genbean/UH1-Collective/Software/docs/as5600.md

# AS5600 angle sensors

An AS5600 is a magnetic angle sensor: a chip under a small magnet on a turning shaft. Given the angle range it should cover, a sensor set for, say, 35° of collective travel uses the **whole** of its reading for those 35°, instead of the tenth of it that 35° is out of a full turn. The HeliSR Rev 4.0 board reads the sensor over I²C on any AX port. The board keeps the range and writes it to the sensor every time it starts: nothing is burnt into the chip, and the range can be set again at any time.

> **Not tried on hardware yet.** No Rev 4.0 board has been built. The firmware's sensor code is tested on the PC against a model of the board's I²C switch and the AS5600 (see [Development](development.md#testing)), but not against real chips and cables.

The board has a **PCA9546A I²C switch**: every AS5600 has the same address, so each AX port has its own channel, and the firmware reads one port at a time. It reads each sensor's **ANGLE** register, which runs 0–4095 across the range set, and scales it to the same 0–4092 as an analog input. The start and stop are written to the chip's working registers (ZPOS and MPOS) every time the board starts, from settings the board keeps in its EEPROM. With them, the chip's settings register (CONF) is set to its factory state: full power, the standard filtering, no watchdog. So a module that someone has configured differently, even burnt, still reads the same. **Nothing is ever burnt into the chip**, so the range can be set as often as you like.

## Preparing the module

For the common WWZMDiB module (23 × 23 mm, Amazon B0CM3C8KFT), on the Pro Micro's 5 V (the board README's [AS5600 modules](../../PCB/HeliSR/README.md#as5600-modules) has the details):

- **Remove R1**, the 0 Ω link between VDD5V and VDD3V3. It puts 5 V on the chip's 3.3 V pin (absolute maximum 4.0 V). Without it, the chip's own regulator feeds that pin.
- **Remove R4**, the 1 kΩ from PGO (GPO) to GND: PGO low selects OUT-pin programming, where two 100 ms shorts of OUT to GND burn a range into the chip for good. Leave OUT unconnected.
- **Wire DIR** to GND or VCC; it floats on this module. It sets which way the angle rises (GND = clockwise, VCC = counterclockwise, seen from the chip's top face). If the angle falls from your start to your stop, the helper notices and sets the range the other way round (below).
- **Check the module's pull-ups** on SDA and SCL, with a meter, as the board README describes: none, 10 kΩ or 4.7 kΩ is fine; under 2 kΩ is too strong with the board's own 2.2 kΩ, so remove them. Remove them too if they go to the chip's 3.3 V pin rather than VCC.
- **Check for about 1 µF from VDD3V3 to GND** once R1 is off: on 5 V that pin is the chip's internal regulator output, which needs it. Add a 1 µF ceramic if the module has less.
- **Magnet:** a diametrically magnetised disc (5 × 2 mm is typical), centred over the chip, about 0.5–3 mm above it.

## Wiring

Any of **AX1–AX4 (J11–J14)**: pin 1 **SDA**, 2 **GND**, 3 **VCC** (5 V), 4 **SCL**. This is not the Qwiic / STEMMA QT order, on purpose: those boards are 3.3 V. On a long cable, twist SDA with GND and SCL with VCC.

## Setting the start and stop

On the **Board** page, with the board connected, each AX row says its sensor's state, and on the right is the **AS5600 sensors (I²C)** helper.

1. Assemble the mechanism with the sensor in place and plug the board into USB.
2. In the helper, pick the port. **State** should say **OK**, the **AGC** should be somewhere in the middle (it sits at an end when the magnet is too close or too far), and the **Raw angle** should follow the control.
3. Move the control to the end where the reading should start, and click **Set start**.
4. Move it to the other end, at least 18° away, and click **Set stop**. The helper follows the raw angle in between, so it knows which way you went and how far. The board saves the range at once, writes it to the sensor, and the state adds **range set on the sensor**.
5. The **Output** bar now runs from 0 at the start to 4095 at the stop. That's what the axis gets.
   - If the angle falls from your start to your stop (DIR is the other way), the helper sets the range the other way round and says so: the output then runs from 4095 at your start to 0 at your stop. Tick **Inverted** on the axes using that port, or wire DIR to the other side and set the range again.
6. Click **Use the sensor's whole output as the calibration** to set the calibration of every axis that uses that port to the full range (choose the port as an axis source on the Axes Config page first). Then **Write config to Device**.

**Whole circle** clears the range: the sensor reads 0–4095 over a full turn again. For a 360° control, set the wrap point with the axis's **Offset** instead.

The start and stop belong to the board, not to a profile: writing a profile, resetting the settings or updating the firmware leaves them alone. The helper saves them as soon as you click; there's no need to write the config for them.

## The I²C clock

**100 kHz** is the default and suits most cables. If a port with a long cable shows errors, choose **50 kHz** or **25 kHz** in the helper (10 kHz is there as a last resort). The board saves it at once. The firmware reads one port per pass, so a slower clock makes each pass longer: by about 1.7 ms at 100 kHz, 7 ms at 25 kHz and 17 ms at 10 kHz (calculated from the transfers, not measured). At 10 kHz the buttons and the USB reports slow down to match.

## Examples from the UH-1 collective

- **Collective, in the MkIII base, on AX1:** DIR to **VCC**. Set start with the collective fully **down**, set stop fully **up**.
- **Throttle, in the Huey head, on AX4:** DIR to **GND**. Set start at the **idle** stop, set stop at **full open**.

## Troubleshooting

| The state says | Why, and what to do |
|---|---|
| no sensor | Nothing answers on that port: check the cable, its pin order (SDA, GND, VCC, SCL) and the module's power. A sensor plugged in later gets its range as soon as it answers |
| no magnet / magnet too weak or too far | Move the magnet closer and centre it over the chip |
| magnet too strong or too close | Move it further away |
| the board's I²C switch doesn't answer | Every port says so: the PCA9546A or its pull-ups (R9–R11) aren't working. On a bare Pro Micro with HeliSR firmware this is normal |
| bus stuck: check this port's cable | Something on that port held a line low. The firmware resets the switch, leaves the port alone for a moment and carries on with the others. Check the cable for a short, and try a slower clock |
| errors keep counting on a long cable | Try a slower I²C clock, and check the pull-ups (the board README's [AS5600 modules](../../PCB/HeliSR/README.md#as5600-modules)) |
| range not set on the sensor yet | The board couldn't write the start and stop, or the chip didn't keep them; it tries again every few visits |

A chip whose range was burnt in before (through its OUT pin, or over I²C elsewhere) may still work once R4 is removed: the board writes its own start and stop over the burnt ones every time it starts. Whether a burnt chip keeps them hasn't been tried; if it doesn't, its state says "range not set on the sensor yet".
