genbean/UH1-Collective/Software/docs/development.md

# Development

How the HeliSR software is put together, built and tested. [`PLAN.md`](../PLAN.md) has the design decisions and what each phase found; [`NOTICE.md`](../NOTICE.md) lists the changes from FreeJoy.

## Folders

| Folder | What's in it |
|---|---|
| `firmware/HeliSR/` | The firmware, an Arduino sketch, for the HeliSR Rev 4.0 board: `board.cpp` has the board's pins, and `i2c.cpp` and `sensors.cpp` are its I²C bus, PCA9546A and AS5600s |
| `firmware/HeliSR/src/shared/` | The settings layout (`helisr_config.h`), factory settings (`helisr_defaults.h`) and USB protocol (`helisr_protocol.h`), compiled into both the firmware and the configurator |
| `firmware/build.ps1` | Builds the firmware |
| `firmware/test/` | Test tools for a Pro Micro: the settings channel and joystick (`hsr-usb-test.ps1`), flashing through the bootloader command (`hsr-flash-via-bootloader.ps1`), a logic test (`hsr-logic-test.ps1`), and the lockstep replay of the PC tests (`hsr-lockstep.ps1`). Shared helpers are in `hsr-usb-lib.ps1` |
| `firmware/test/host/` | The PC tests: the firmware's logic compiled for the PC, the scenario tests, the comparison with FreeJoy's own code, and the sensor code against a simulated I²C bus (`sensor_tests.cpp`) |
| `configurator/` | HeliSR Configurator, forked from FreeJoyConfiguratorQt. See [its README](../configurator/README.md) |
| `profiles/` | The example profiles and the script that makes them |
| `packaging/` | The release build, installer script and release checklist. See [its README](../packaging/README.md) |
| `docs/` | These pages |

## Building the firmware

You need the Arduino IDE 2.x, with "Arduino AVR Boards" installed (it comes with the IDE). Then, in PowerShell:

```powershell
cd Software\firmware
.\build.ps1             # the release build: 5 V / 16 MHz Pro Micro, no USB serial port
.\build.ps1 -Serial     # with the Arduino USB serial port, so the Arduino IDE can upload without a double tap
.\build.ps1 -Port COM5  # build and upload
```

The `.hex` lands in `firmware\build\<variant>\HeliSR.ino.hex`: `noserial`, `serial` or `noserial-test`. The options combine. Only the 5 V / 16 MHz Pro Micro is supported.

The firmware is for the HeliSR Rev 4.0 board only (`HSR_BOARD_ID` in `shared/helisr_config.h`): the shift registers on A0, 14 and 15, the AS5600s over I²C, and the JTAG switch-off (A0 and A1 are also JTAG pins). Firmware for another board could drive the board's lines against its own chips, so every build carries a tag saying which board it's for (`hsr_build_tag_t`), INFO reports it, and the app refuses a device or a `.hex` tagged for another board.

The build uses the Arduino IDE's own `arduino-cli` and the Arduino AVR core 1.8.8 (`arduino:avr:leonardo`). The firmware registers its own USB functions (a joystick and a settings channel) through the core's PluggableUSB, so the core itself is unmodified.

## Building the configurator

Qt 6 with MinGW, then `qmake` and `mingw32-make`: see [configurator/README.md](../configurator/README.md#building).

## Building a release

`packaging\build-release.ps1` builds the firmware and the configurator, and packs them with Qt, avrdude, the example profiles and the licences into `HeliSR-Configurator-x.y.z-Setup.exe` and a portable zip. See [packaging/README.md](../packaging/README.md), which also has the release checklist.

## How the app and the firmware talk

The board is a USB composite device: a joystick that games read, and a vendor-defined HID collection (usage page 0xFF00) that only the configurator uses. Each settings packet is 64 bytes: report ID, command, index, status and 60 bytes of data, and the board answers every command. INFO comes first; the app refuses a board whose protocol version, settings version or settings size differs from its own, or whose board ID isn't HeliSR Rev 4.0's (0x40). Settings go over in 60-byte chunks (READ / WRITE), then COMMIT with a CRC-16; the board saves them to EEPROM and restarts so Windows sees the new name and layout. `helisr_protocol.h` has the details.

Three commands are for the AS5600s: SENSOR_STATUS (each AS5600's state, raw angle, output angle, AGC and error count, about 20 times a second while the app is open), SENSOR_CONFIG (the I²C clock and each sensor's start and stop) and SENSOR_DEBUG (one port's sensor read in full, every register as the chip sent it, with that port's counters; only while the helper's Diagnostics box is ticked, as each read holds the board up for a few ms). The sensor settings are kept in EEPROM apart from the main settings and saved at once, without a restart: they belong to the board's sensors, not to a profile. The live data's A2/A3 readings come after the older fields, which keep their places.

## Testing

**Firmware logic on the PC** (needs MinGW-w64 g++, for example Qt's: `aqt install-tool windows desktop tools_mingw1310 qt.tools.win64_mingw1310`):

```powershell
cd Software\firmware\test\host
.\run-host-tests.ps1                               # 416 checks: 192 of the firmware's logic, 224 of the sensor code
.\run-host-tests.ps1 -FreeJoy <FreeJoy checkout>   # also compare with FreeJoy's own code on random settings
```

The sensor checks run `sensors.cpp` against a model of the board's PCA9546A and an AS5600 on each channel: the channel of each port, the registers and byte order, the 1 ms waits between ZPOS, MPOS and CONF, the read-back, CONF set over settings burnt into a chip, that nothing is ever burnt, the diagnostics read and its counters, and what happens when a sensor is unplugged or restarts, the switch is missing, or the bus sticks. The model follows the datasheets as the code reads them, so it can't show that the chips agree: that waits for a Rev 4.0 board.

**The same scenarios on a Pro Micro**, in lockstep with the PC:

```powershell
cd Software\firmware
.\build.ps1 -Test                                  # then flash build\noserial-test\HeliSR.ino.hex
cd test
.\host\run-host-tests.ps1 -Trace host\build\trace.txt -Random 10
.\hsr-lockstep.ps1 -Trace host\build\trace.txt
```

Flash the normal build afterwards: the test firmware ignores the board's inputs once a lockstep run has started.

**The configurator:**

```
HeliSRConfigurator --ui-test 200                  random settings through every page and back (no board needed)
HeliSRConfigurator --ui-test-file a.cfg b.cfg     profiles through every page and back
HeliSRConfigurator --roundtrip                    write, read back and compare, then restore (needs a board)
HeliSRConfigurator --ui-device-test               the same through the window's Write and Read buttons
HeliSRConfigurator --hex-info file.hex            which board a firmware file is for
HeliSRConfigurator --sensor-roundtrip             the AS5600 settings saved, read back, kept through a restart, refused out of range, restored
HeliSRConfigurator --sensor-debug [1-4] [--clear] every register of each sensor (or one), decoded, with counters and hints
HeliSRConfigurator --ui-screenshot board.png      a picture of the Board page (with made-up sensor readings)
```

Run them after any change to the configurator or the shared headers. `--sensor-roundtrip` needs the firmware but no sensors: on a bare Pro Micro the settings still save, and every port reads "no switch".

## Example profiles

```powershell
cd Software\profiles
python make_profiles.py
```

It starts from `Default (16 buttons, 4 axes).cfg`. If the firmware's factory settings change, remake that first with `HeliSRConfigurator --save-defaults "Default (16 buttons, 4 axes).cfg"`.
