genbean/UH1-Collective/Base/renders/rev3_anchor.png

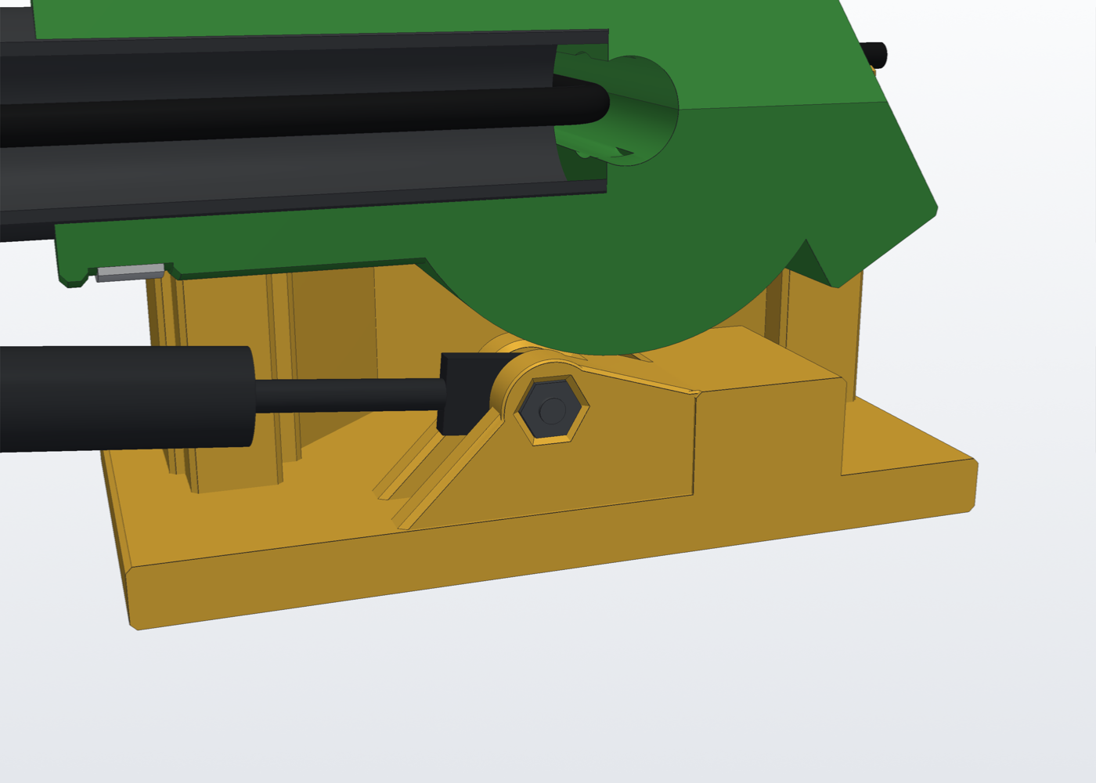
Base/renders/rev3_anchor.png
