genbean/UH1-Collective/Base/renders/rev3_base_front.png

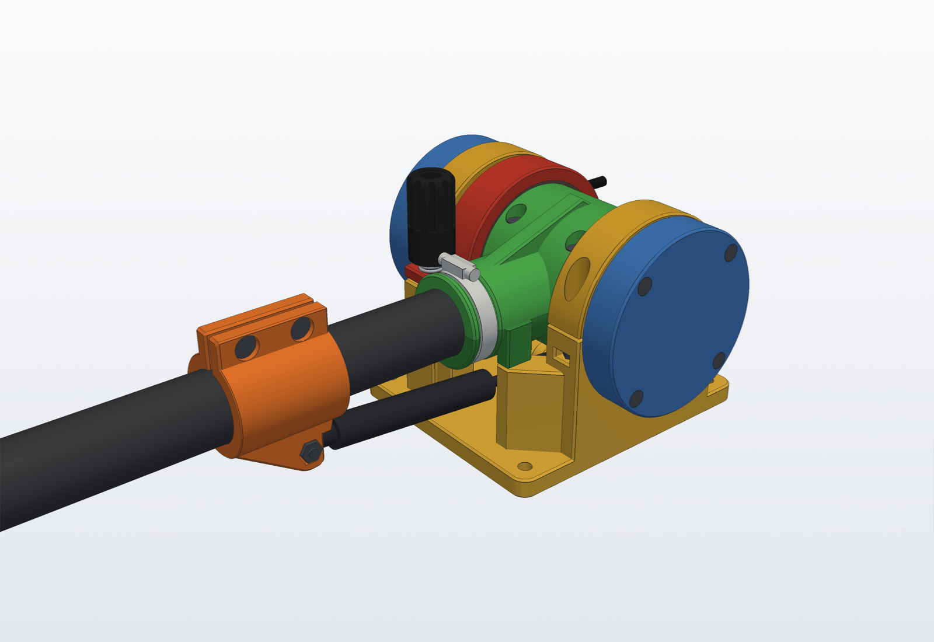
Base/renders/rev3_base_front.png
