genbean/UH1-Collective/Base/renders/rev3_base_rear.png

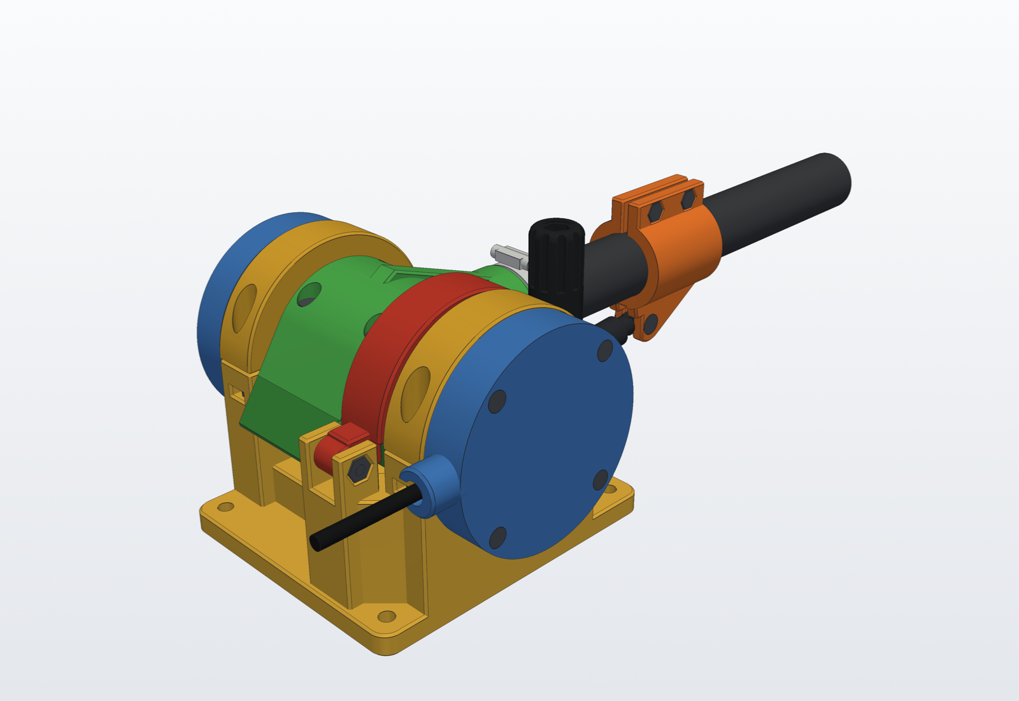
Base/renders/rev3_base_rear.png
