genbean/UH1-Collective/Base/renders/rev3_downstop.png

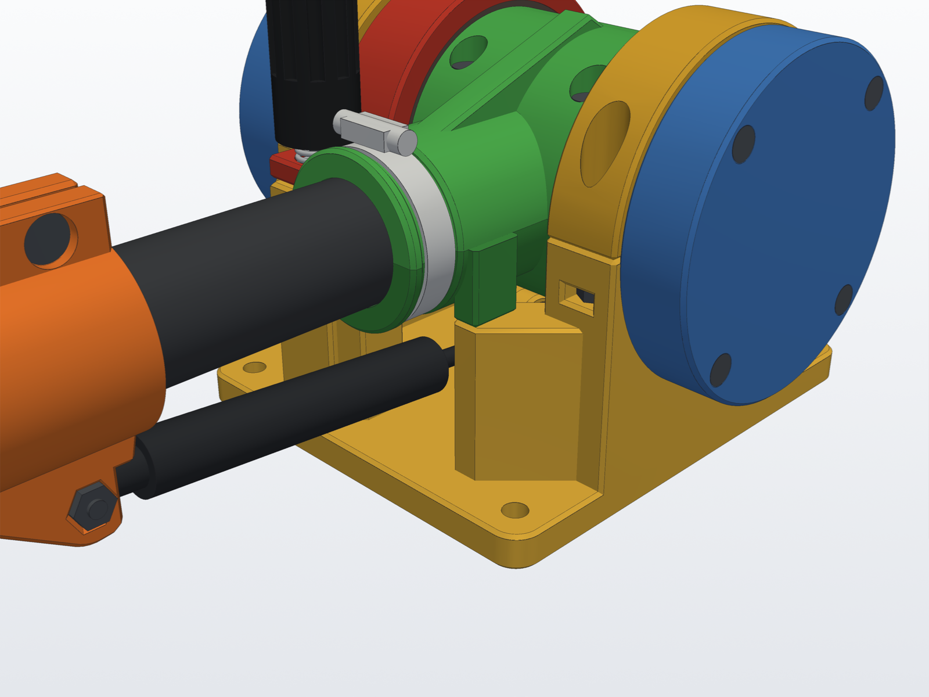
Base/renders/rev3_downstop.png
