genbean/UH1-Collective/Base/renders/rev3_exploded.png

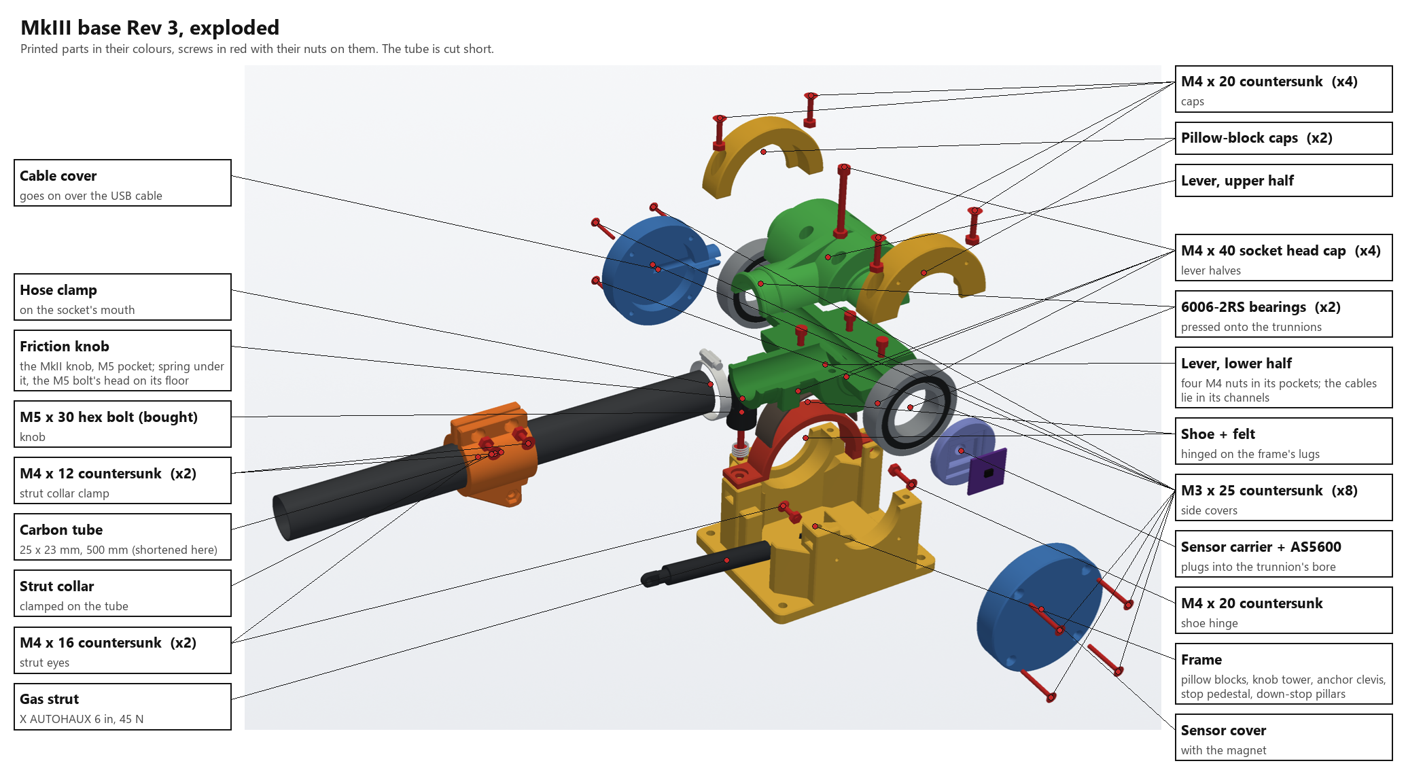
Base/renders/rev3_exploded.png
