genbean/UH1-Collective/Base/renders/rev3_frame_plan.png

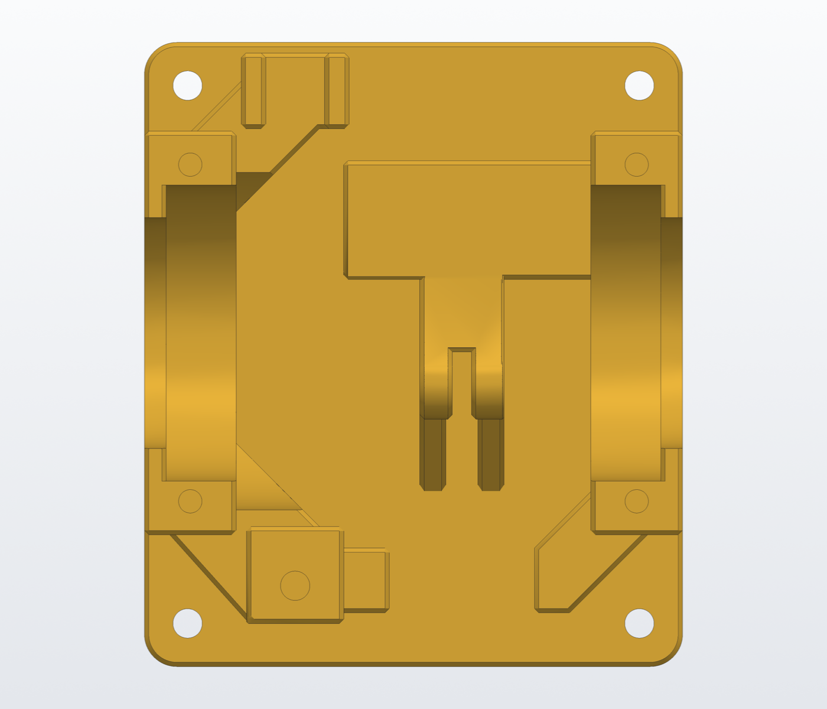
Base/renders/rev3_frame_plan.png
