genbean/UH1-Collective/Base/renders/rev3_full.png

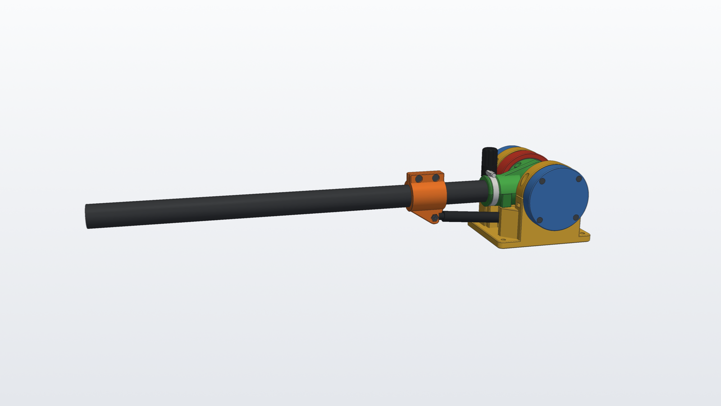
Base/renders/rev3_full.png
