genbean/UH1-Collective/Base/renders/rev3_hero.png

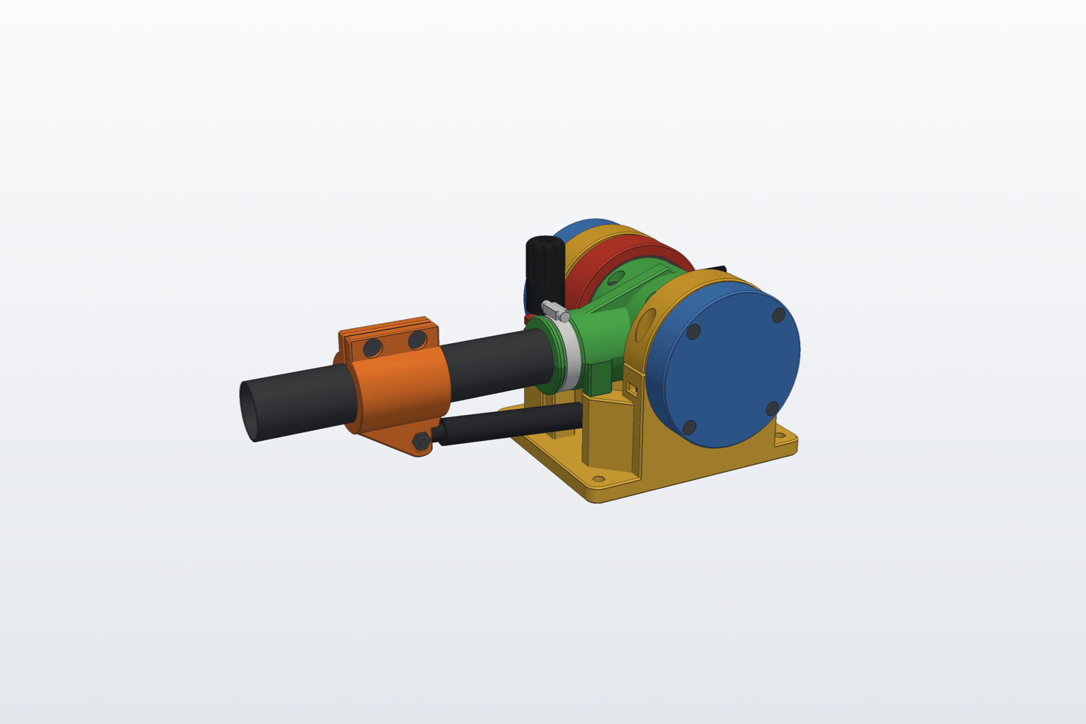
Base/renders/rev3_hero.png
