genbean/UH1-Collective/Base/renders/rev3_lever_lower.png

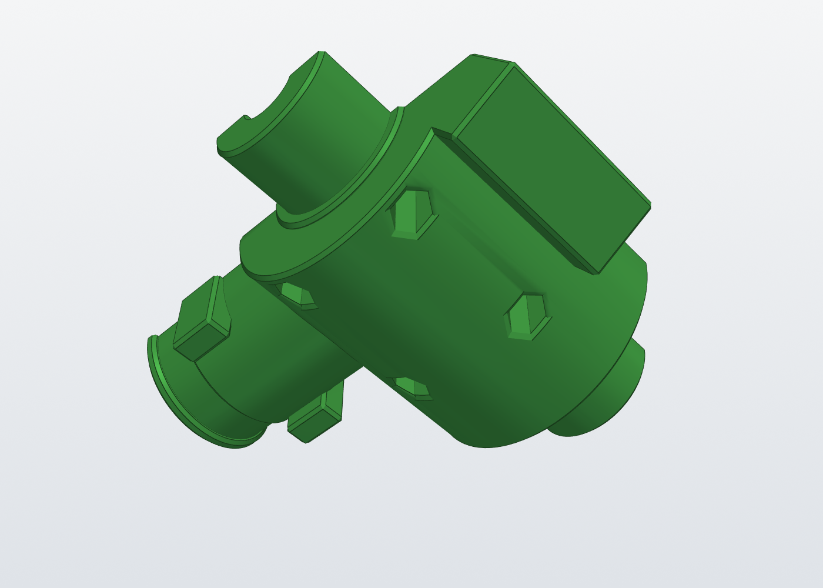
Base/renders/rev3_lever_lower.png
