genbean/UH1-Collective/Base/renders/rev3_lug_gusset.png

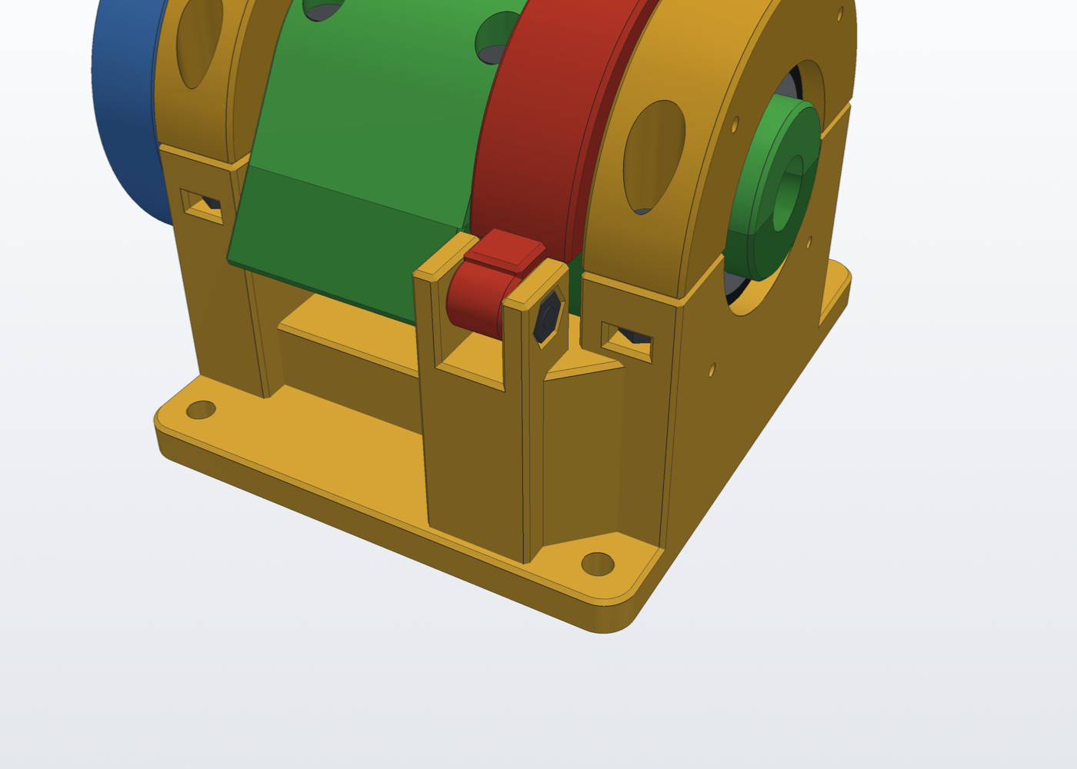
Base/renders/rev3_lug_gusset.png
