genbean/UH1-Collective/Base/renders/rev3_screw_sizes.png

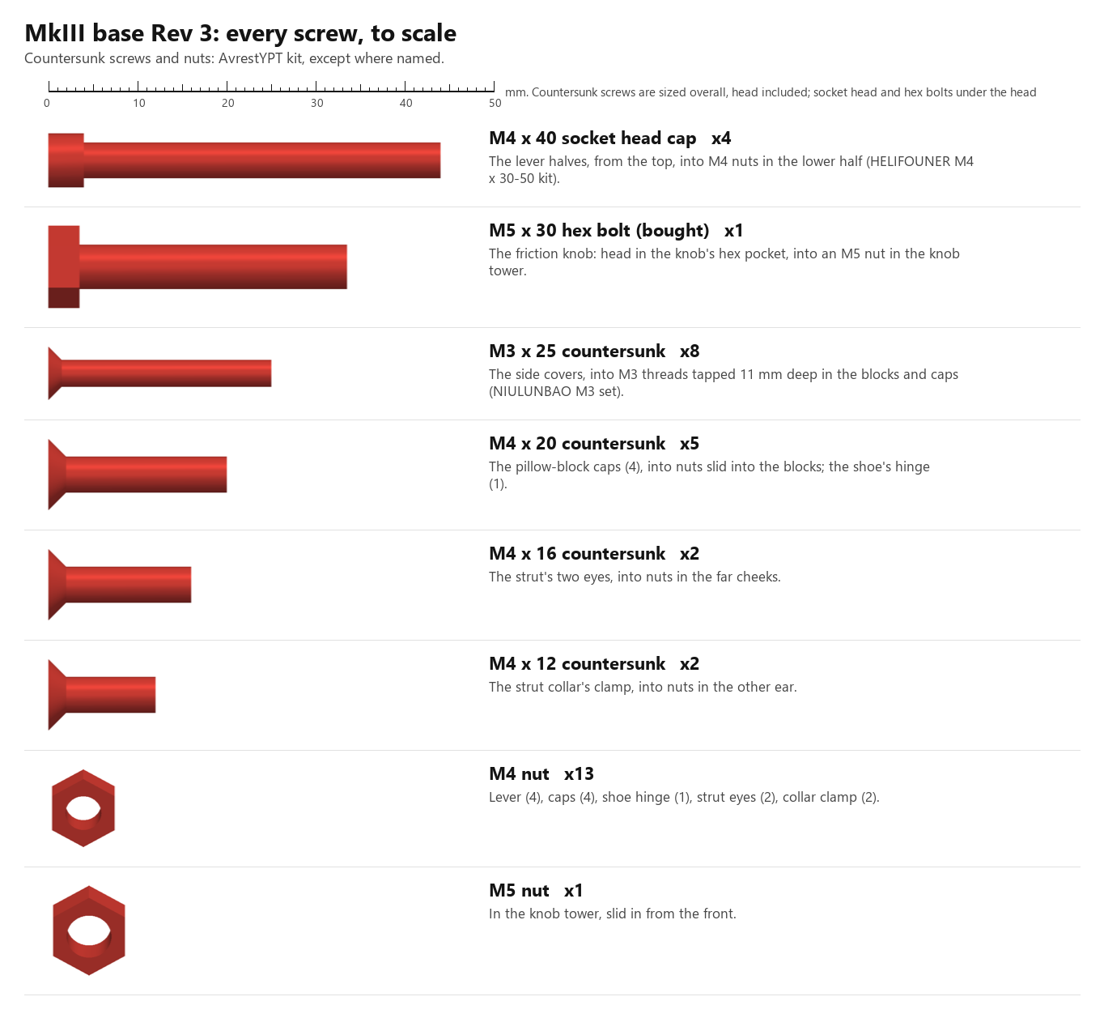
Base/renders/rev3_screw_sizes.png
