genbean/UH1-Collective/Base/renders/rev3_screws_front.png

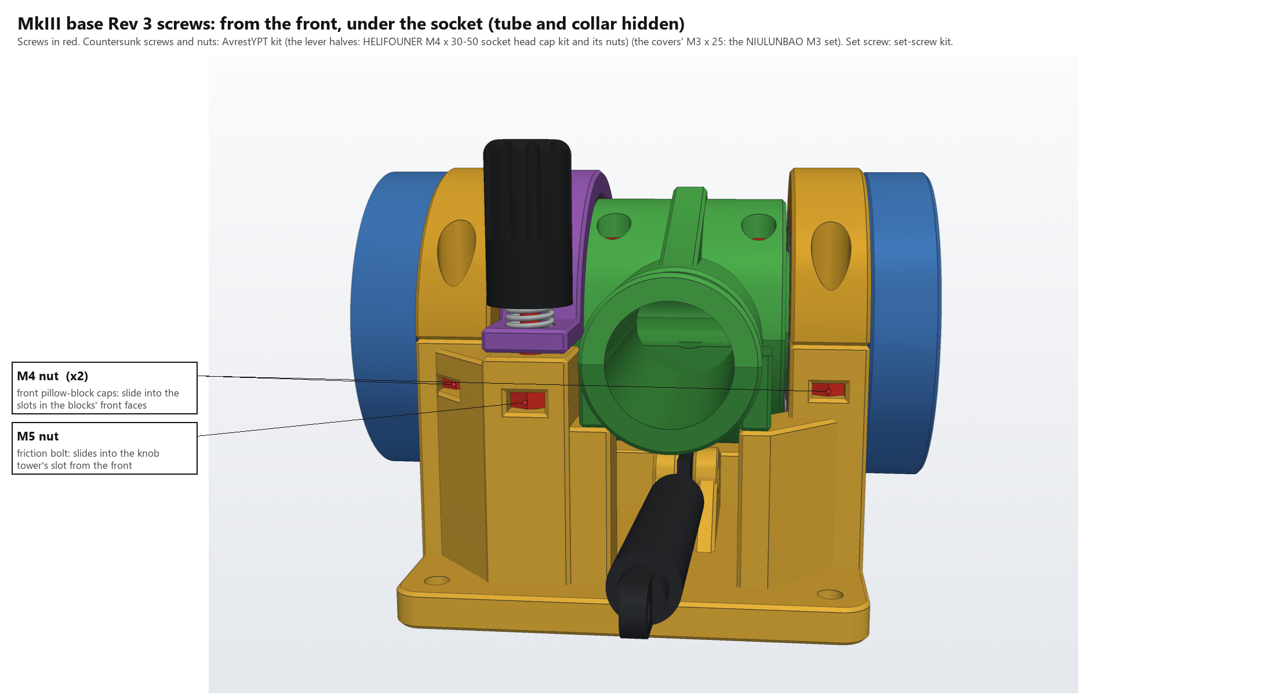
Base/renders/rev3_screws_front.png
