genbean/UH1-Collective/Base/renders/rev3_screws_knobside.png

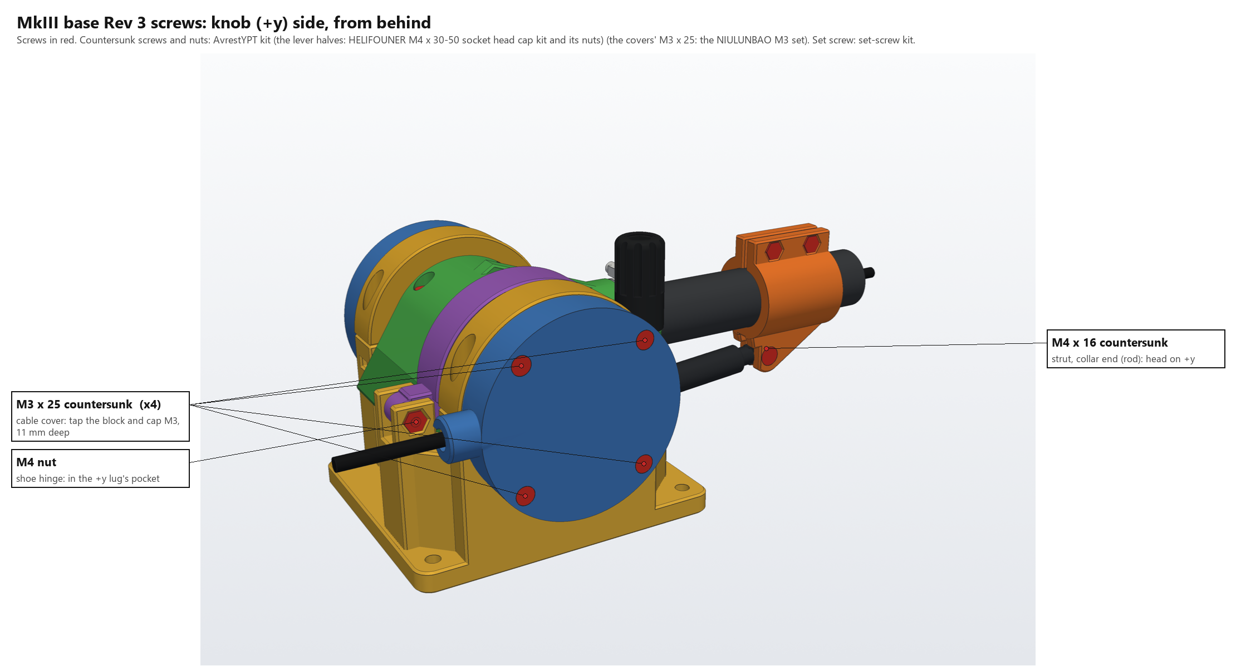
Base/renders/rev3_screws_knobside.png
