genbean/UH1-Collective/Base/renders/rev3_screws_plug.png

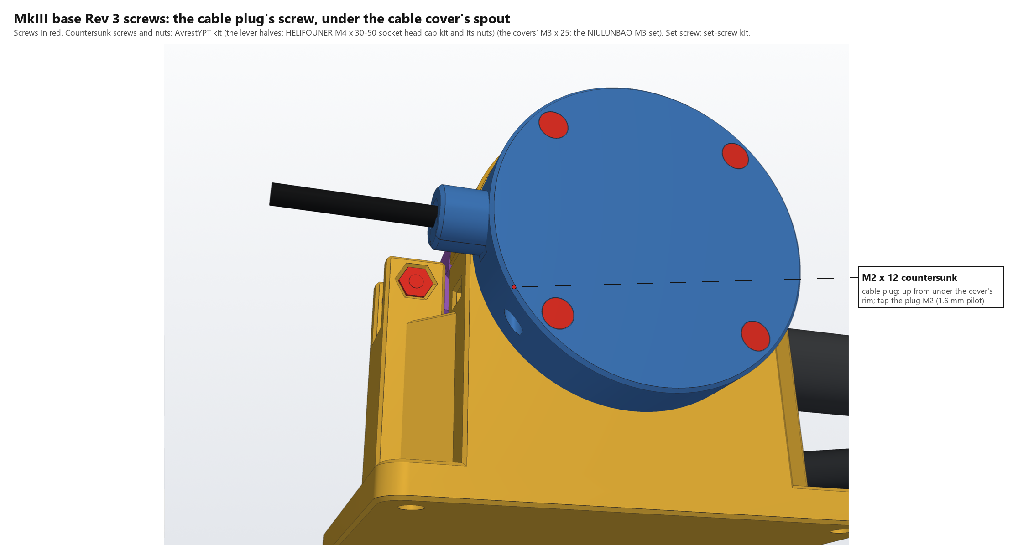
Base/renders/rev3_screws_plug.png
