genbean/UH1-Collective/Base/renders/rev3_screws_sensorside.png

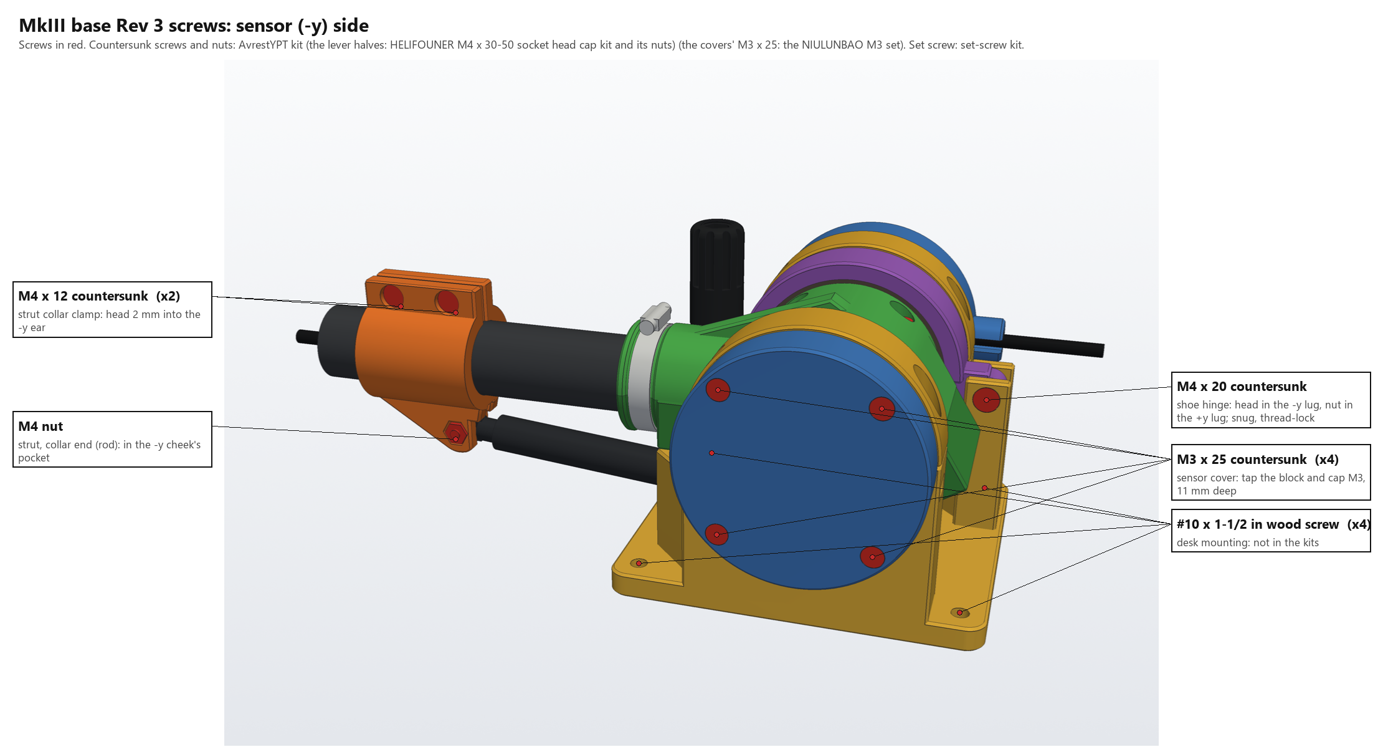
Base/renders/rev3_screws_sensorside.png
