genbean/UH1-Collective/Base/renders/rev3_screws_strut.png

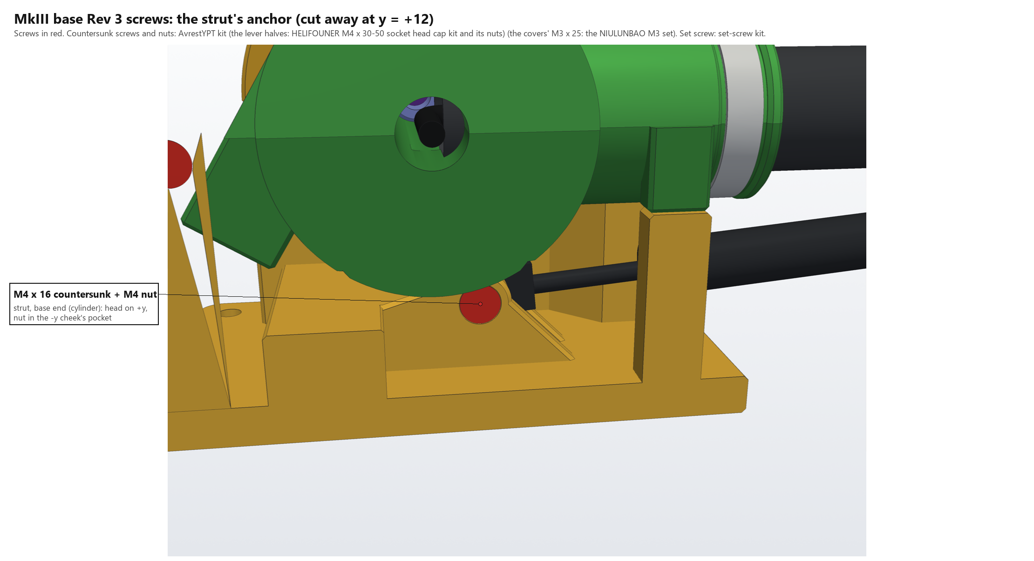
Base/renders/rev3_screws_strut.png
