genbean/UH1-Collective/Base/renders/rev3_screws_top.png

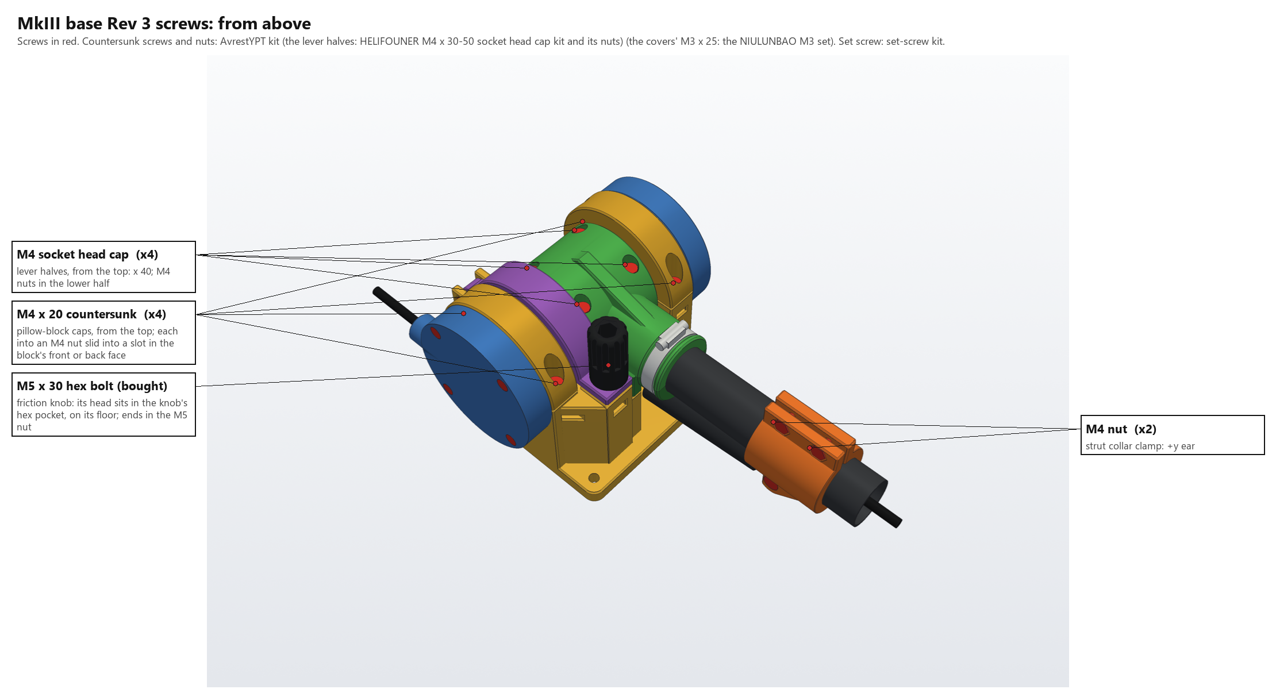
Base/renders/rev3_screws_top.png
