genbean/UH1-Collective/Base/renders/rev3_section32.png

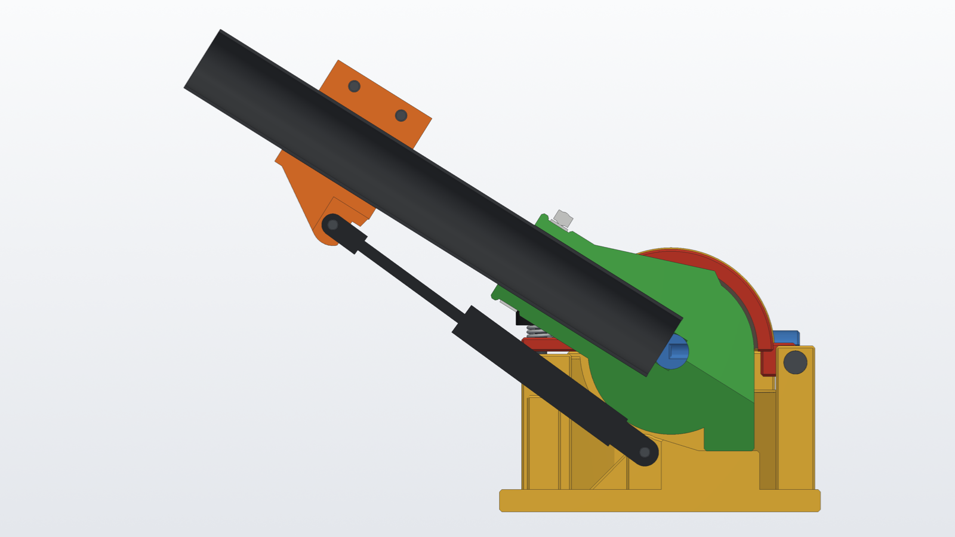
Base/renders/rev3_section32.png
