genbean/UH1-Collective/Base/renders/rev3_section.png

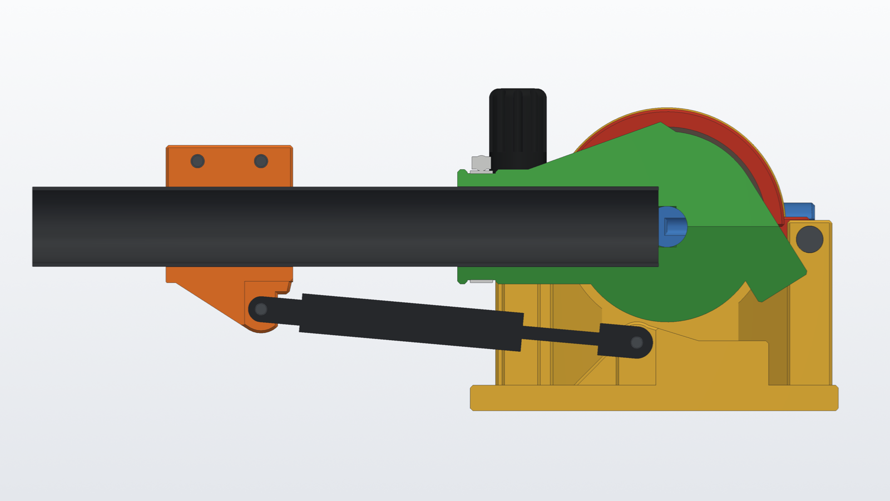
Base/renders/rev3_section.png
