genbean/UH1-Collective/Base/renders/rev3_upstop.png

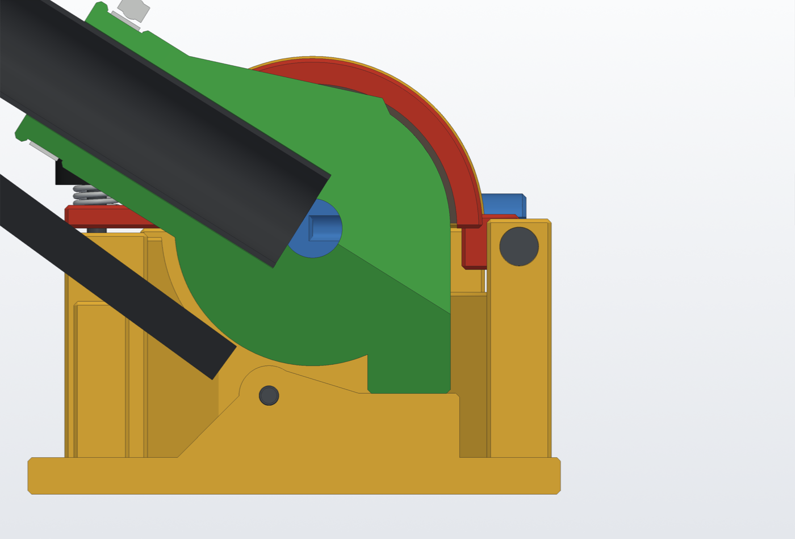
Base/renders/rev3_upstop.png
