genbean/UH1-Collective/Base/renders/rev3_upstop_rear.png

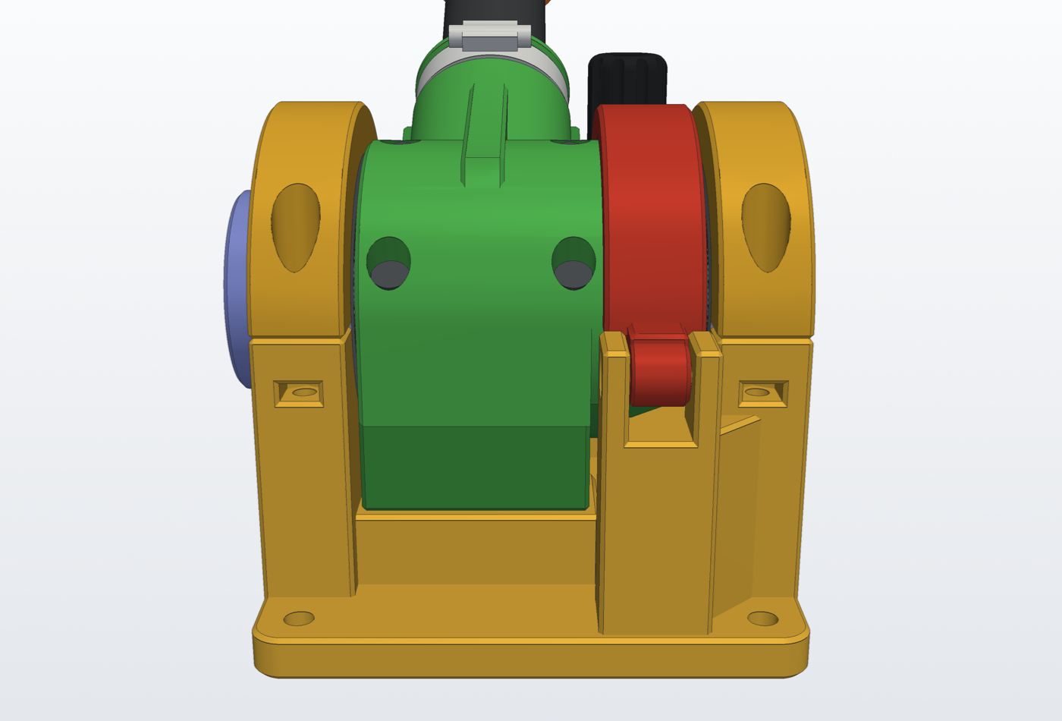
Base/renders/rev3_upstop_rear.png
