genbean/UH1-Collective/Base/renders/strut_balance.png

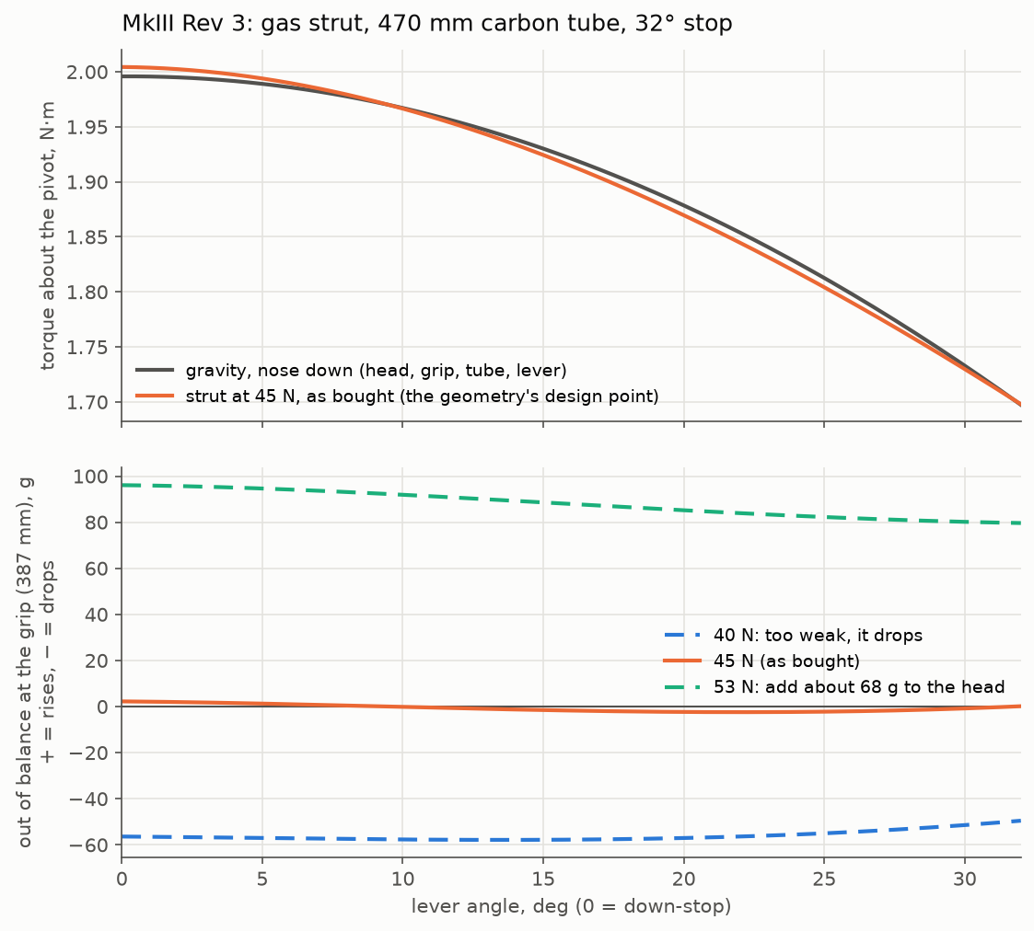
Base/renders/strut_balance.png
