genbean/UH1-Collective/Base/Rev4/renders/rev4_back_plate.png

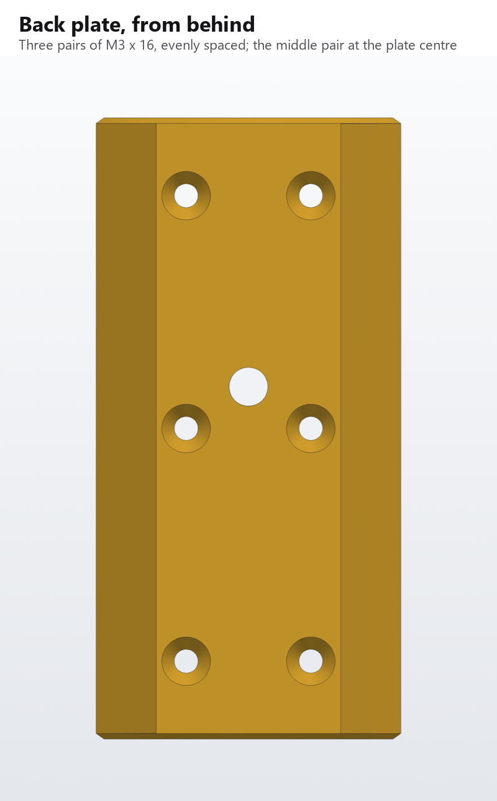
Base/Rev4/renders/rev4_back_plate.png
