genbean/UH1-Collective/Base/Rev4/renders/rev4_screws_front.png

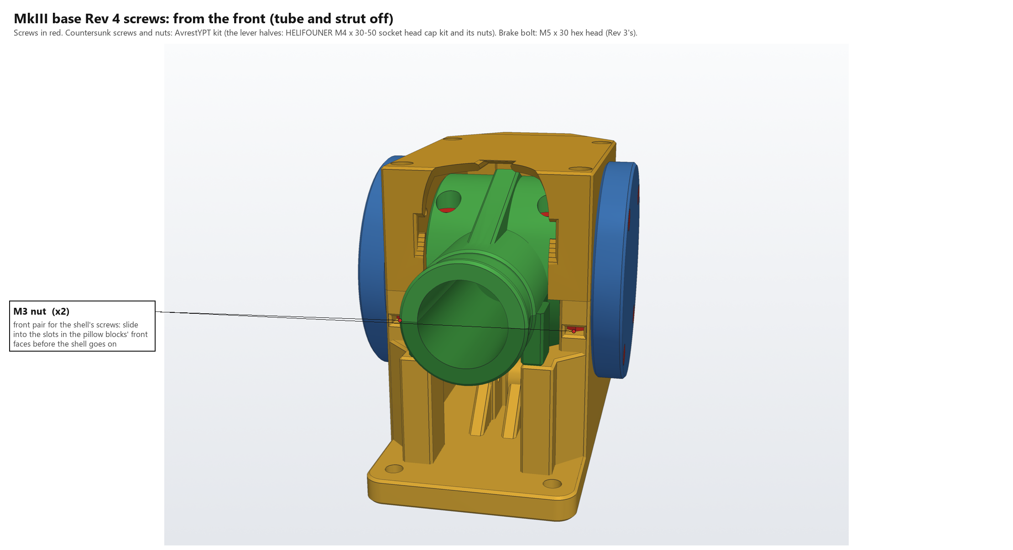
Base/Rev4/renders/rev4_screws_front.png
