genbean/UH1-Collective/Base/Rev4/renders/rev4_screws_levernuts.png

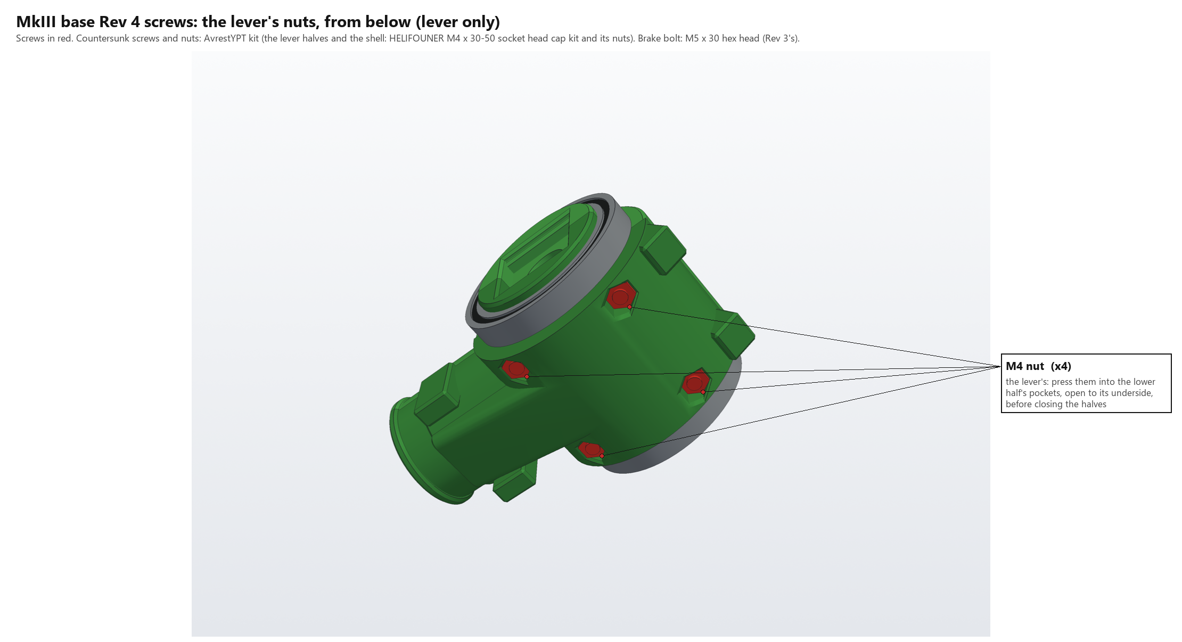
Base/Rev4/renders/rev4_screws_levernuts.png
