genbean/UH1-Collective/Base/Rev4/renders/rev4_trunnion_profile.png

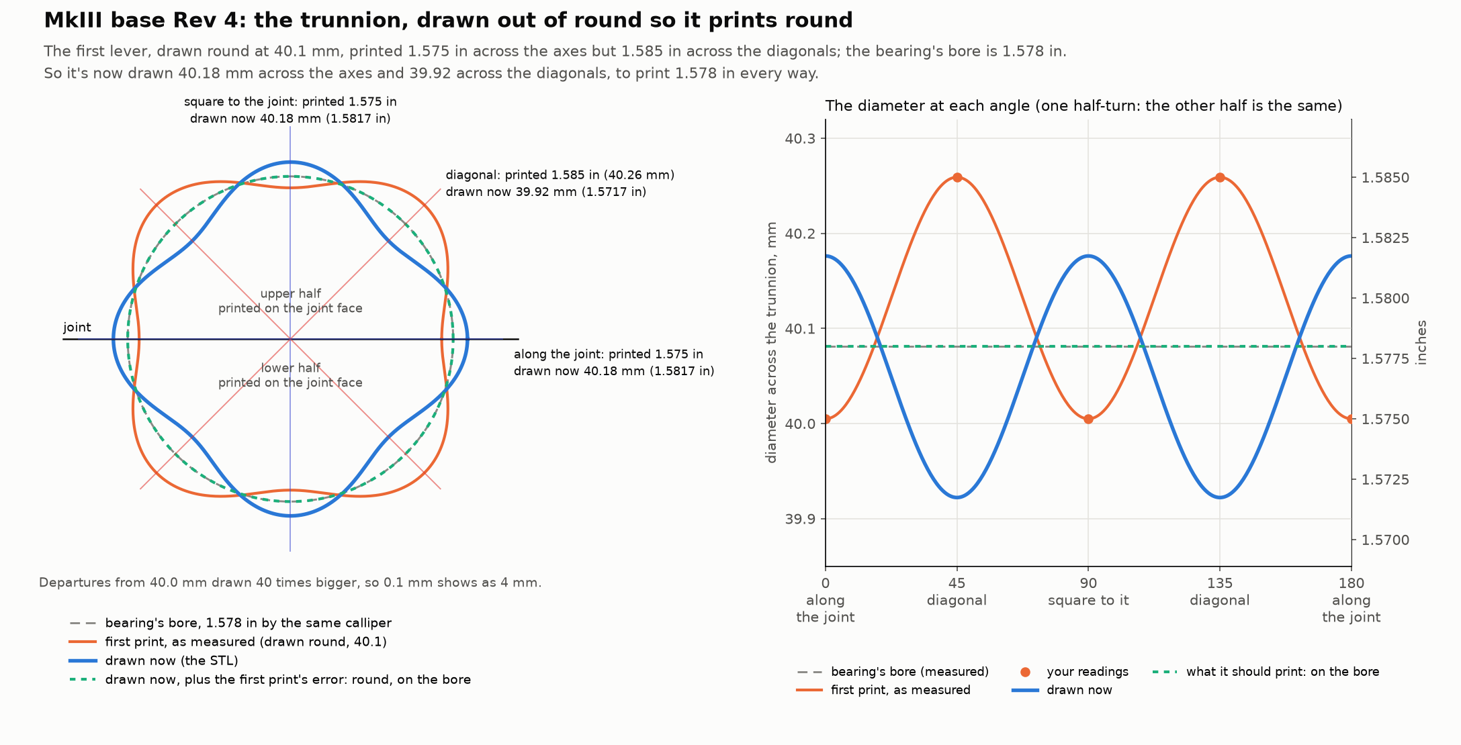
Base/Rev4/renders/rev4_trunnion_profile.png
