genbean/UH1-Collective/Base/Rev4/renders/strap_concept/strap_frame_iso.png

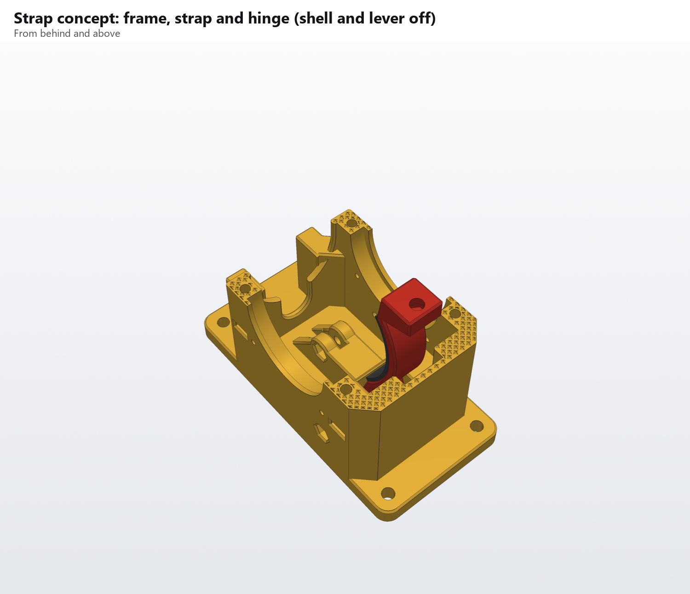
Base/Rev4/renders/strap_concept/strap_frame_iso.png
