genbean/UH1-Collective/Base/Rev4/renders/strap_concept/strap_frame_top.png

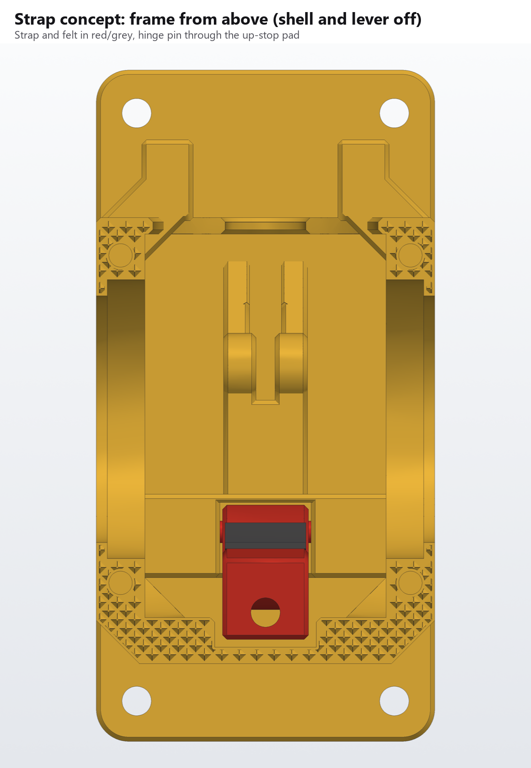
Base/Rev4/renders/strap_concept/strap_frame_top.png
