genbean/UH1-Collective/Base/Rev4/renders/strap_concept/strap_iso.png

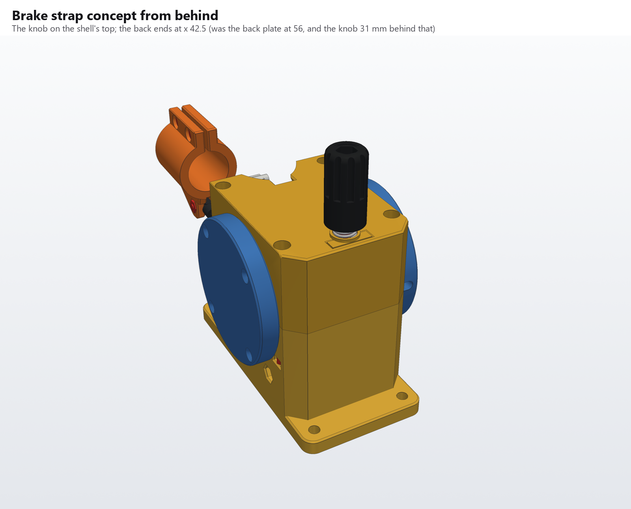
Base/Rev4/renders/strap_concept/strap_iso.png
