genbean/UH1-Collective/Base/Rev4/renders/strap_concept/strap_section_0deg.png

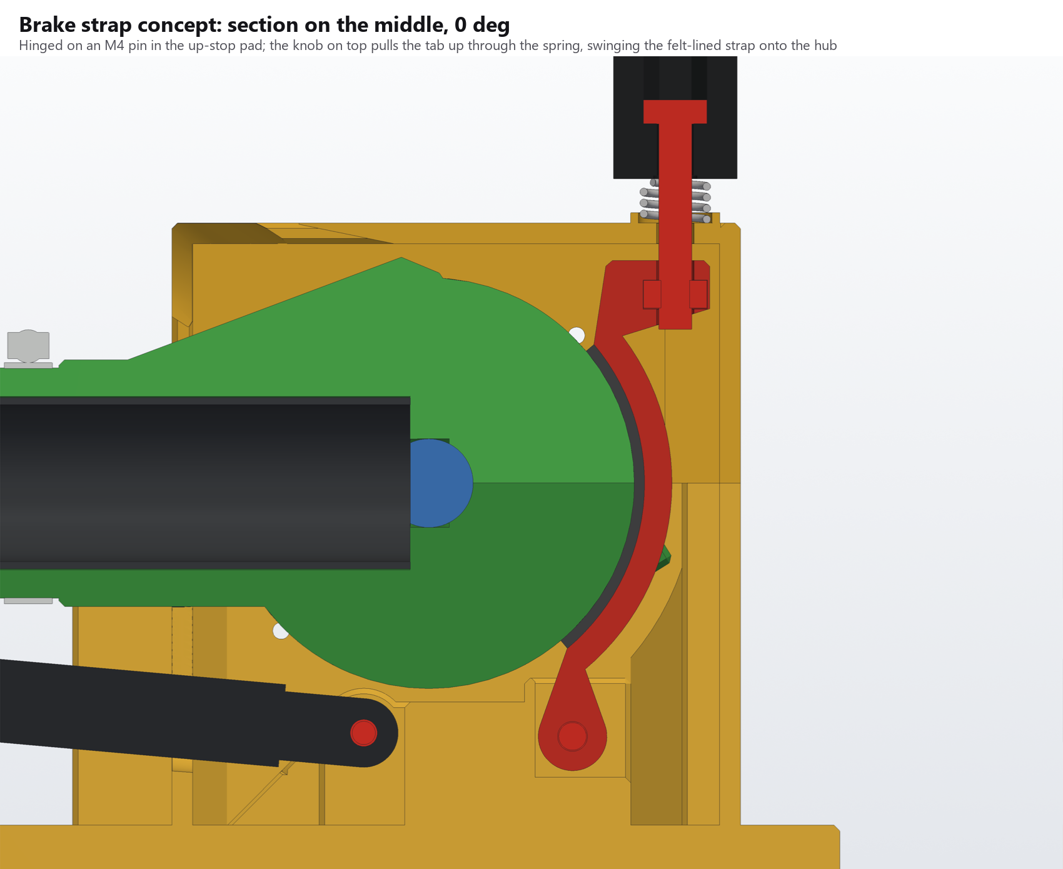
Base/Rev4/renders/strap_concept/strap_section_0deg.png
