genbean/UH1-Collective/Head/reference/kornskydiver/IMG_8534.jpg

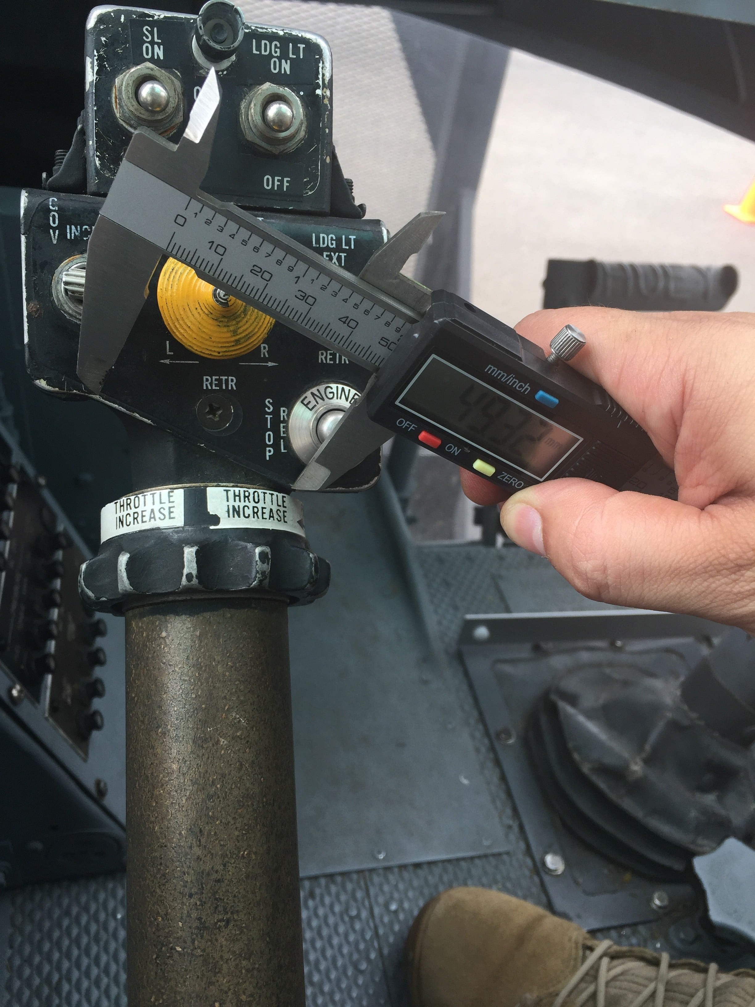
Head/reference/kornskydiver/IMG_8534.jpg
