genbean/UH1-Collective/Head/reference/kornskydiver/IMG_8540.jpg

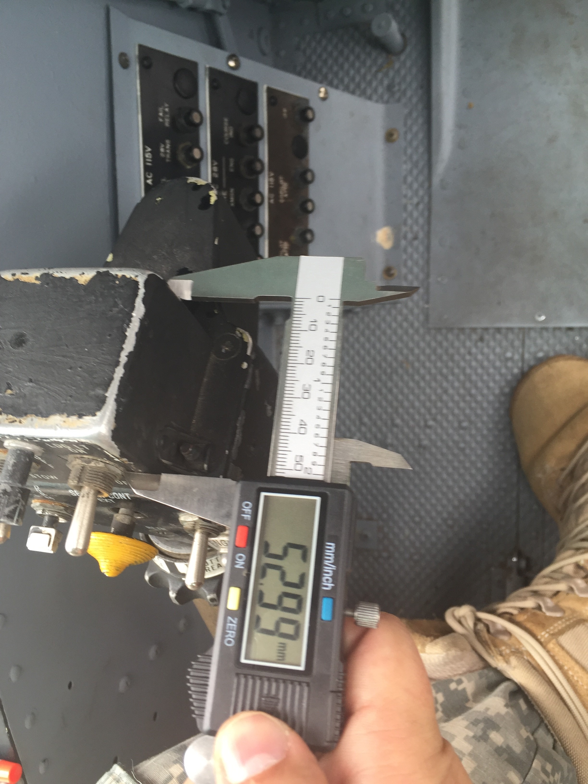
Head/reference/kornskydiver/IMG_8540.jpg
