genbean/UH1-Collective/Head/renders/HueyHead_Rev2_BearingCoupons.png

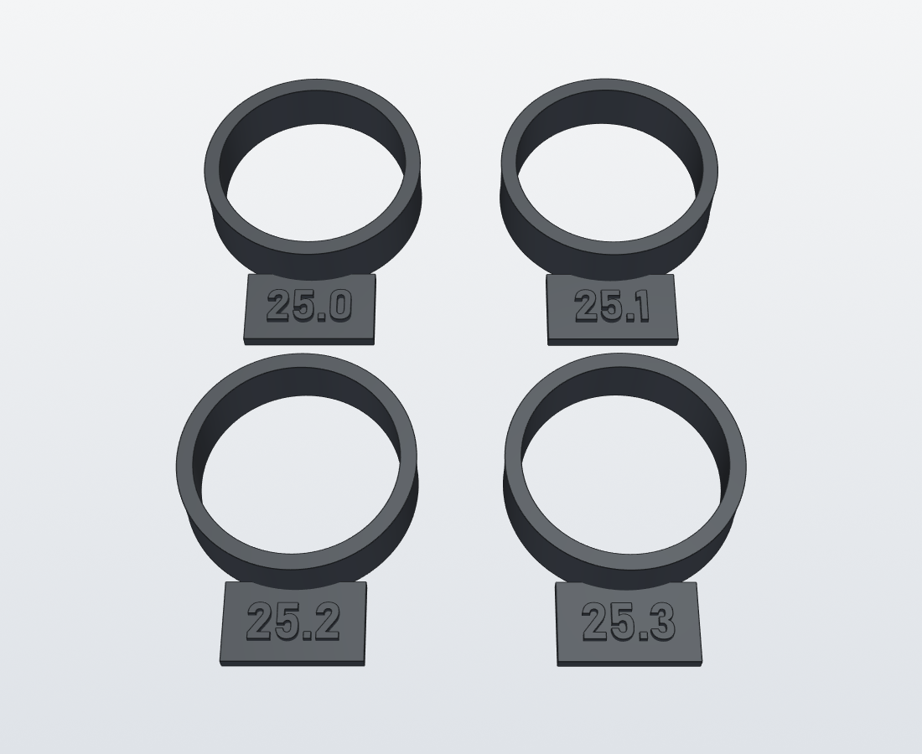
Head/renders/HueyHead_Rev2_BearingCoupons.png
