genbean/UH1-Collective/Head/renders/HueyHead_Rev2_IdleGate.png

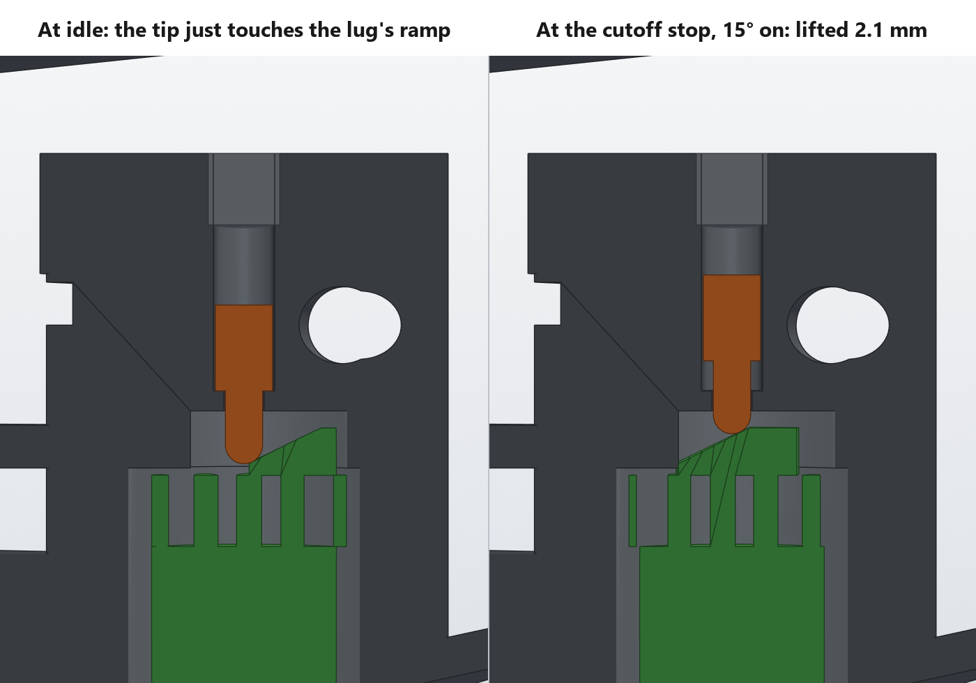
Head/renders/HueyHead_Rev2_IdleGate.png
