genbean/UH1-Collective/Head/renders/HueyHead_Rev2_Underside.png

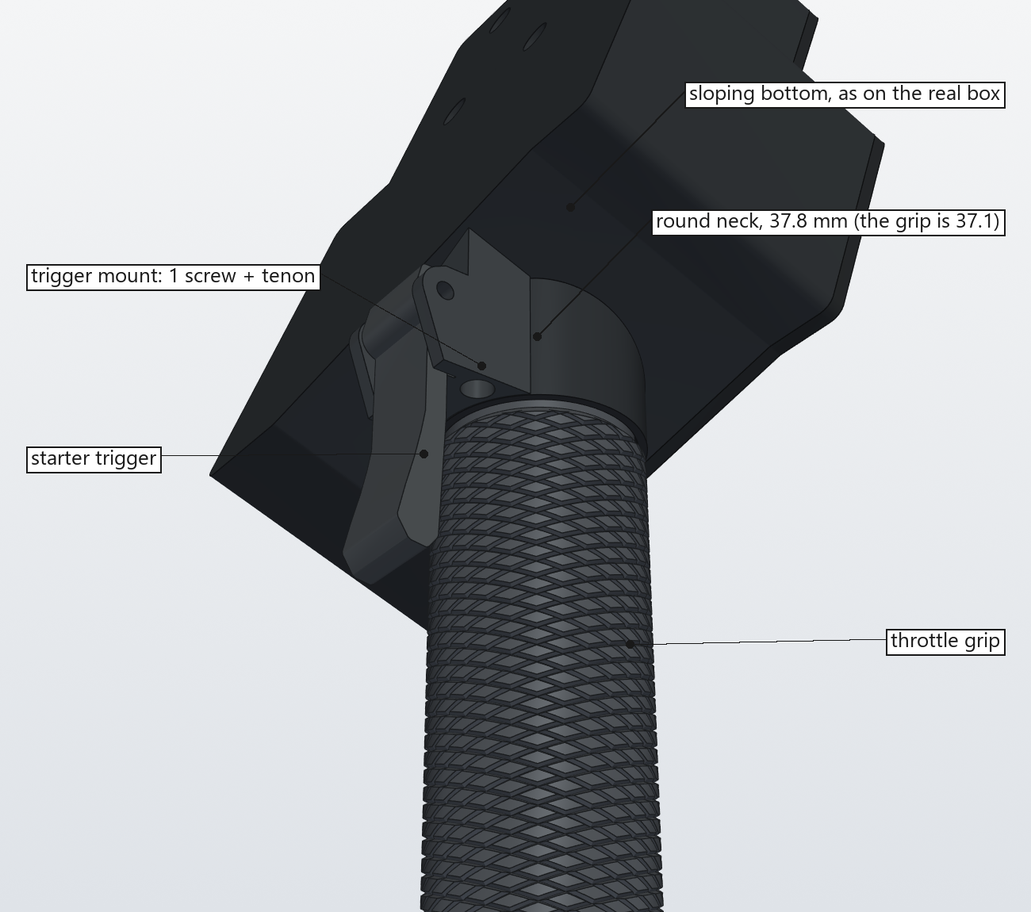
Head/renders/HueyHead_Rev2_Underside.png
