genbean/UH1-Collective/PCB/HeliSR/HeliSR_Rev4.0_Top.png

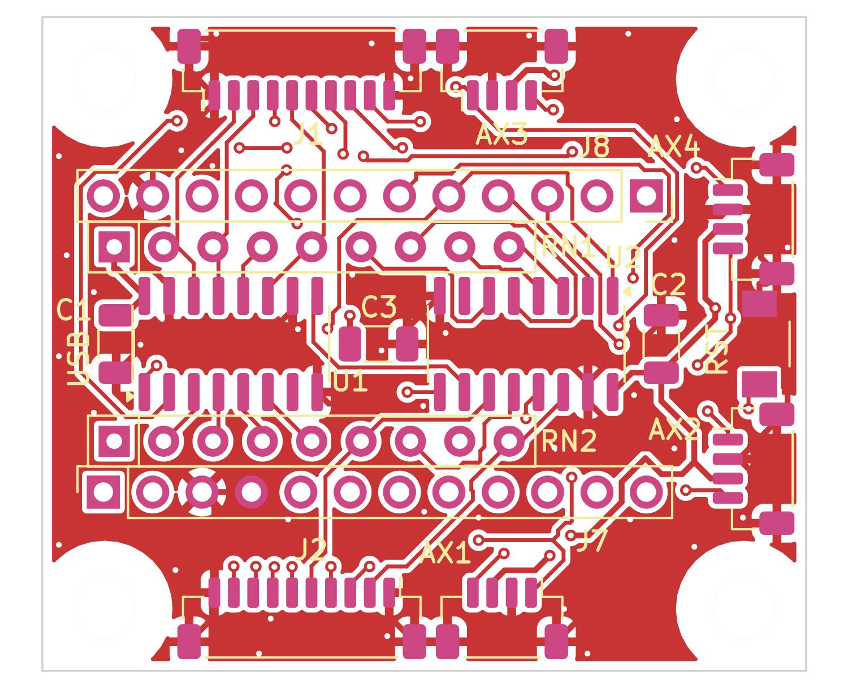
PCB/HeliSR/HeliSR_Rev4.0_Top.png
