genbean/UH1-Collective/renders/HeliCollective_32deg.png

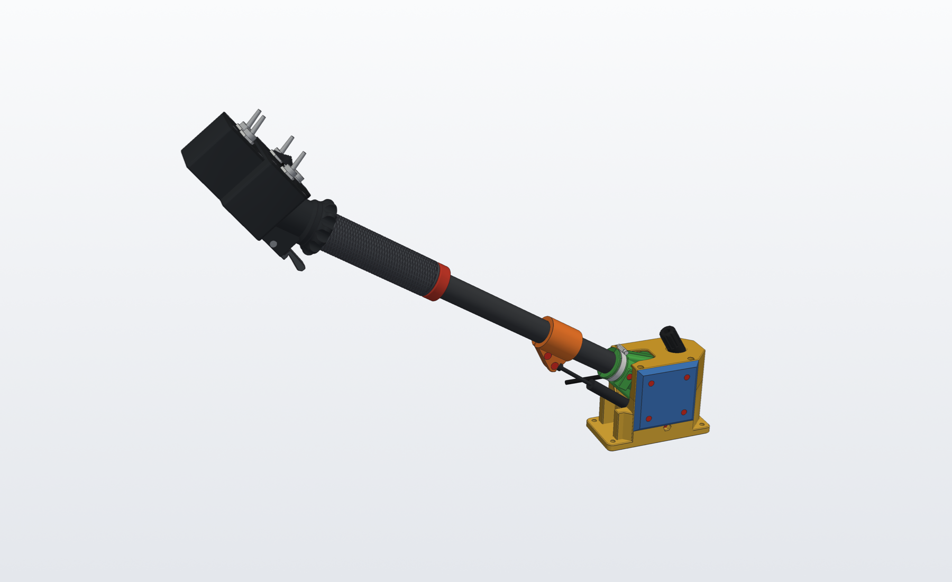
renders/HeliCollective_32deg.png
