genbean/UH1-Collective/renders/HeliCollective_side.png

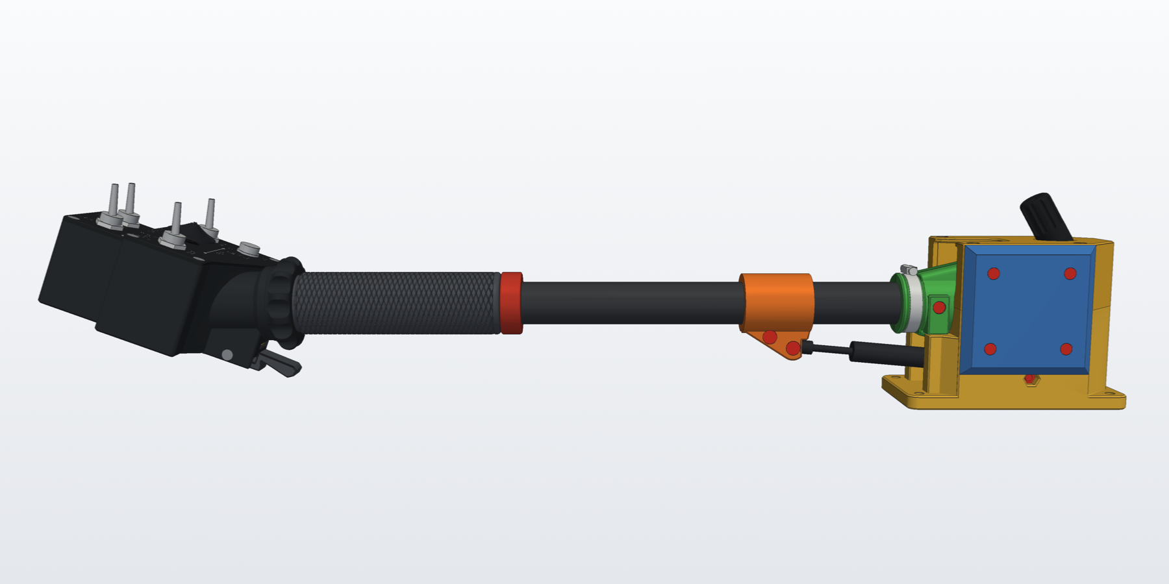
renders/HeliCollective_side.png
