genbean/UH1-Collective/BOM/Heli_Collective_BOM.xlsx

Sheet: BOM
Heli Collective - bill of materials
Everything to buy for one collective. Prices checked 2026-11-13, USD, before shipping; Amazon, MonsterBolts and OSH Park prices are per pack or order (Buy counts packs). Buy is the cheapest quantity (10 can cost less than 8). Tariff is Mouser's estimate for US delivery; Total includes it. Tick Done to strike a line through.
Done | Where | Qty used | Part | Manufacturer | Mfr part number | Supplier | Supplier part number | Buy | Unit price | Tariff | Total | Notes
HeliSR Rev 4.0 board
 | U1, U2 | 2 | Shift register, 74HC165, SOIC-16 | onsemi | MC74HC165ADR2G | Mouser | 863-MC74HC165ADR2G (https://www.mouser.com/ProductDetail/863-MC74HC165ADR2G) | 2 | $0.40 | 0% |  | Front, under the Pro Micro: solder before the sockets
 | RN1, RN2 | 2 | Resistor network, 8 x 10 kOhm bussed, SIP-9 | Bourns | 4609X-101-103LF | Mouser | 652-4609X-1LF-10K (https://www.mouser.com/ProductDetail/652-4609X-1LF-10K) | 2 | $0.29 | 21% |  | Pin 1 (dot) is the common pin: square pad
 | C1, C2, C4 | 3 | Capacitor, 100 nF, 50 V, X7R, 1206 | Samsung | CL31B104KBCNNNC | Mouser | 187-CL31B104KBCNNNC (https://www.mouser.com/ProductDetail/187-CL31B104KBCNNNC) | 3 | $0.14 | 12% |  | C1, C2 front; C4 back
 | C3 | 1 | Capacitor, 22 uF, 10 V, X5R, 1206 | Samsung | CL31A226KPHNNNE | Mouser | 187-CL31A226KPHNNNE (https://www.mouser.com/ProductDetail/187-CL31A226KPHNNNE) | 1 | $0.47 | 12% |  | Front, between U1 and U2
 | U3 | 1 | I2C switch, 4 channels, SOIC-16 (narrow) | Texas Instruments | PCA9546ADR | Mouser | 595-PCA9546ADR (https://www.mouser.com/ProductDetail/595-PCA9546ADR) | 1 | $1.84 | 0% |  | Back
 | R1-R8 | 8 | Resistor, 2.2 kOhm, 1 %, 1/4 W, 1206 | YAGEO | RC1206FR-072K2L | Mouser | 603-RC1206FR-072K2L (https://www.mouser.com/ProductDetail/603-RC1206FR-072K2L) | 10 | $0.025 | 8% |  | Back: I2C pull-ups, a pair per port
 | R9-R11 | 3 | Resistor, 10 kOhm, 1 %, 1/4 W, 1206 | YAGEO | RC1206FR-0710KL | Mouser | 603-RC1206FR-0710KL (https://www.mouser.com/ProductDetail/603-RC1206FR-0710KL) | 10 | $0.025 | 8% |  | Back
 | SW1 | 1 | Tactile switch, SMD, 3.9 x 2.9 mm (reset) | E-Switch | TL1015AF160QG | Mouser | 612-TL1015AF (https://www.mouser.com/ProductDetail/612-TL1015AF) | 1 | $0.47 | 30% |  | Leave its four ground tabs unsoldered
 | J1, J2 | 2 | JST SH header, 10 pins, 1.0 mm, SMD, top entry | JST | BM10B-SRSS-TB(LF)(SN) | Mouser | 306-BM10BSRSSTBLFSN (https://www.mouser.com/ProductDetail/306-BM10BSRSSTBLFSN) | 2 | $0.93 | 30% |  | Switch inputs IN1-IN8, IN9-IN16
 | J11-J14 | 4 | JST SH header, 4 pins, 1.0 mm, SMD, top entry | JST | BM04B-SRSS-G-TB(LF)(SN) | Mouser | 306-4BSRSSGTBLP (https://www.mouser.com/ProductDetail/306-4BSRSSGTBLP) | 4 | $0.63 | 30% |  | Sensor ports AX1-AX4: 1 SDA, 2 GND, 3 VCC, 4 SCL
 | J7, J8 | 2 | Low-profile pin header set, 2.54 mm, 1 x 40: 5 male (platinum-plated pins) + 5 female (tin), pack of 5 pairs | DIYhz |  | Amazon | B07BS126FK (https://www.amazon.com/dp/B07BS126FK) | 1 | $9.99 |  |  | Cut two 12-pin sockets for J7/J8 and two 12-pin rows for the Pro Micro, in place of the pins it comes with: standard headers stand too tall for the USB cable. Solder the sockets last
 | PCB | 1 | HeliSR Rev 4.0 bare PCB, 2 layers, 1.6 mm, 39.3 x 33.6 mm (OSH Park makes 3) |  |  | OSH Park (https://oshpark.com/) |  | 1 | $10.20 |  |  | Upload PCB/HeliSR/HeliSR_Rev4.0_Gerbers.zip
 | J7, J8 | 1 | Pro Micro 5 V / 16 MHz (ATmega32U4), USB-C, with header pins | OSOYOO |  | Amazon | B0B81FGBLY (https://www.amazon.com/dp/B0B81FGBLY) | 1 | $11.99 |  |  | Plugs into J7/J8; runs the HeliSR firmware. Fit the low-profile pins, not its own
 | Solder paste | 1 | Solder paste, low temperature (Sn42/Bi57.6/Ag0.4), 15 g syringe | Chip Quik | SMDLTLFP | Mouser | 910-SMDLTLFP (https://www.mouser.com/ProductDetail/910-SMDLTLFP) | 1 | $15.95 | 0% |  | Optional: the board can be hand soldered
SearchHat Rev 1.0 board (SEARCH CONT hat)
 | SW1 | 1 | 8-direction stick switch with centre push | ALPS Alpine | RKJXM1015004 | Mouser | 688-RKJXM1015004 (https://www.mouser.com/ProductDetail/688-RKJXM1015004) | 1 | $10.07 | 0% |  | Directions to IN9-IN12, centre push to IN15
 | J1 | 1 | JST SH header, 6 pins, 1.0 mm, SMD, side entry | JST | SM06B-SRSS-TB(LF)(SN) | Mouser | 306-M06BSRSSTBLFSNPP (https://www.mouser.com/ProductDetail/306-M06BSRSSTBLFSNPP) | 1 | $0.68 | 30% |  | Back of the board
 | PCB | 1 | SearchHat Rev 1.0 bare PCB, 2 layers, 1.6 mm, 22 x 29 mm (OSH Park makes 3) |  |  | OSH Park (https://oshpark.com/) |  | 1 | $4.95 |  |  | Upload PCB/SearchHat/SearchHat_Rev1.0_Gerbers.zip
Wiring
 | J1, J2 | 1 | JST SR jumper, 10 positions, 12 in (305 mm) | JST | A10SR10SR30K305A | Mouser | 306-A10SR10SR30K305A (https://www.mouser.com/ProductDetail/306-A10SR10SR30K305A) | 1 | $3.45 | 0% |  | Cut in half: one pigtail for J1, one for J2
 | AX1, AX4 | 2 | JST SR jumper, 4 positions, 10 in (254 mm) | JST | A04SR04SR30K254B | Mouser | 306-A04SR04SR30K254B (https://www.mouser.com/ProductDetail/306-A04SR04SR30K254B) | 2 | $1.63 | 0% |  | Cut in half for the board-end pigtails
 | AX1 lead | 1 | Flat ribbon cable, 4 conductors, 24 AWG, 1 m | KYOCERA AVX | 902220736004000 | Mouser | 581-902220736004000 (https://www.mouser.com/ProductDetail/581-902220736004000) | 1 | $3.35 | 26% |  | Base sensor to the AX1 pigtail. Keep the order SDA, GND, VCC, SCL
 | SearchHat J1 | 1 | JST SR jumper, 6 positions, 8 in (203 mm) | JST | A06SR06SR30K203A | Mouser | 306-A06SR06SR30K203A (https://www.mouser.com/ProductDetail/306-A06SR06SR30K203A) | 1 | $1.85 | 0% |  | Cut in half; one end to J1, the wires to J2's loom
 | USB | 1 | USB 2.0 cable, USB-A to USB-C, 2 m | Stewart Connector | SC-2CAK020M | Mouser | 530-SC-2CAK020M (https://www.mouser.com/ProductDetail/530-SC-2CAK020M) | 1 | $7.33 | 8% |  | Cut about 15 cm from the C plug; splice it back on inside the head
Angle sensors
 | AX1, AX4 | 2 | AS5600 magnetic encoder module with magnet, pack of 4 | WWZMDiB |  | Amazon | B0CM3C8KFT (https://www.amazon.com/dp/B0CM3C8KFT) | 1 | $9.99 |  |  | AX1 in the base, AX4 in the head. Prepare them as PCB/HeliSR/README.md says
Huey head: switches
 | IN3-IN6 | 2 | Toggle switch, SPDT, ON-OFF-ON, M12 bushing | APEM | 639H/2 | Mouser | 642-639H2 (https://www.mouser.com/ProductDetail/642-639H2) | 2 | $7.86 | 0% |  | LDG LT EXT / RETR, SL ON / STOW
 | IN1, IN2 | 1 | Toggle switch, SPDT, (ON)-OFF-(ON), M12 bushing | APEM | 637H/2 | Mouser | 642-637H2 (https://www.mouser.com/ProductDetail/642-637H2) | 1 | $8.02 | 0% |  | GOV RPM INCR / DECR. Back-ordered at Mouser on 2026-11-13; Digi-Key stocks it (679-1219-ND)
 | IN7 | 1 | Toggle switch, ON-ON, M12 bushing | APEM | 636H/2 | Mouser | 642-636H2 (https://www.mouser.com/ProductDetail/642-636H2) | 1 | $7.55 | 0% |  | LDG LT ON
 | IN13 | 1 | Push button, 12 mm, SPST-NO momentary, black | Same Sky | PB4-M-BK-D-67 | Mouser | 179-PB4-M-BK-D-67 (https://www.mouser.com/ProductDetail/179-PB4-M-BK-D-67) | 1 | $2.52 | 20% |  | STOP REL
 | IN14 | 1 | Tactile switch, 6 x 6 mm, 5 mm high, through hole | TE Connectivity | 1825910-6 | Mouser | 650-1825910-6 (https://www.mouser.com/ProductDetail/650-1825910-6) | 1 | $0.12 | 30% |  | Starter trigger
Huey head: hardware
 | HeliSR board | 4 | Spacer, M3, 4 mm, PVC | Bivar | SRS-4-4MM | Mouser | 749-SRS-4-4MM (https://www.mouser.com/ProductDetail/749-SRS-4-4MM) | 4 | $0.10 | 15% |  | Between the rear wall and the board
 | Throttle grip | 4 | O-ring, 24 mm ID x 2 mm, nitrile, pack of 50 | FOCMKEAS |  | Amazon | B0BWWBTL4N (https://www.amazon.com/dp/B0BWWBTL4N) | 1 | $6.89 |  |  | Grease lightly with silicone grease
 | Trigger | 1 | Pen spring, 4 mm OD x 50 mm, pack of 10 | uxcell |  | Amazon | B0GCZGNBYH (https://www.amazon.com/dp/B0GCZGNBYH) | 1 | $6.99 |  |  | Cut to about 13 mm
 | Head box | 1 | Split shot lead weights, assorted (optional ballast) | SANWEAL |  | Amazon | B0H6J3X6GL (https://www.amazon.com/dp/B0H6J3X6GL) | 1 | $5.99 |  |  | Only if a stronger strut lifts the lever
MkIII base Rev 4
 | Pivot | 2 | Ball bearing 6808-2RS, 40 x 52 x 7 mm, double sealed, pack of 2 | HARFINGTON | 6808-2RS | Amazon | B0CGM4BY2K (https://www.amazon.com/dp/B0CGM4BY2K) | 1 | $8.99 |  |  | Any 6808-2RS fits
 | Tube | 1 | Carbon fibre tube, wrapped, 25 mm OD x 23 mm ID x 500 mm, pack of 2 | MECCANIXITY |  | Amazon | B0CFFT1B31 (https://www.amazon.com/dp/B0CFFT1B31) | 1 | $27.49 |  |  | Used whole, uncut
 | Strut | 1 | Gas strut, 6 in eye to eye, 45 N, pack of 2 | X AUTOHAUX |  | Amazon | B0CY267GFY (https://www.amazon.com/dp/B0CY267GFY) | 1 | $13.69 |  |  | Cylinder end on the anchor
 | Socket mouth | 1 | Hose clamp, worm drive, 25-40 mm |  |  | Local
 | Brake (optional) | 1 | Compression spring, up to 10 mm OD, 0.8-1.0 mm wire, 10-15 mm long |  |  | Local |  |  |  |  |  | Softens the brake knob
 | Brake strap | 1 | Felt, self-adhesive, 1.5 mm thick, at least 51 x 16 mm |  |  | Local |  |  |  |  |  | Cut 51 x 16 mm
Screws and nuts (MonsterBolts, packs of 10)
 | SearchHat board (4), trigger pull stop seat (1), AS5600 in the lever (4) | 9 | M2 x 8 flat head machine screw, Phillips (DIN 965), black oxide |  |  | MonsterBolts | Mach + Flat - B/O M02 x 008.0010 (https://monsterbolts.com/products/mach-phil-flat-blk-m2?variant=21222469795923) | 1 | $1.01 |  |  | Phillips: no small pack of M2 countersunk with a hex or star drive
 | HeliSR board (4), base side covers (8) | 12 | M3 x 12 flat head socket cap screw, 12.9, black oxide |  |  | MonsterBolts | FHCS - B12.9 M03 x 012.0010 (https://monsterbolts.com/products/socket-flat-b12-9-m3?variant=36254218188) | 2 | $1.46
 | Head panels (8) | 8 | M3 x 16 flat head socket cap screw, 12.9, black oxide |  |  | MonsterBolts | FHCS - B12.9 M03 x 016.0010 (https://monsterbolts.com/products/socket-flat-b12-9-m3?variant=36254218444) | 1 | $1.53
 | Trigger pivot (1) | 1 | M3 x 25 flat head socket cap screw, 12.9, black oxide |  |  | MonsterBolts | FHCS - B12.9 M03 x 025(PT).0010 (https://monsterbolts.com/products/socket-flat-b12-9-m3?variant=36254218700) | 1 | $2.36
 | Friction collar (1) | 1 | M4 x 12 flat head socket cap screw, 12.9, black oxide |  |  | MonsterBolts | FHCS - B12.9 M04 x 012.0010 (https://monsterbolts.com/products/socket-flat-b12-9-m4?variant=36289629452) | 1 | $1.33
 | Strut eyes (2), strut collar clamp (1) | 3 | M4 x 16 flat head socket cap screw, 12.9, black oxide |  |  | MonsterBolts | FHCS - B12.9 M04 x 016.0010 (https://monsterbolts.com/products/socket-flat-b12-9-m4?variant=36289629580) | 1 | $1.29
 | Lever, tube lock, shell, brake hinge | 5 | M4 x 35 socket head cap screw, 12.9, black oxide |  |  | MonsterBolts | SHCS - B12.9 M04 x 035(PT).0010 (https://monsterbolts.com/products/socket-cap-b12-9-m4?variant=35989100940) | 1 | $1.99
 | Lever, tube lock, shell, brake hinge | 5 | M4 x 50 socket head cap screw, 12.9, black oxide |  |  | MonsterBolts | SHCS - B12.9 M04 x 050(PT).0010 (https://monsterbolts.com/products/socket-cap-b12-9-m4?variant=35989101196) | 1 | $2.79
 | Brake knob (1) | 1 | M5 x 35 hex cap bolt, full thread, A2 stainless |  |  | MonsterBolts | Hex Cap - SA2 M05 x 035.0010 (https://monsterbolts.com/products/hex-bolt-a2-m5?variant=36455646284) | 1 | $2.82 |  |  | Stainless: not sold in black
 | Tube boss (1) | 1 | M5 x 8 socket set screw, cup point, 14.9, black oxide |  |  | MonsterBolts | Set - B14.9 M05 x 008.0010 (https://monsterbolts.com/products/socket-set-cup-b14-9-m5?variant=36353852300) | 1 | $0.96 |  |  | Pins the tube in the head
 | Trigger pull stop (1) | 1 | M3 x 4 socket set screw, cup point, 14.9, black oxide |  |  | MonsterBolts | Set - B14.9 M03 x 004.0010 (https://monsterbolts.com/products/socket-set-cup-b14-9-m3?variant=36345375372) | 1 | $1.02
 | HeliSR board (4) | 4 | M3 hex nut, DIN 934, class 10 steel |  |  | MonsterBolts | Nuts - D934 B10 M03.0010 (https://monsterbolts.com/products/nuts-din934-b10-9?variant=40341891317843) | 1 | $0.80
 | Friction collar (1), strut eyes (2), strut collar clamp (1), M4 socket head screws (10) | 14 | M4 hex nut, DIN 934, class 10 steel |  |  | MonsterBolts | Nuts - D934 B10 M04.0010 (https://monsterbolts.com/products/nuts-din934-b10-9?variant=27845486837843) | 2 | $0.64
 | Brake strap (1) | 1 | M5 hex nut, DIN 934, class 10 steel |  |  | MonsterBolts | Nuts - D934 B10 M05.0010 (https://monsterbolts.com/products/nuts-din934-b10-9?variant=27845486968915) | 1 | $0.69
Supplies and tools
 | Bearings | 1 | White lithium grease |  |  | Local
 | O-rings | 1 | Silicone grease |  |  | Local
 | Magnets | 1 | Super glue (cyanoacrylate) gel |  |  | Local
 | AS5600 modules | 1 | Hot glue |  |  | Local
 | Screws | 1 | Threadlocker, blue (medium strength) |  |  | Local
The Local lines are unpriced: buy them at a hardware store. |  |  |  |  |  |  |  |  |  | Total

Sheet: Printed parts
Heli Collective - printed parts
Print the fit-test coupons first. Paths are from the repository root. Tick Done to strike a line through.
Done | Assembly | File | Qty | How to print
 | Head | Head/stl/HueyHeadR5-GripBearingCoupons.stl | 1 | Optional fit test: flat, labels up
 | Head | Head/stl/HueyHeadR5-ORingCoupon.stl | 1 | Fit test for the grip's O-rings: upright
 | Head | Head/stl/HueyHeadR5-SensorSeatCoupon.stl | 1 | Optional fit test for the AS5600 module
 | Head | Head/stl/HueyHeadR5-Body.stl | 1 | On its rear wall, tree supports under the neck, knob and tube bore
 | Head | Head/stl/HueyHeadR5-LowerPanel-Black.stl + -WhiteText.stl | 1 | Front face down, two colours
 | Head | Head/stl/HueyHeadR5-UpperPanel-Black.stl + -WhiteText.stl | 1 | Front face down, two colours
 | Head | Head/stl/HueyHeadR5-Trigger.stl | 1 | On either flat side
 | Head | Head/stl/HueyHeadR5-Hat-Cap.stl | 1 | Base down
 | Head | Head/stl/HueyHeadR5-ThrottleGrip.stl | 1 | Upright, bottom end down, no supports
 | Head | Head/stl/HueyHeadR5-FrictionCollar.stl | 1 | Bottom face down
 | Head | Head/stl/HueyHeadR5-Pinion.stl | 1 | Shoulder up
 | Head | Head/stl/HueyHeadR5-MagnetShaft.stl | 1 | Cap face down
 | Base | Base/stl/coupons/ (all four) | 1 | Fit tests: print these first
 | Base | Base/stl/frame.stl | 1 | Plate down
 | Base | Base/stl/shell.stl | 1 | Top down; support only the knob's seat
 | Base | Base/stl/lever_sensor.stl | 1 | On its joint face; support only the up-stop lug
 | Base | Base/stl/lever_cable.stl | 1 | On its joint face; support only the up-stop lug
 | Base | Base/stl/lever_dowel.stl | 4 | Standing on end
 | Base | Base/stl/cover_cable.stl, cover_sensor.stl | 1 | One each, outer face down
 | Base | Base/stl/strap.stl | 1 | On its side, nut slot up, no supports
 | Base | Base/stl/strut_collar.stl | 1 | Standing on one end
 | Base | Base/stl/drill_guide.stl | 1 | A tool for drilling the tube: standing on its closed end
 | Base | Base/stl/friction_knob.stl | 1 | Underside down
