genbean/UH1-Collective/Base/Rev4/step/MkIII_Rev4_assembly.step

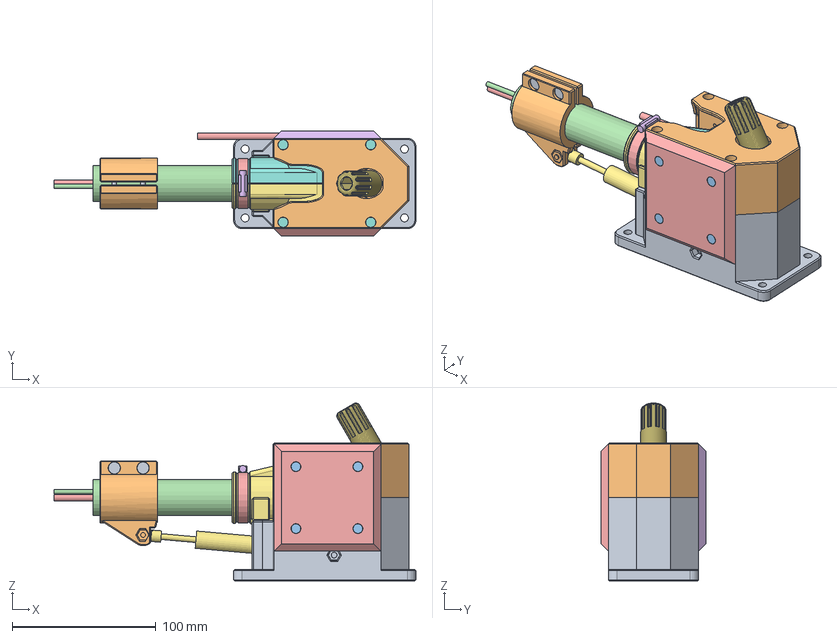
[picture p154: CAD file, 2026-11-10]
Base/Rev4/step/MkIII_Rev4_assembly.step
252.0 x 73.0 x 123.8 mm
frame
strap
felt
cover_sensor
cover_cable
friction_knob
hardware
magnet
bearing_outer
bearing_seal
lever_sensor
lever_cable
lever_dowel
strut_collar
bearing_inner
carbon_tube
hose_clamp
gas_strut
strut_pins
lever_screws
sensor_wires
usb_cable
sensor_pcb
sensor_chip
