genbean/UH1-Collective/Base/Rev4/stl/coupons/coupon_dowel_hole.stl

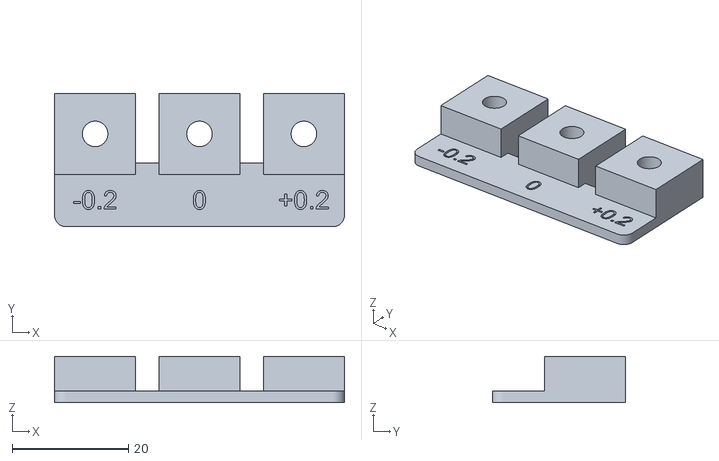
[picture p155: CAD file, 2026-11-09]
Base/Rev4/stl/coupons/coupon_dowel_hole.stl
50.0 x 23.0 x 8.00
