genbean/UH1-Collective/Base/Rev4/stl/ref/hardware.stl

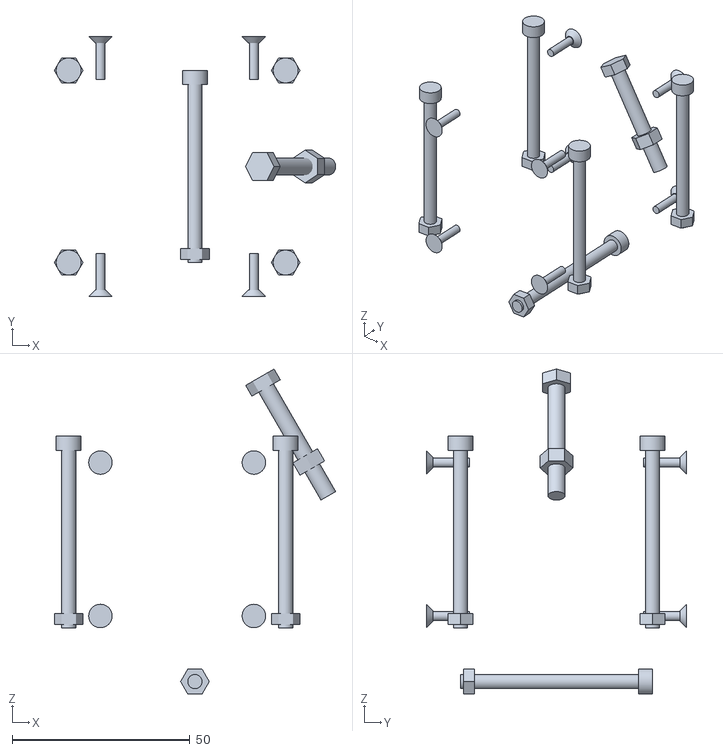
[picture p156: CAD file, 2026-11-10]
Base/Rev4/stl/ref/hardware.stl
79.1 x 73.0 x 91.4
