genbean/UH1-Collective/Base/Rev4/stl/shell.stl

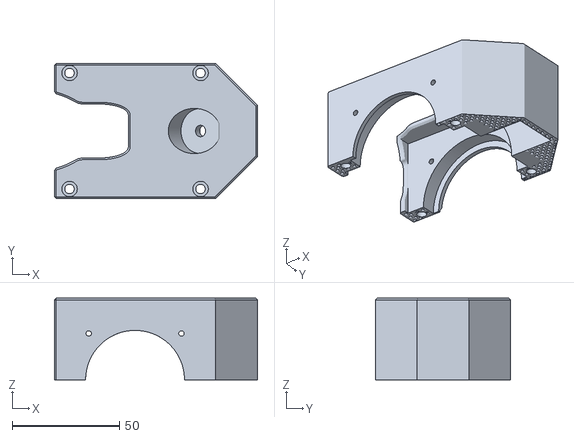
[picture p157: CAD file, 2026-11-10]
Base/Rev4/stl/shell.stl
94.5 x 63.0 x 38.0
