genbean/UH1-Collective/Base/stl/coupons/coupon_bearing_seat_6808.stl

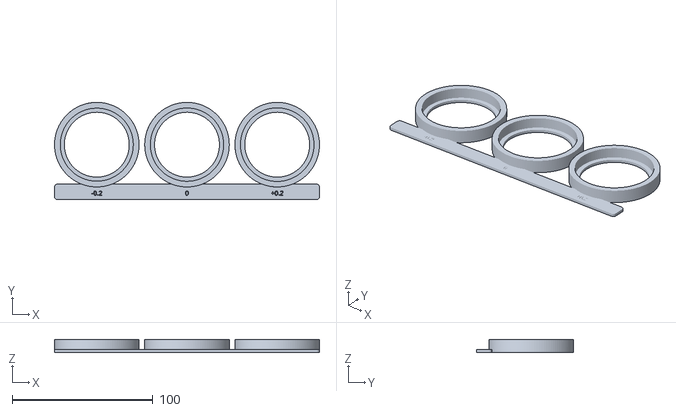
[picture p158: CAD file, 2026-11-10]
Base/stl/coupons/coupon_bearing_seat_6808.stl
188.0 x 69.0 x 9.00
