genbean/UH1-Collective/Base/stl/drill_guide.stl

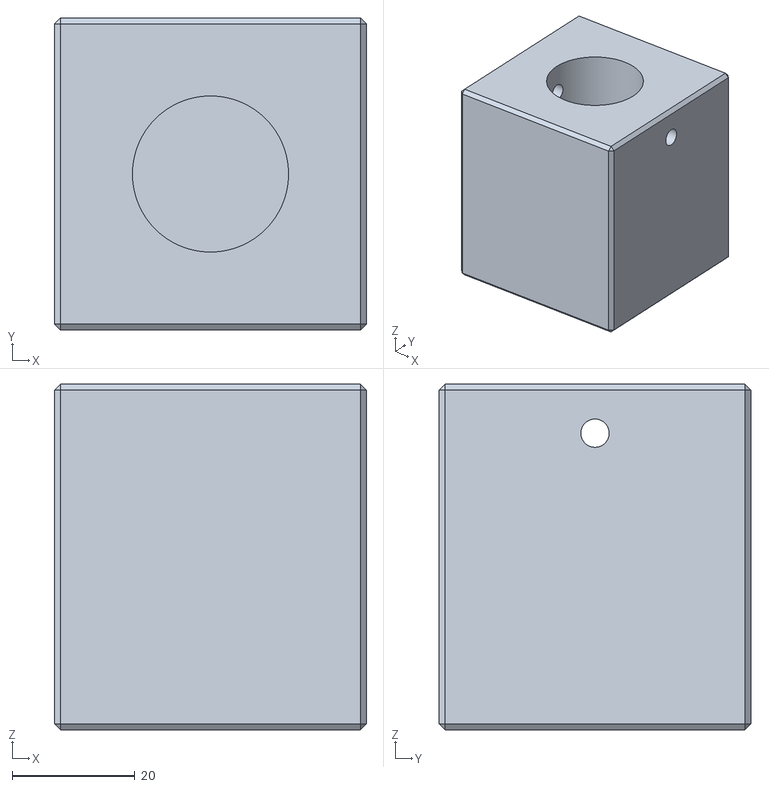
[picture p159: CAD file, 2026-11-13]
Base/stl/drill_guide.stl
50.8 x 50.8 x 56.3
