genbean/UH1-Collective/Base/stl/ref/sensor_wires.stl

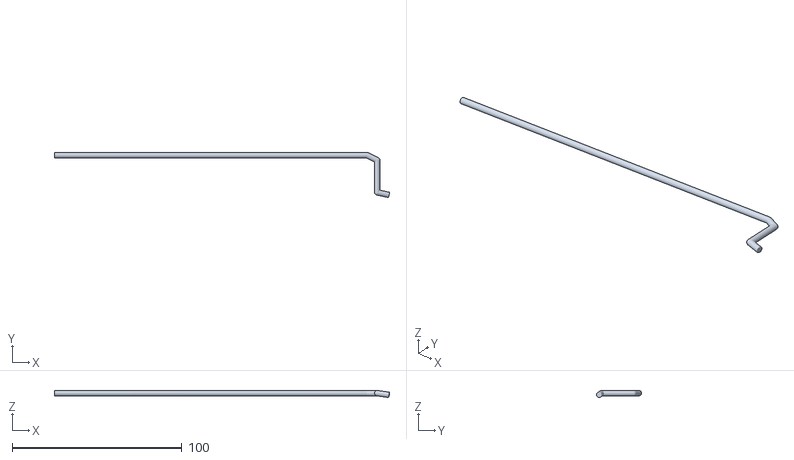
[picture p160: CAD file, 2026-11-12]
Base/stl/ref/sensor_wires.stl
197.2 x 26.6 x 4.18
