genbean/UH1-Collective/Head/Rev5/stl/HueyHeadR5-Hat4-Cap.stl

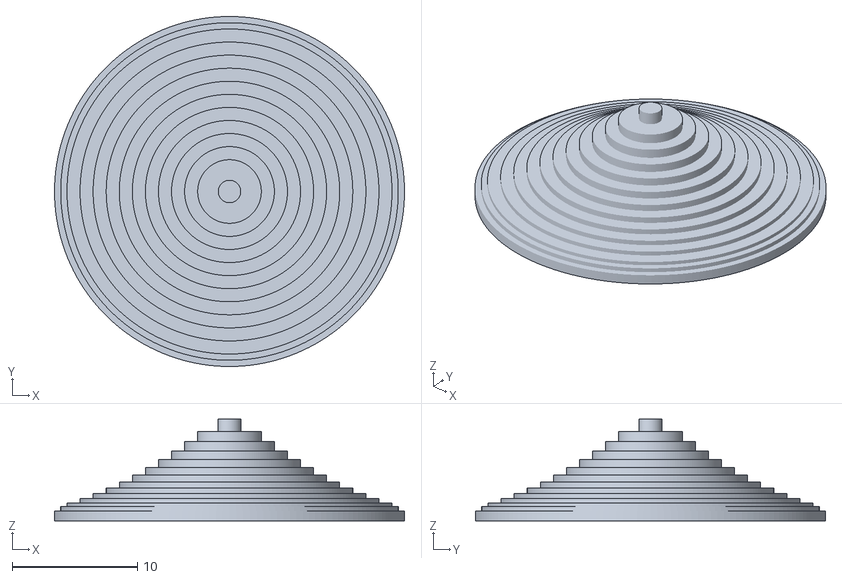
[picture p161: CAD file, 2026-11-05]
Head/Rev5/stl/HueyHeadR5-Hat4-Cap.stl
28.0 x 28.0 x 8.15
