genbean/UH1-Collective/Head/stl/ref/module.stl

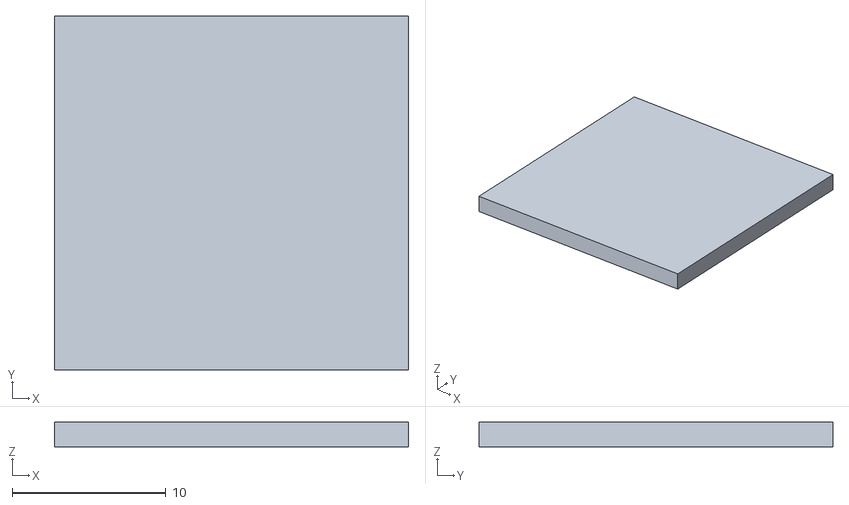
[picture p162: CAD file, 2026-11-10]
Head/stl/ref/module.stl
23.0 x 23.0 x 1.60
