genbean/UH1-Collective/Base/Rev4/stl/coupons/coupon_trunnion_6808.stl

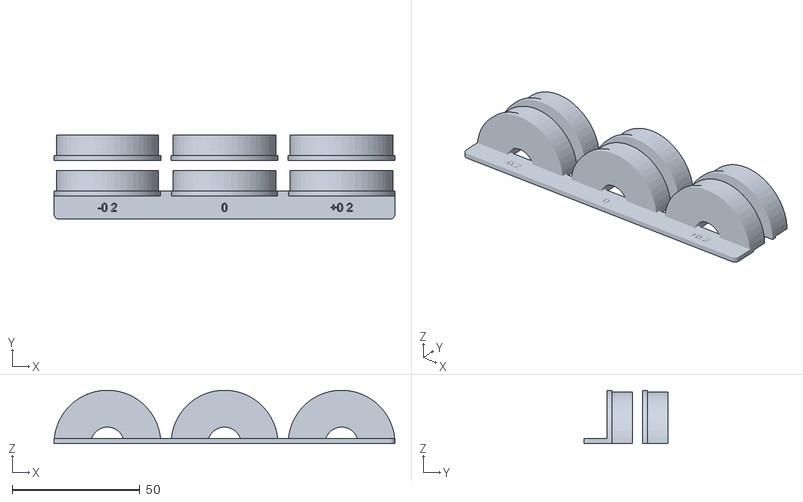
[picture p163: CAD file, 2026-11-09]
Base/Rev4/stl/coupons/coupon_trunnion_6808.stl
133.4 x 33.0 x 20.9
