genbean/UH1-Collective/Base/Rev4/stl/frame.stl

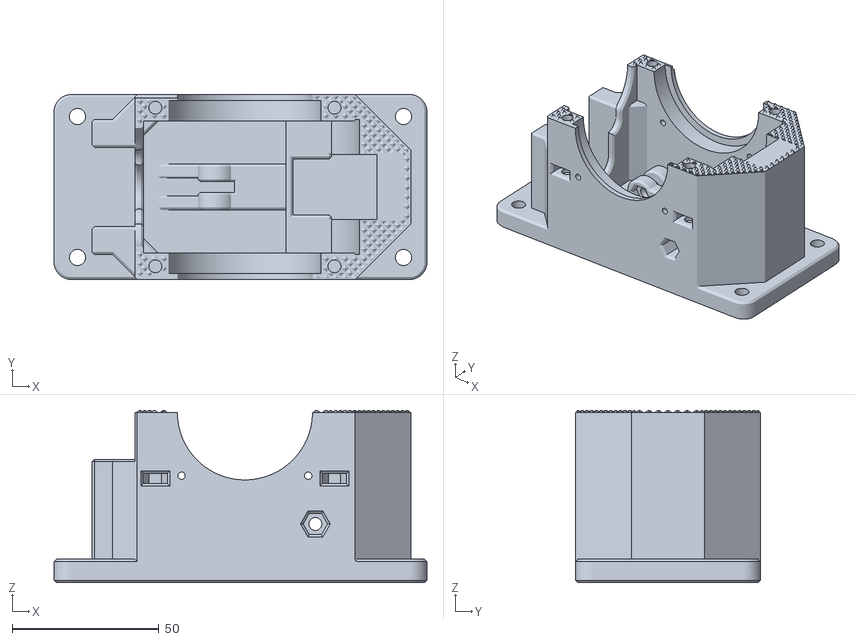
[picture p164: CAD file, 2026-11-09]
Base/Rev4/stl/frame.stl
127.0 x 63.0 x 58.7
