genbean/UH1-Collective/Base/Rev4/stl/ref/sensor_pcb.stl

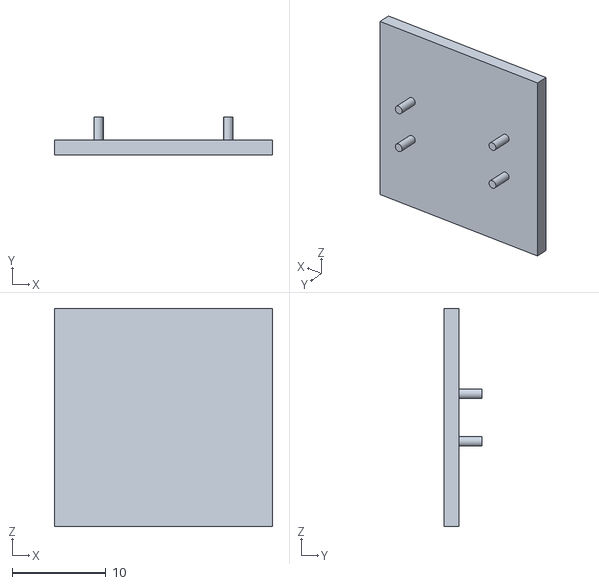
[picture p165: CAD file, 2026-11-09]
Base/Rev4/stl/ref/sensor_pcb.stl
23.2 x 4.10 x 23.2
