genbean/UH1-Collective/Base/stl/coupons/coupon_trunnion.stl

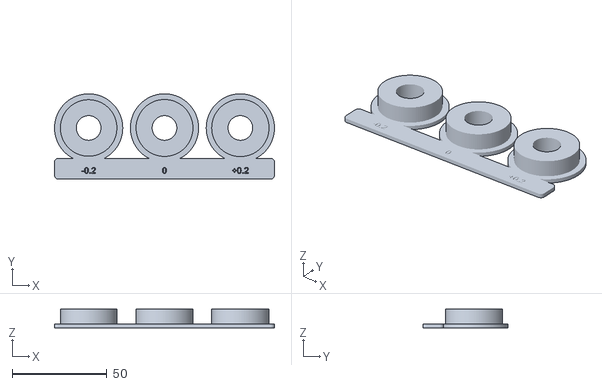
[picture p166: CAD file, 2026-10-24]
Base/stl/coupons/coupon_trunnion.stl
116.0 x 45.0 x 10.0
