genbean/UH1-Collective/Base/stl/strut_collar.stl

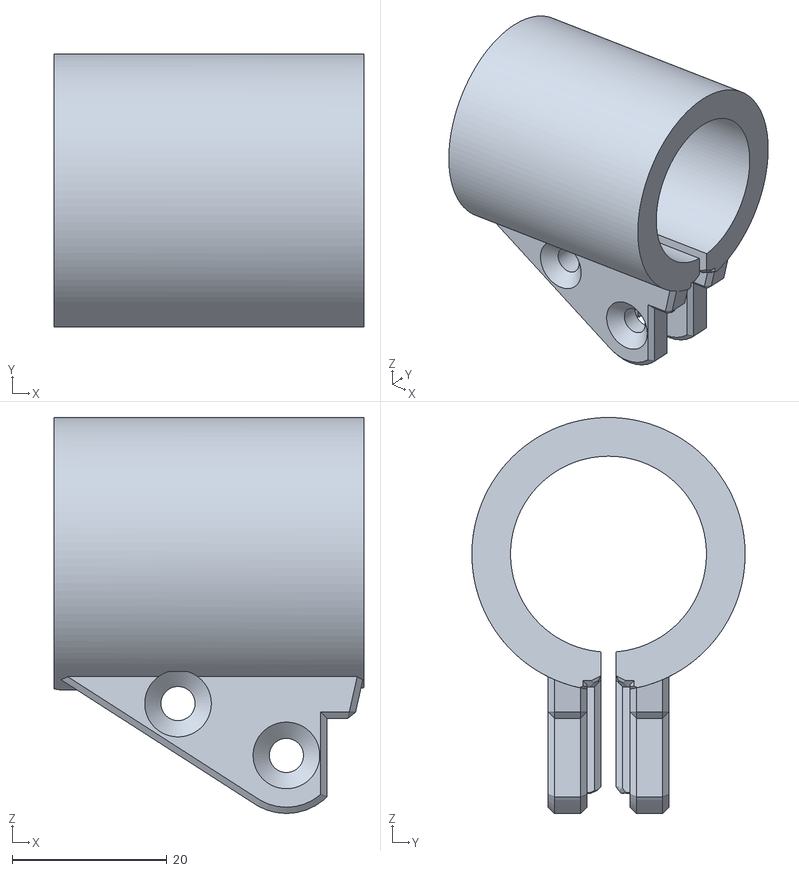
[picture p167: CAD file, 2026-11-12]
Base/stl/strut_collar.stl
40.0 x 35.3 x 51.1
