genbean/UH1-Collective/Head/Rev5/stl/HueyHeadR5-LowerPanel-Hat4-Black.stl

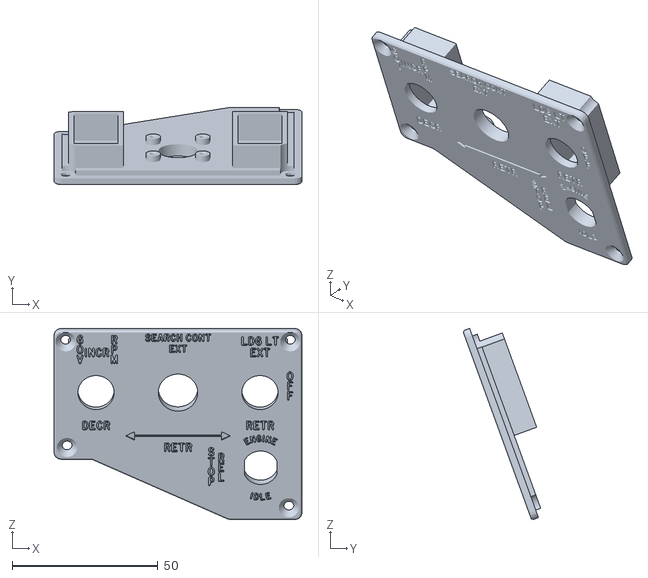
[picture p168: CAD file, 2026-11-05]
Head/Rev5/stl/HueyHeadR5-LowerPanel-Hat4-Black.stl
85.0 x 26.5 x 65.5
