genbean/UH1-Collective/Head/stl/HueyHeadR5-FrictionCollar.stl

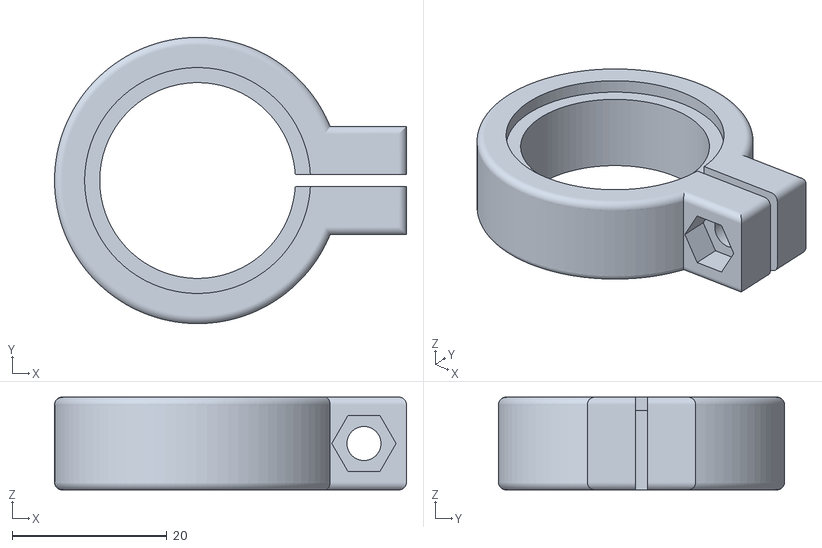
[picture p169: CAD file, 2026-11-10]
Head/stl/HueyHeadR5-FrictionCollar.stl
45.5 x 37.0 x 12.0
