genbean/UH1-Collective/Head/stl/ref/chip.stl

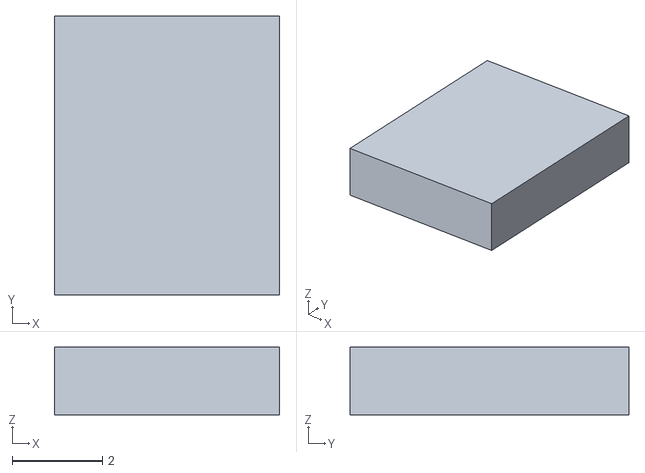
[picture p170: CAD file, 2026-11-10]
Head/stl/ref/chip.stl
5.00 x 6.20 x 1.50
