genbean/UH1-Collective/Base/Rev4/stl/coupons/coupon_shoe_pocket.stl

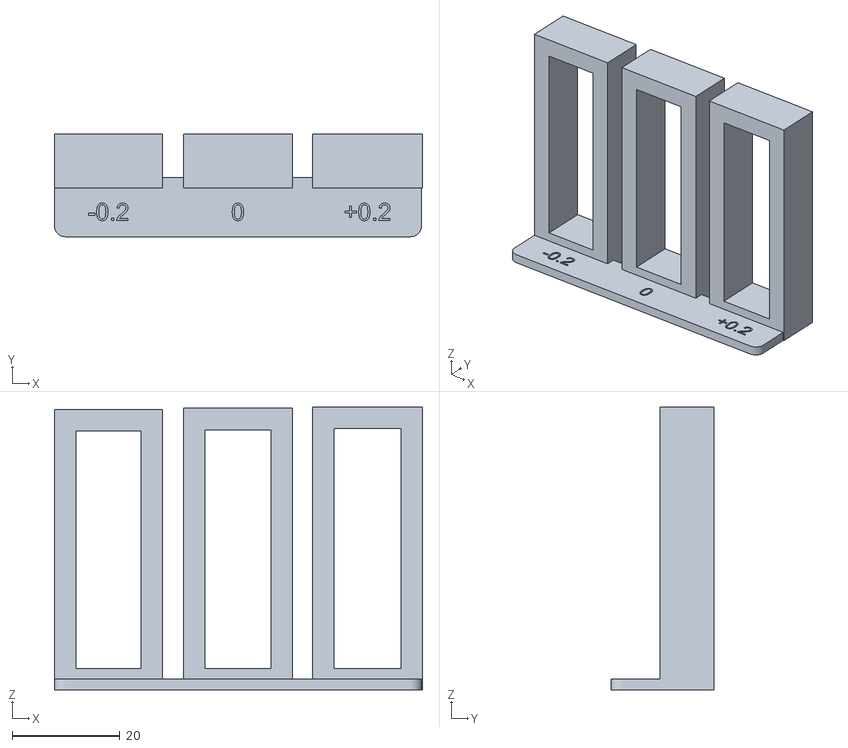
[picture p171: CAD file, 2026-11-08]
Base/Rev4/stl/coupons/coupon_shoe_pocket.stl
68.2 x 19.0 x 52.4
