genbean/UH1-Collective/Base/Rev4/stl/lever_cable.stl

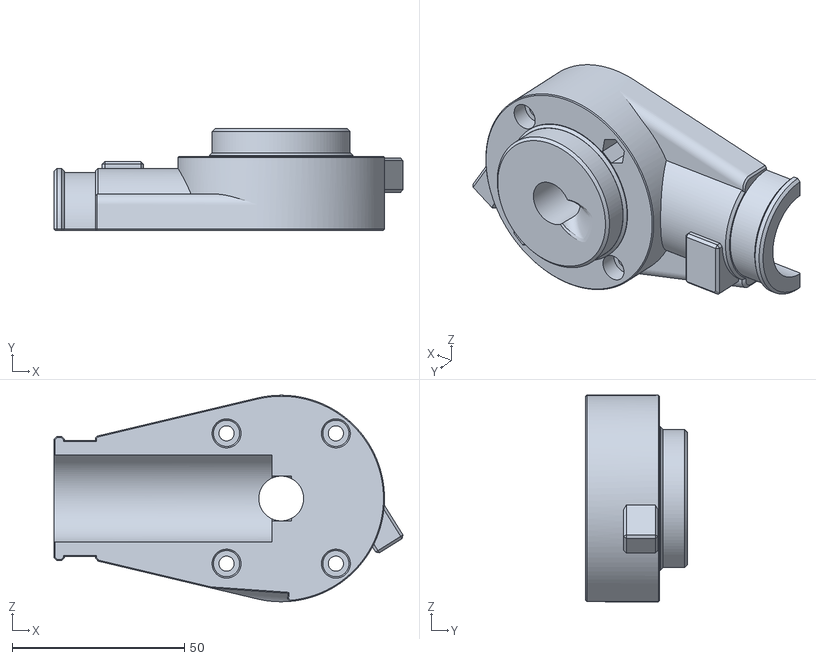
[picture p172: CAD file, 2026-11-09]
Base/Rev4/stl/lever_cable.stl
101.4 x 29.5 x 60.0
