genbean/UH1-Collective/Base/Rev4/stl/ref/magnet.stl

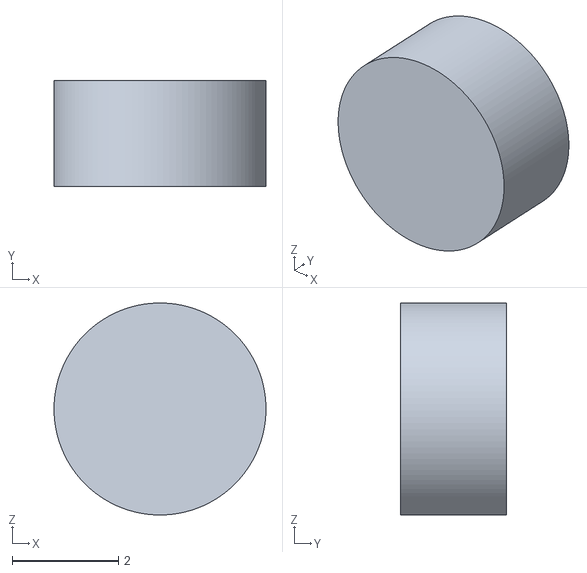
[picture p173: CAD file, 2026-11-09]
Base/Rev4/stl/ref/magnet.stl
4.00 x 2.00 x 4.00
