genbean/UH1-Collective/Base/stl/lever_sensor.stl

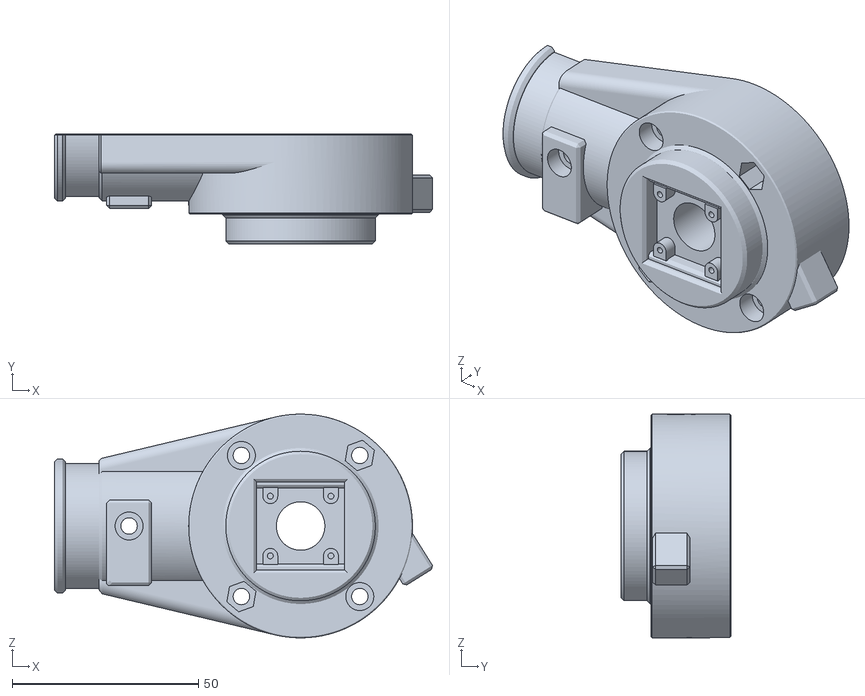
[picture p174: CAD file, 2026-11-12]
Base/stl/lever_sensor.stl
101.4 x 29.5 x 60.0
