genbean/UH1-Collective/Base/stl/ref/strut_pins.stl

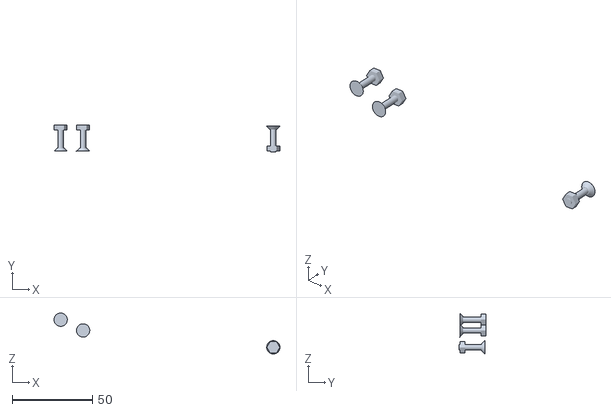
[picture p175: CAD file, 2026-11-12]
Base/stl/ref/strut_pins.stl
140.8 x 16.7 x 25.5
