genbean/UH1-Collective/Head/Rev5/stl/HueyHeadR5-Hat3-Rocker.stl

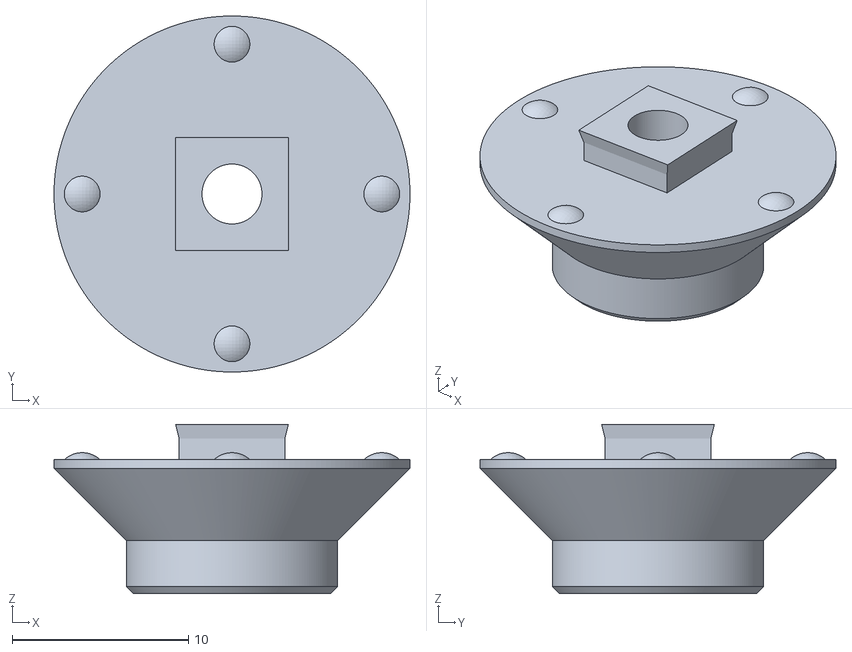
[picture p176: CAD file, 2026-11-05]
Head/Rev5/stl/HueyHeadR5-Hat3-Rocker.stl
20.2 x 20.2 x 9.60
