genbean/UH1-Collective/Base/Rev4/stl/ref/gas_strut.stl

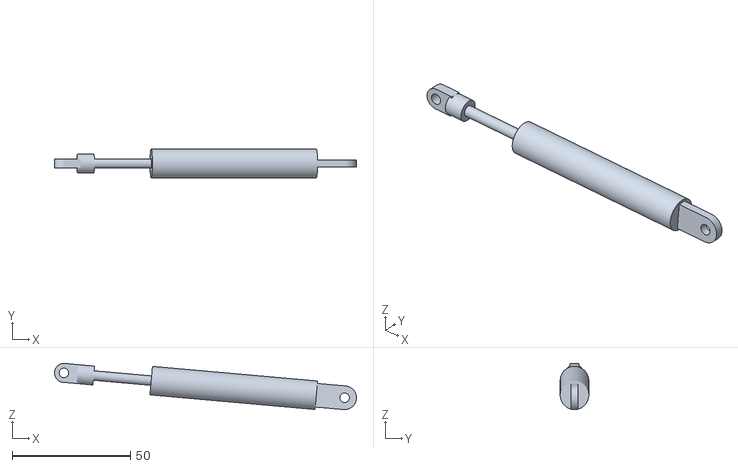
[picture p177: CAD file, 2026-11-09]
Base/Rev4/stl/ref/gas_strut.stl
127.5 x 12.1 x 19.5
