genbean/UH1-Collective/Base/stl/ref/usb_cable.stl

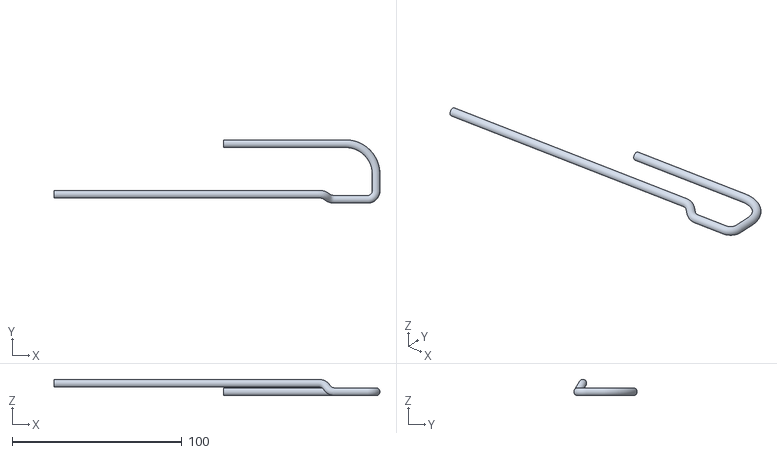
[picture p178: CAD file, 2026-11-12]
Base/stl/ref/usb_cable.stl
192.3 x 37.4 x 9.60
