genbean/UH1-Collective/Head/stl/HueyHeadR5-Trigger.stl

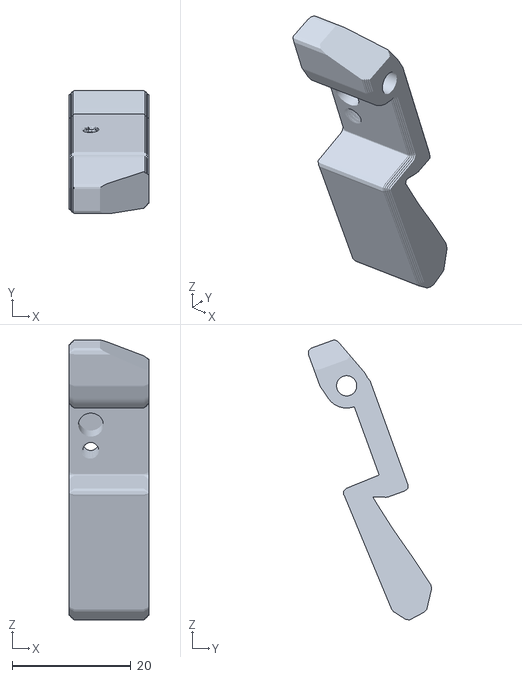
[picture p179: CAD file, 2026-11-10]
Head/stl/HueyHeadR5-Trigger.stl
13.4 x 20.8 x 47.2
