genbean/UH1-Collective/Base/Rev4/stl/cover_cable.stl

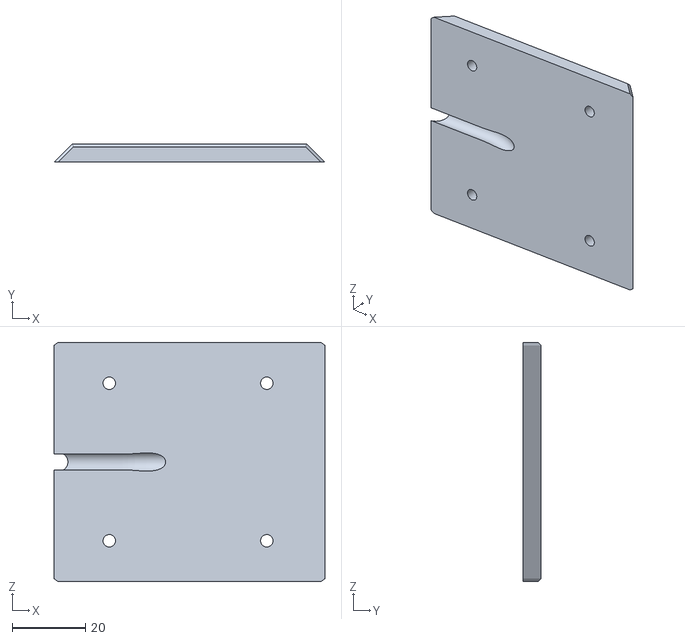
[picture p180: CAD file, 2026-11-09]
Base/Rev4/stl/cover_cable.stl
74.2 x 5.00 x 65.5
