genbean/UH1-Collective/Base/stl/frame.stl

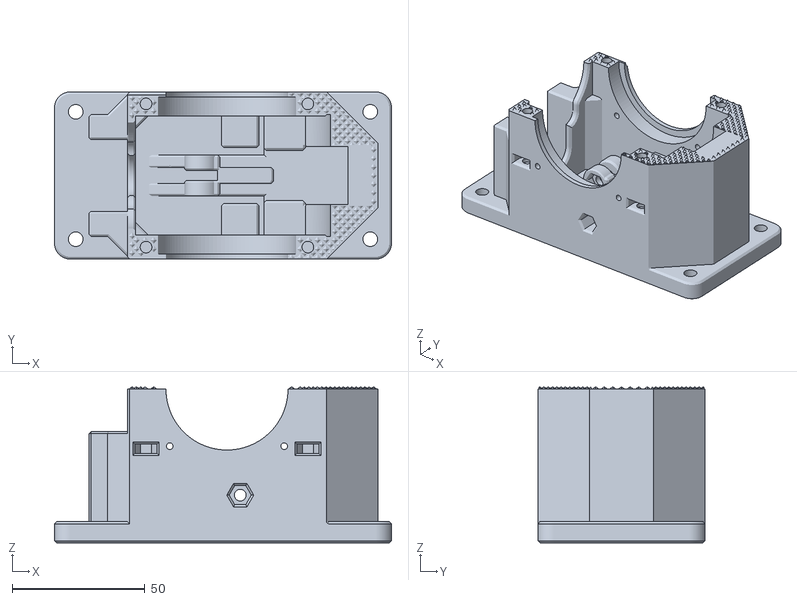
[picture p181: CAD file, 2026-11-12]
Base/stl/frame.stl
127.0 x 63.0 x 58.7
