genbean/UH1-Collective/Head/Rev5/stl/HueyHeadR5-Hat3-Cap.stl

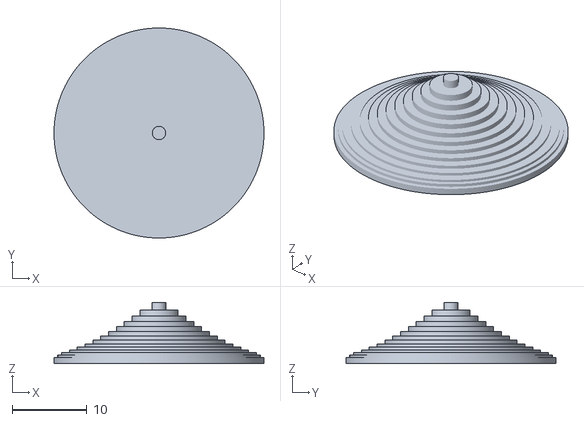
[picture p182: CAD file, 2026-11-04]
Head/Rev5/stl/HueyHeadR5-Hat3-Cap.stl
28.0 x 28.0 x 8.15
