genbean/UH1-Collective/Head/stl/HueyHeadR5-Pinion.stl

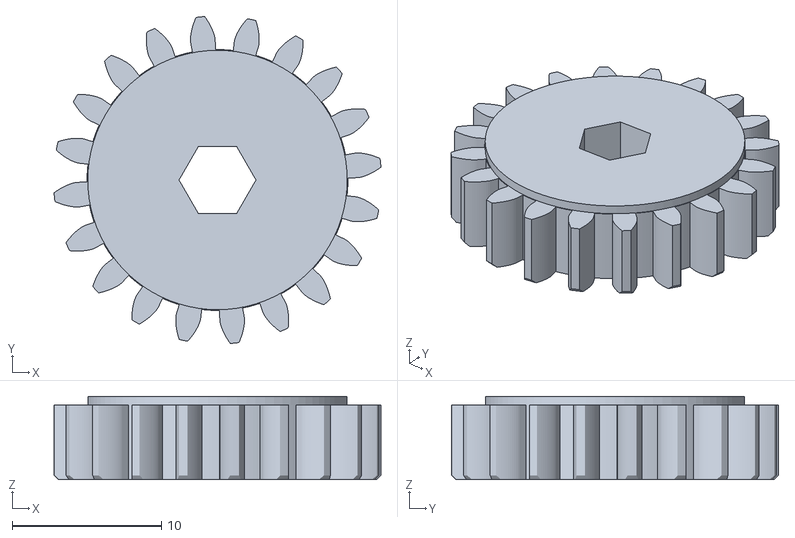
[picture p183: CAD file, 2026-11-10]
Head/stl/HueyHeadR5-Pinion.stl
21.9 x 21.9 x 5.60
