genbean/UH1-Collective/Base/Rev4/stl/ref/strut_pins.stl

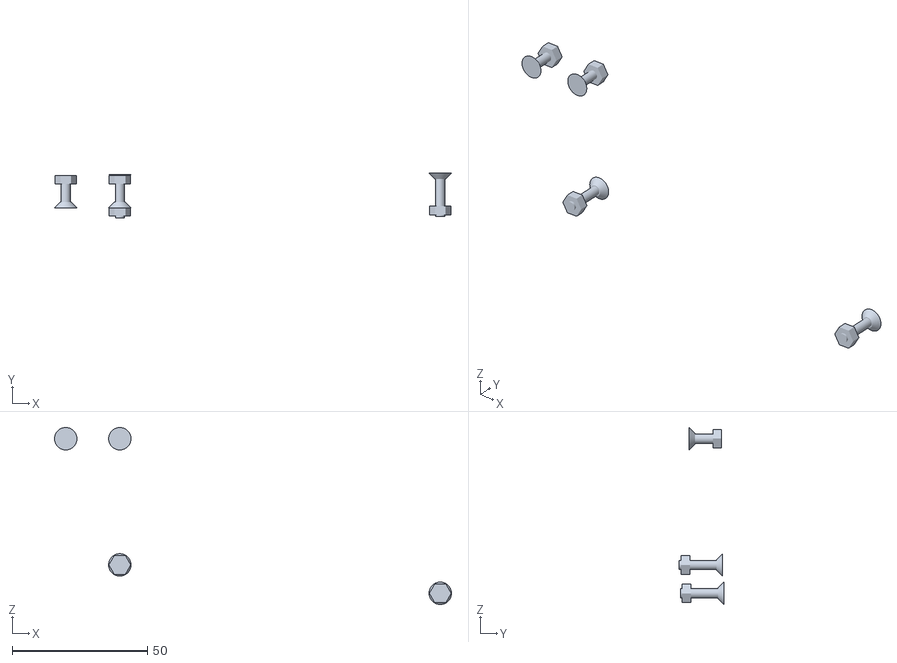
[picture p184: CAD file, 2026-11-08]
Base/Rev4/stl/ref/strut_pins.stl
146.8 x 16.5 x 65.5
