genbean/UH1-Collective/Base/Rev4/stl/strap.stl

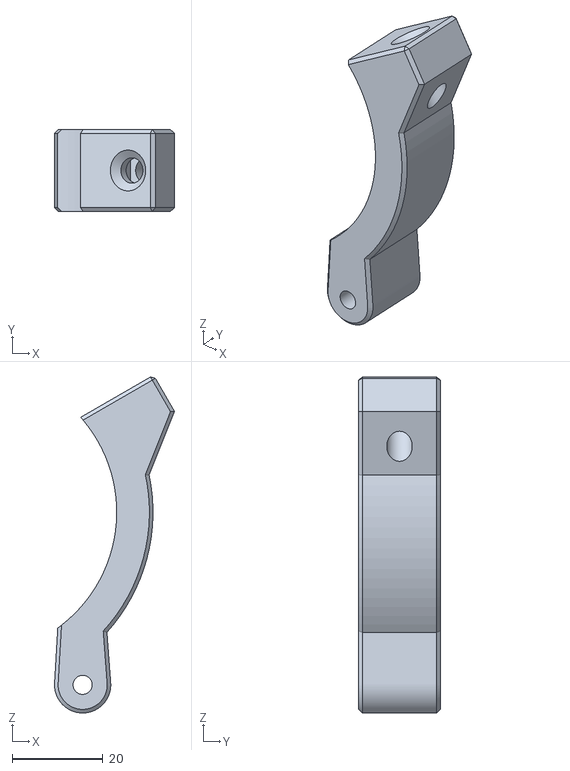
[picture p185: CAD file, 2026-11-09]
Base/Rev4/stl/strap.stl
26.4 x 18.0 x 74.0
