genbean/UH1-Collective/Base/stl/ref/tube_lock.stl

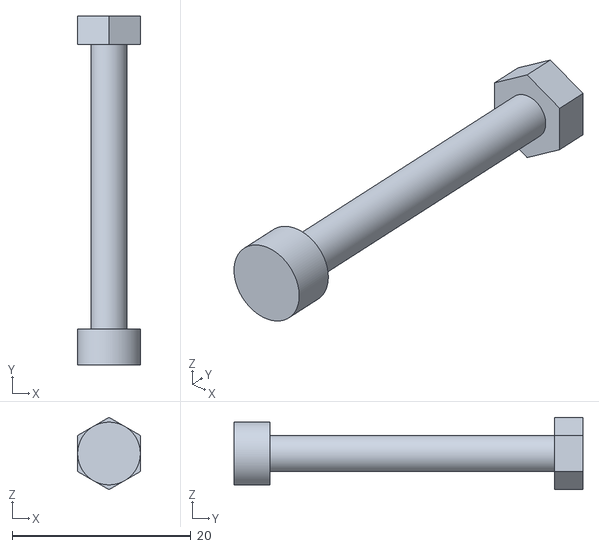
[picture p186: CAD file, 2026-11-12]
Base/stl/ref/tube_lock.stl
7.00 x 39.0 x 8.08
