genbean/UH1-Collective/Head/Rev5/stl/HueyHeadR5-Hat2-Bezel.stl

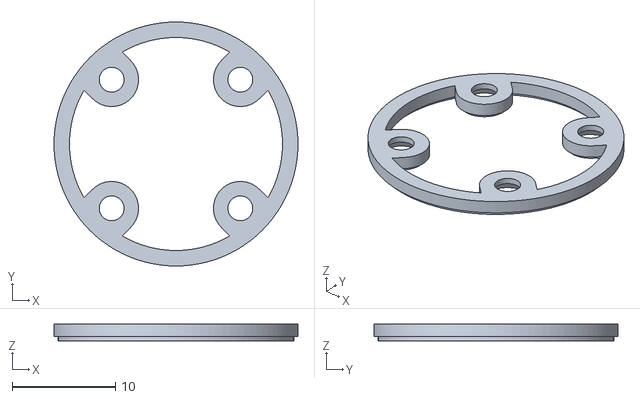
[picture p187: CAD file, 2026-11-03]
Head/Rev5/stl/HueyHeadR5-Hat2-Bezel.stl
23.6 x 23.6 x 1.60
