genbean/UH1-Collective/Head/stl/HueyHead-Trigger.stl

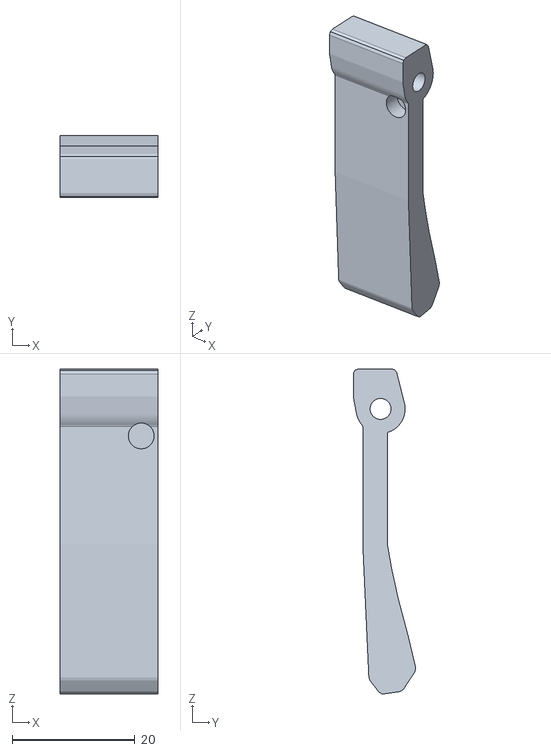
[picture p188: CAD file, 2026-10-24]
Head/stl/HueyHead-Trigger.stl
15.9 x 10.2 x 52.9
