genbean/UH1-Collective/Base/Rev4/stl/lever_dowel.stl

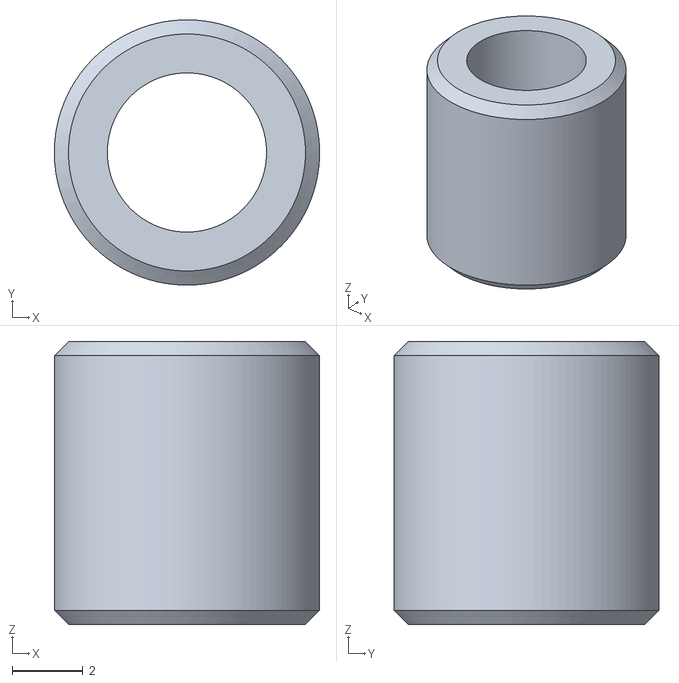
[picture p189: CAD file, 2026-11-09]
Base/Rev4/stl/lever_dowel.stl
7.50 x 7.50 x 8.00
