genbean/UH1-Collective/Base/Rev4/stl/ref/knob_spring.stl

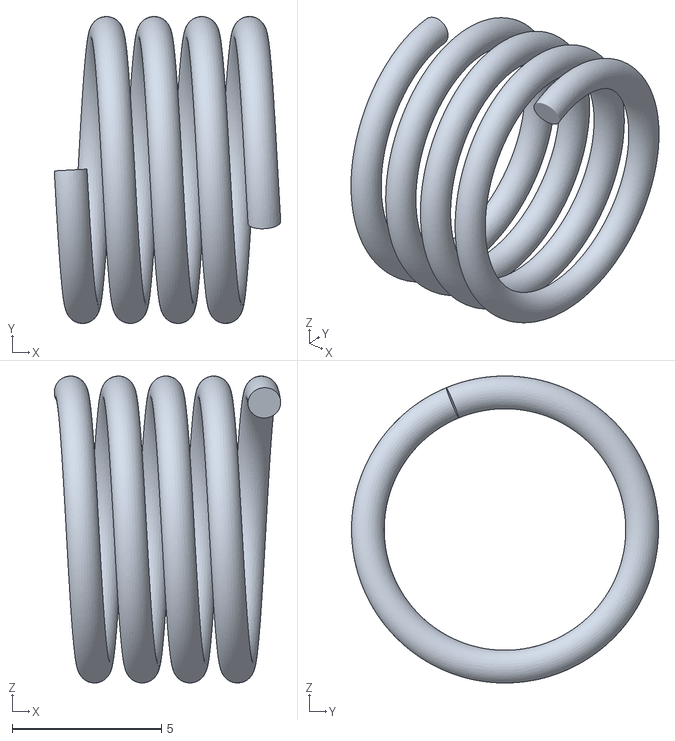
[picture p190: CAD file, 2026-11-08]
Base/Rev4/stl/ref/knob_spring.stl
7.60 x 10.3 x 10.3
