genbean/UH1-Collective/Base/stl/friction_knob.stl

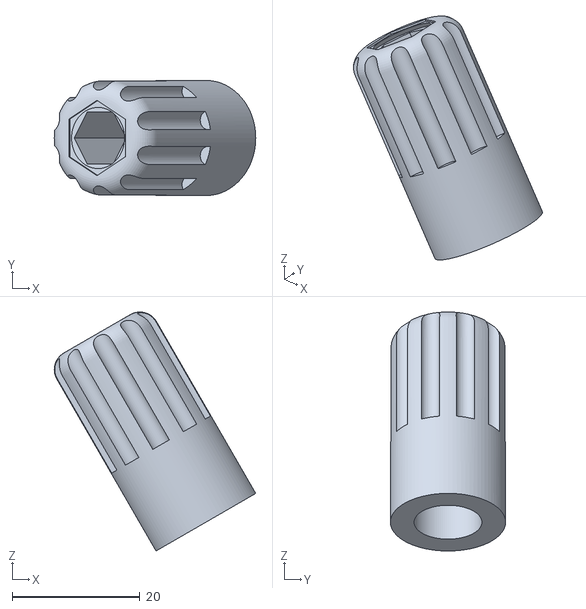
[picture p191: CAD file, 2026-11-10]
Base/stl/friction_knob.stl
31.5 x 18.0 x 37.3
