genbean/UH1-Collective/Base/stl/ref/bearing_seal.stl

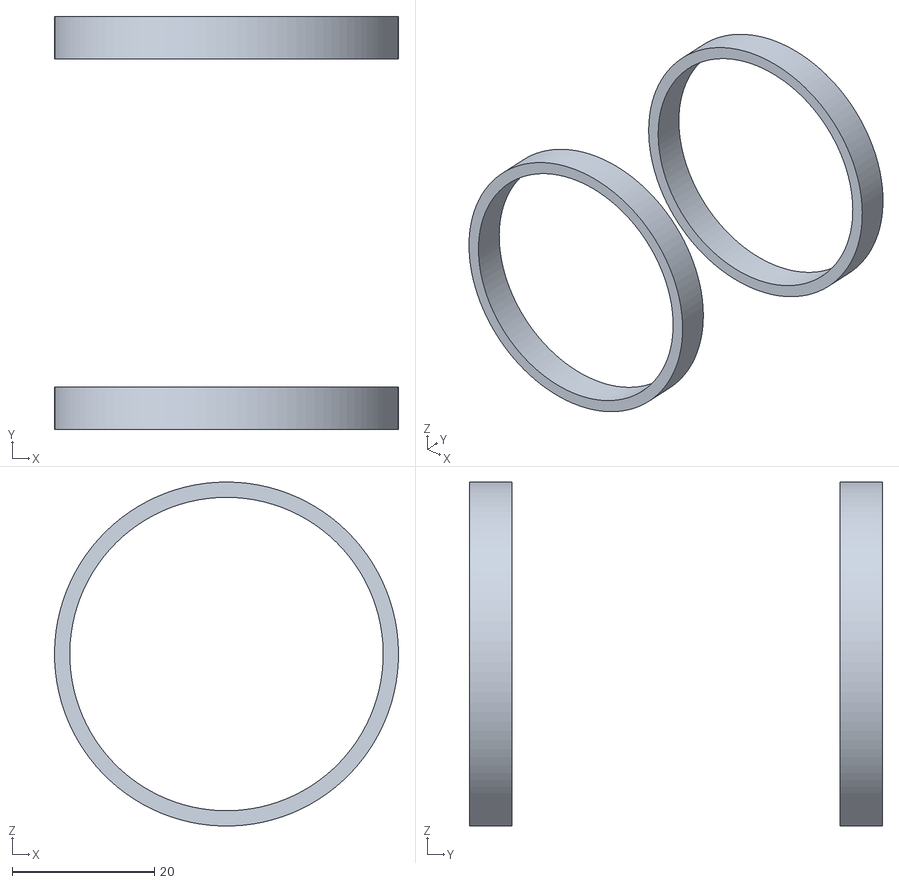
[picture p192: CAD file, 2026-11-10]
Base/stl/ref/bearing_seal.stl
48.3 x 58.0 x 48.3
