genbean/UH1-Collective/Head/Rev5/stl/HueyHeadR5-Hat2-SpringCup.stl

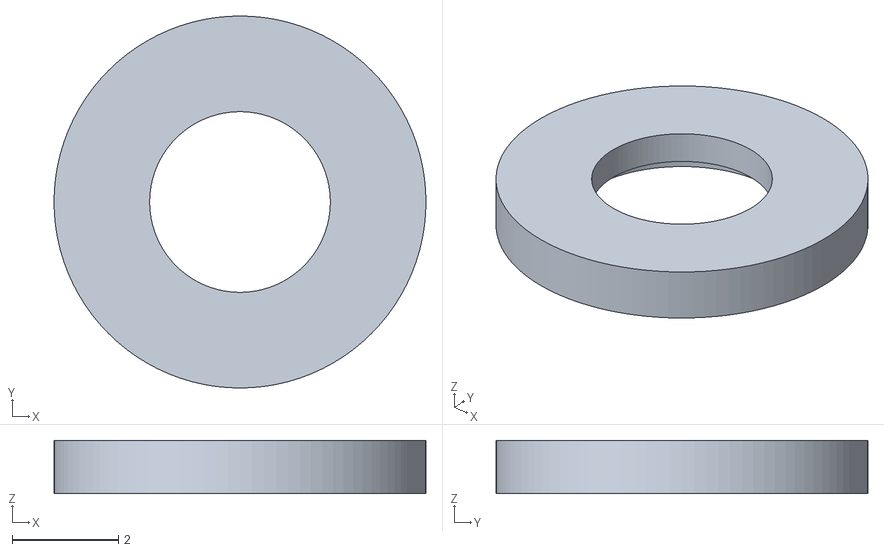
[picture p193: CAD file, 2026-11-03]
Head/Rev5/stl/HueyHeadR5-Hat2-SpringCup.stl
7.00 x 7.00 x 1.00
