genbean/UH1-Collective/Head/stl/HueyHead-LowerPanel-WhiteText.stl

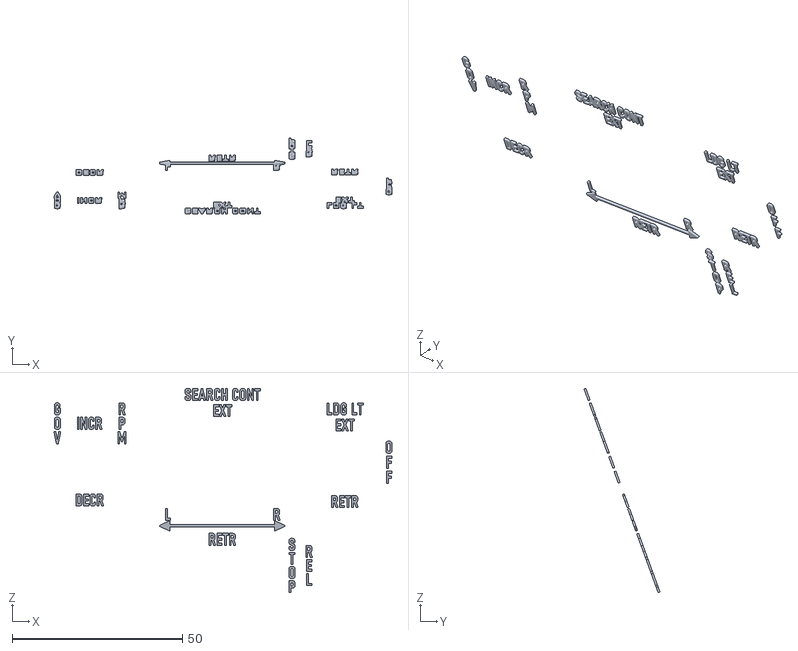
[picture p194: CAD file, 2026-10-24]
Head/stl/HueyHead-LowerPanel-WhiteText.stl
99.4 x 22.4 x 60.1
