genbean/UH1-Collective/Base/Rev4/stl/ref/sensor_wires.stl

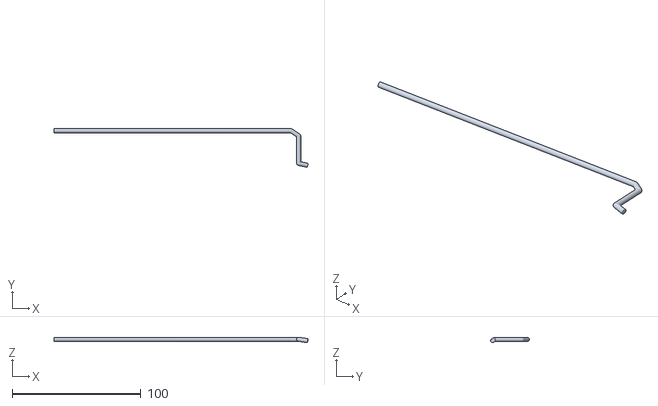
[picture p195: CAD file, 2026-11-08]
Base/Rev4/stl/ref/sensor_wires.stl
197.2 x 30.1 x 4.18
