genbean/UH1-Collective/Base/stl/cover_sensor.stl

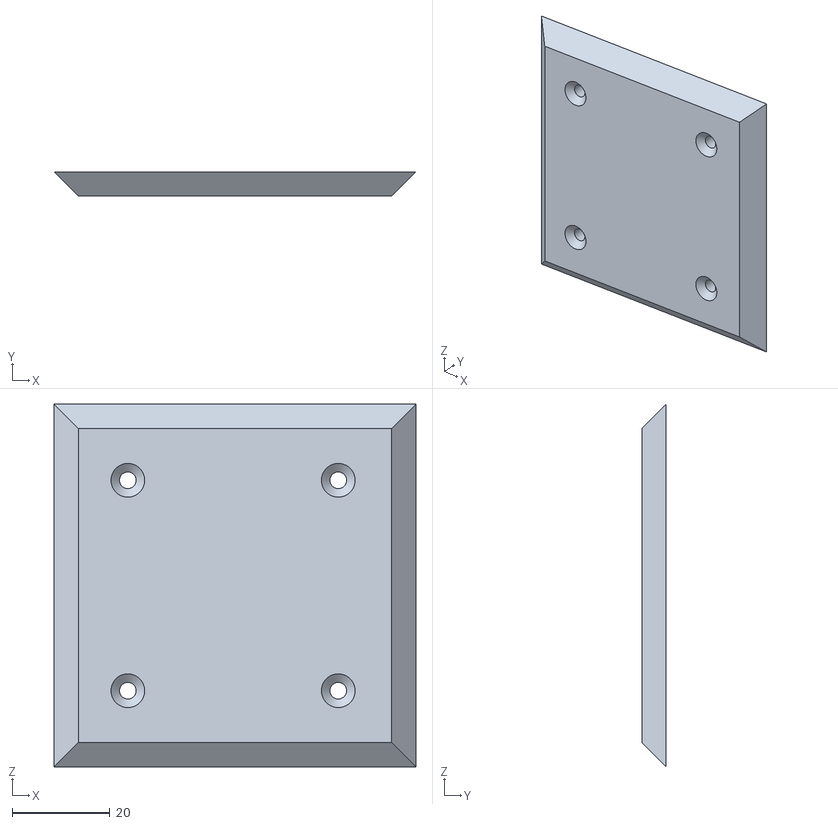
[picture p196: CAD file, 2026-11-10]
Base/stl/cover_sensor.stl
74.2 x 5.00 x 74.4
