genbean/UH1-Collective/Base/stl/ref/felt.stl

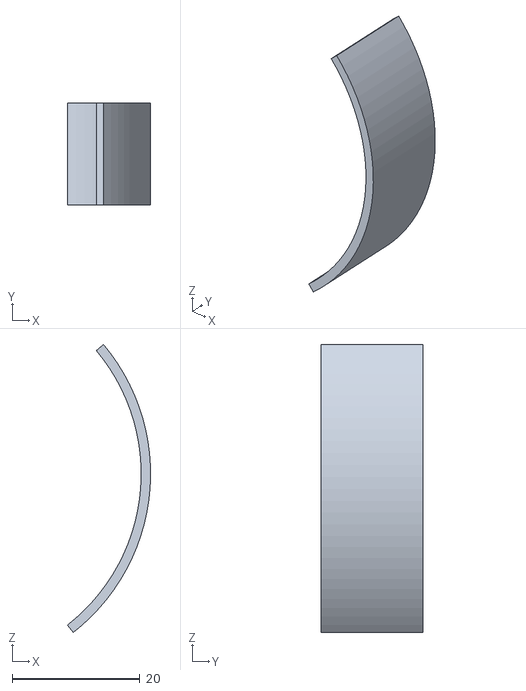
[picture p197: CAD file, 2026-11-10]
Base/stl/ref/felt.stl
13.0 x 16.0 x 45.1
