genbean/UH1-Collective/Head/Rev5/stl/HueyHeadR5-UpperPanel-Black.stl

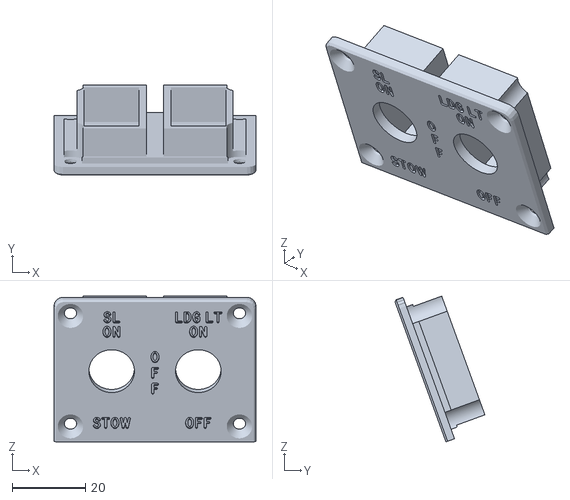
[picture p198: CAD file, 2026-11-02]
Head/Rev5/stl/HueyHeadR5-UpperPanel-Black.stl
55.0 x 24.5 x 39.7
