genbean/UH1-Collective/Head/stl/HueyHead-LowerPanel-Black.stl

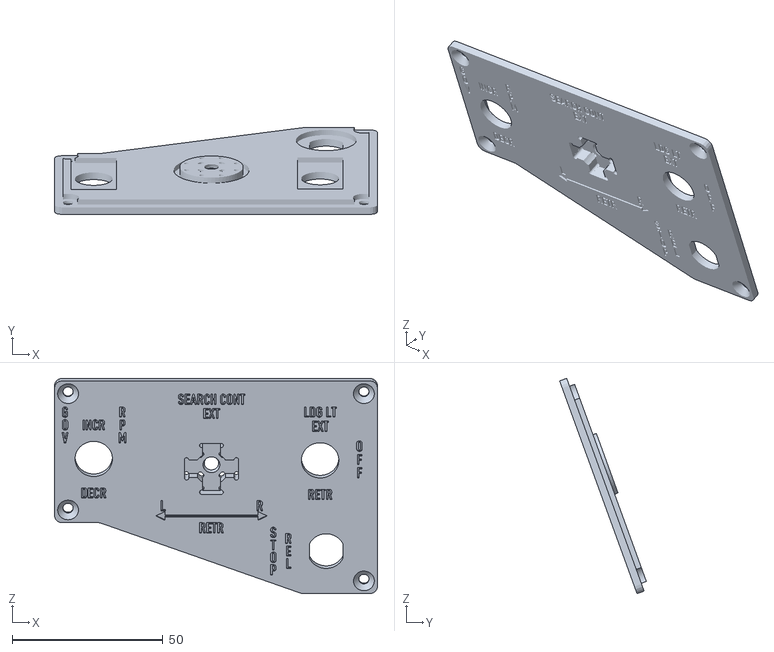
[picture p199: CAD file, 2026-10-24]
Head/stl/HueyHead-LowerPanel-Black.stl
107.0 x 28.8 x 71.3
