genbean/UH1-Collective/Base/Rev4/stl/back_plate.stl

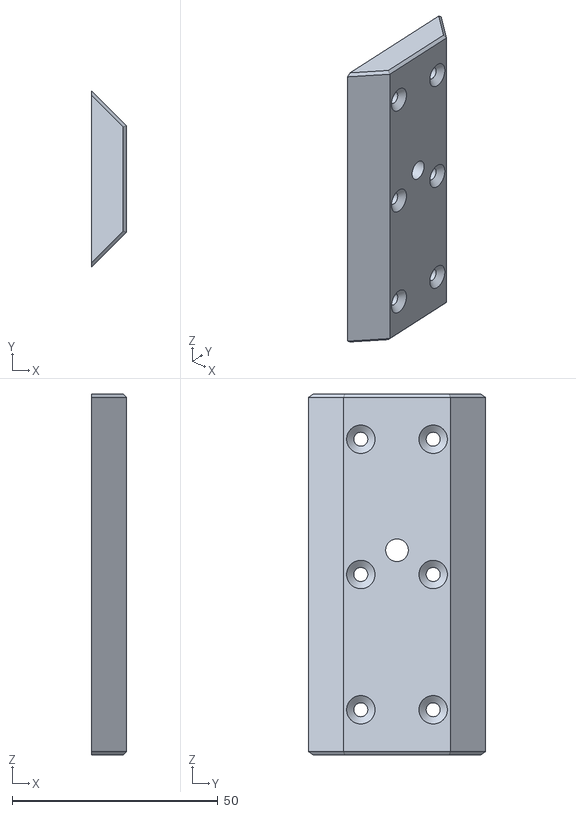
[picture p200: CAD file, 2026-11-09]
Base/Rev4/stl/back_plate.stl
8.50 x 43.0 x 87.8
