genbean/UH1-Collective/Base/Rev4/stl/ref/usb_cable.stl

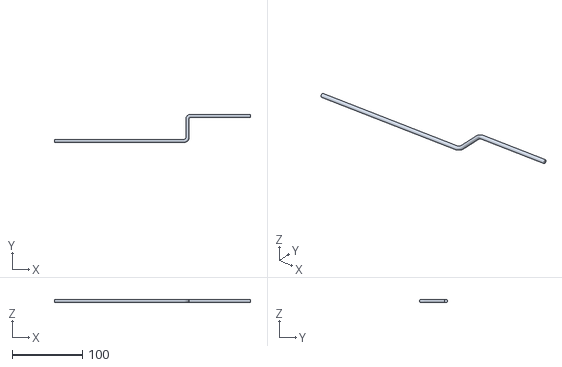
[picture p201: CAD file, 2026-11-08]
Base/Rev4/stl/ref/usb_cable.stl
280.0 x 40.1 x 4.60
