genbean/UH1-Collective/Base/stl/strap.stl

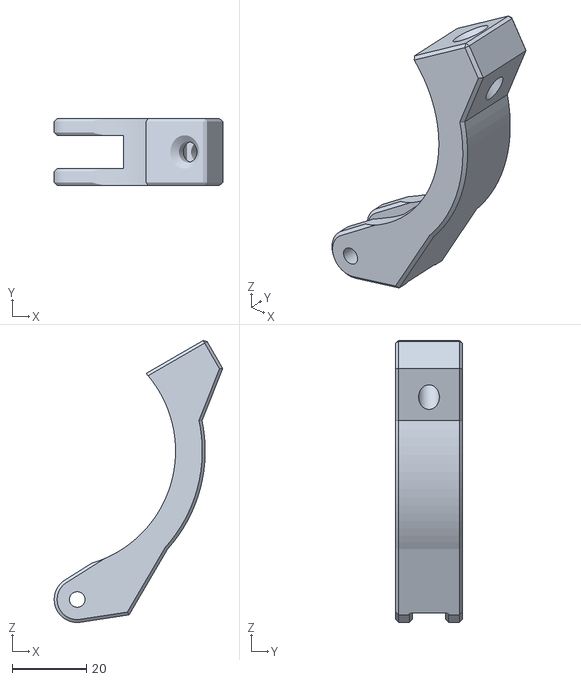
[picture p202: CAD file, 2026-11-10]
Base/stl/strap.stl
45.4 x 18.0 x 76.0
