genbean/UH1-Collective/Head/Rev5/stl/HueyHeadR5-LowerPanel-Black.stl

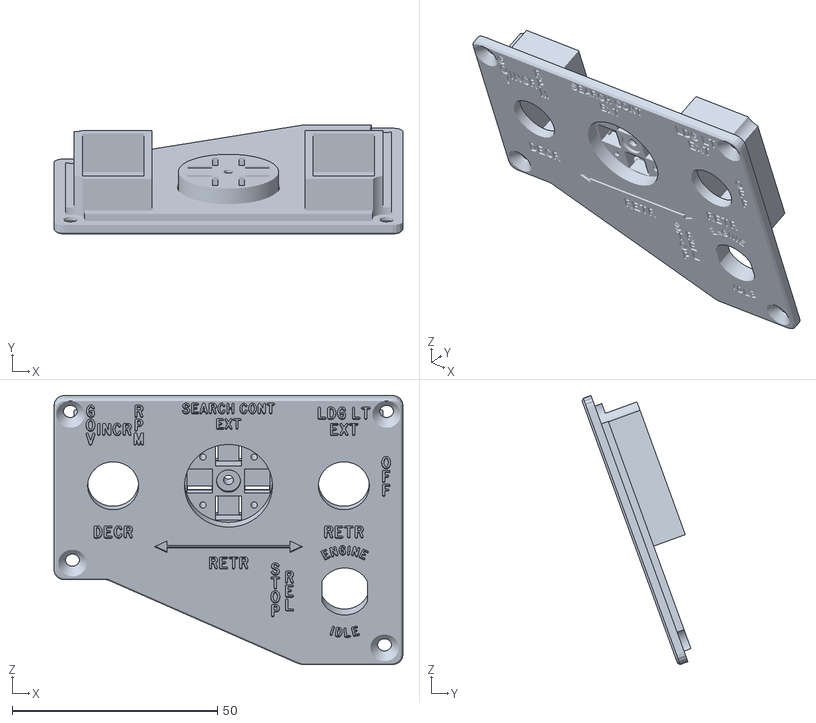
[picture p203: CAD file, 2026-11-02]
Head/Rev5/stl/HueyHeadR5-LowerPanel-Black.stl
85.0 x 26.5 x 65.5
