genbean/UH1-Collective/Base/Rev4/stl/lever_upper.stl

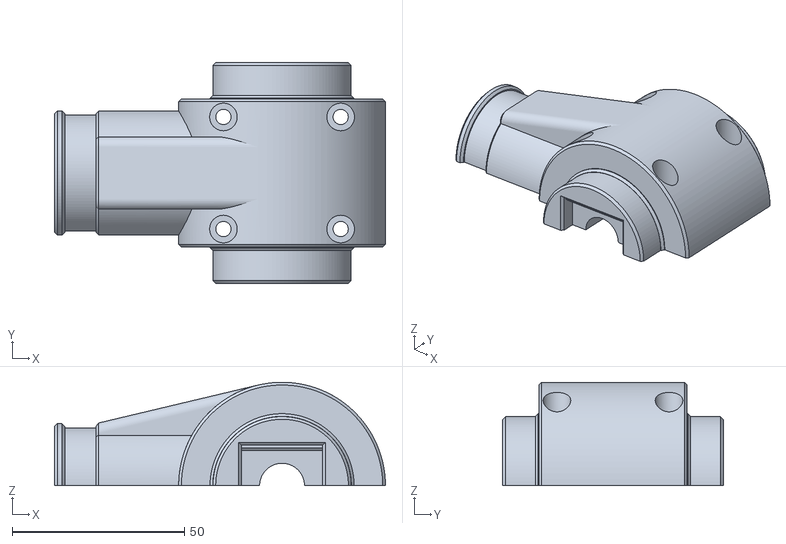
[picture p204: CAD file, 2026-11-09]
Base/Rev4/stl/lever_upper.stl
96.0 x 64.0 x 30.0
