genbean/UH1-Collective/Base/Rev4/stl/ref/bearing_inner.stl

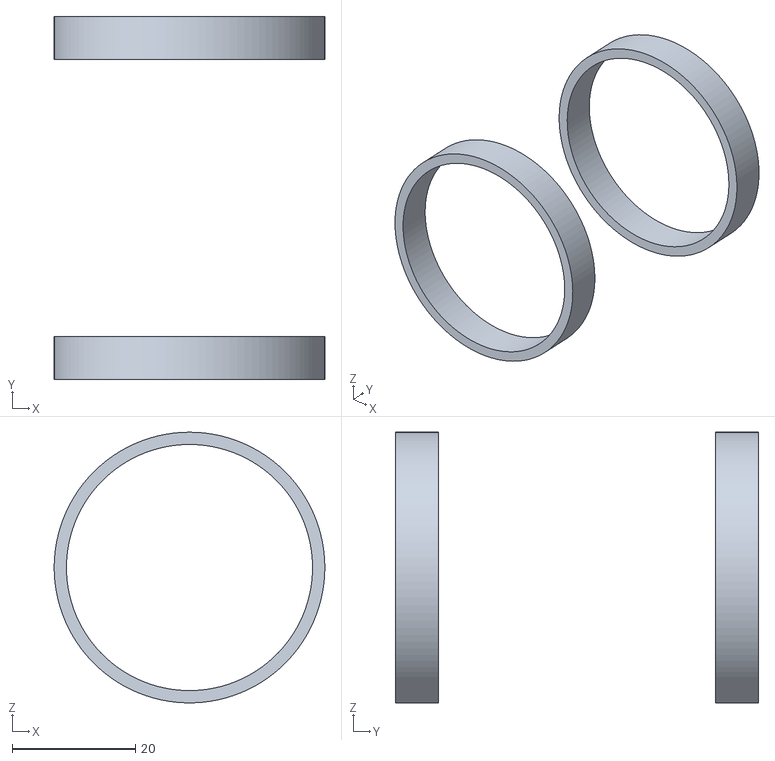
[picture p205: CAD file, 2026-11-08]
Base/Rev4/stl/ref/bearing_inner.stl
44.0 x 59.0 x 44.0
