genbean/UH1-Collective/Base/stl/ref/sensor_chip.stl

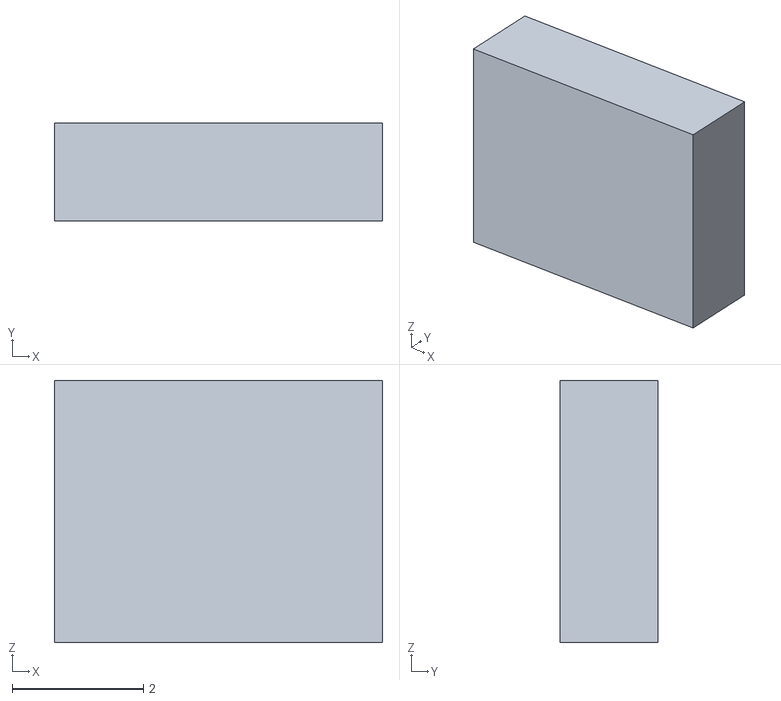
[picture p206: CAD file, 2026-11-10]
Base/stl/ref/sensor_chip.stl
5.00 x 1.50 x 4.00
