genbean/UH1-Collective/Head/Rev5/stl/HueyHeadR5-LowerPanel-WhiteText.stl

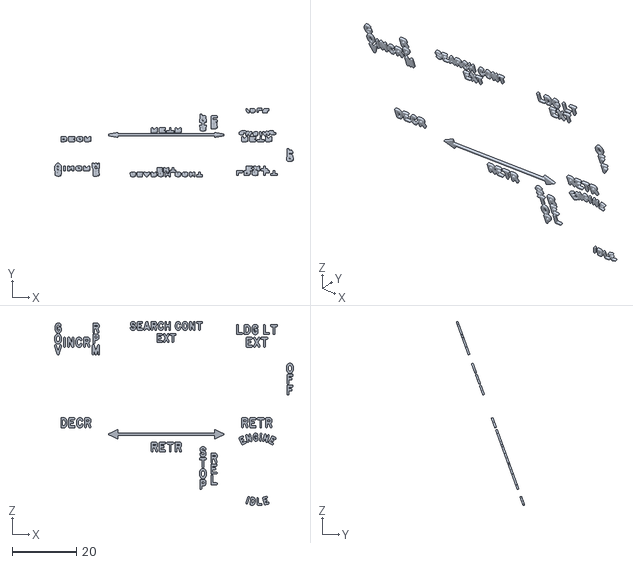
[picture p207: CAD file, 2026-10-28]
Head/Rev5/stl/HueyHeadR5-LowerPanel-WhiteText.stl
74.2 x 21.3 x 57.3
