genbean/UH1-Collective/Base/Rev4/stl/lever_lower.stl

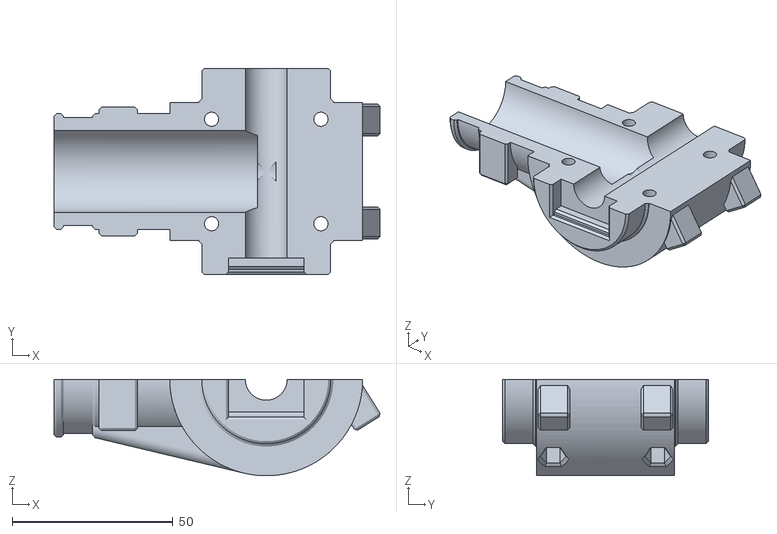
[picture p208: CAD file, 2026-11-09]
Base/Rev4/stl/lever_lower.stl
101.4 x 64.0 x 30.0
