genbean/UH1-Collective/Base/Rev4/stl/ref/carbon_tube.stl

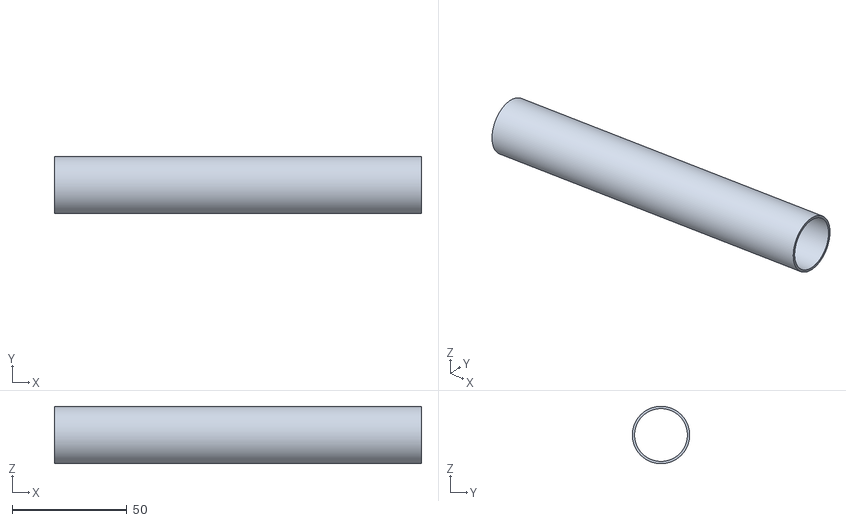
[picture p209: CAD file, 2026-11-08]
Base/Rev4/stl/ref/carbon_tube.stl
160.0 x 25.0 x 25.0
