genbean/UH1-Collective/Base/stl/cover_cable_notched.stl

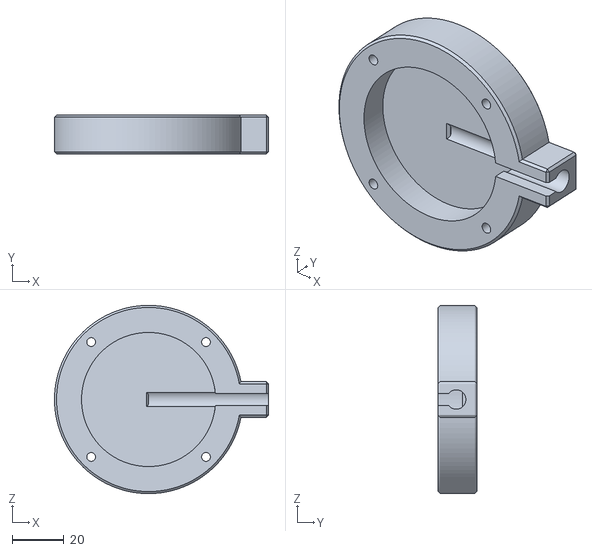
[picture p210: CAD file, 2026-11-08]
Base/stl/cover_cable_notched.stl
83.0 x 15.0 x 73.0
