genbean/UH1-Collective/Base/stl/ref/hose_clamp.stl

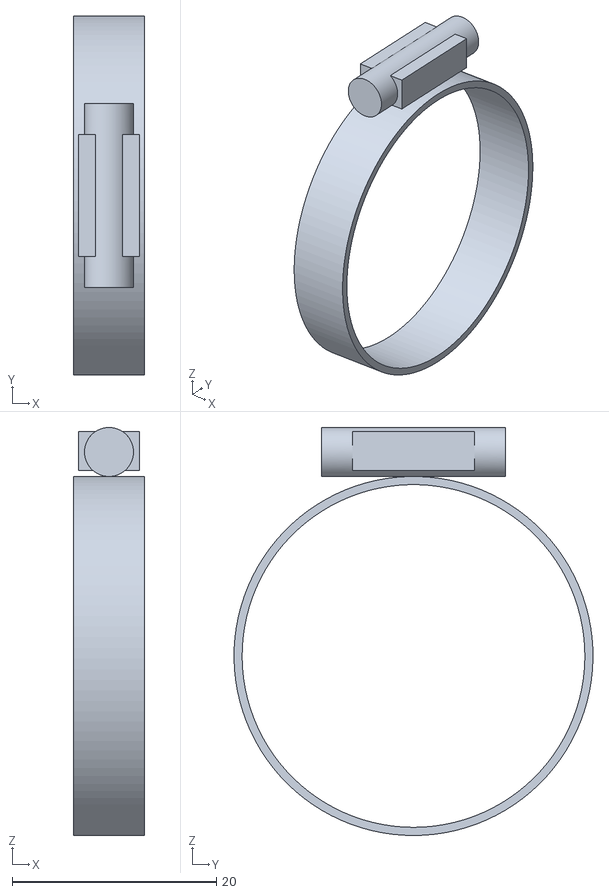
[picture p211: CAD file, 2026-11-10]
Base/stl/ref/hose_clamp.stl
7.00 x 35.2 x 40.0
