genbean/UH1-Collective/Head/Rev5/stl/HueyHeadR5-Pinion.stl

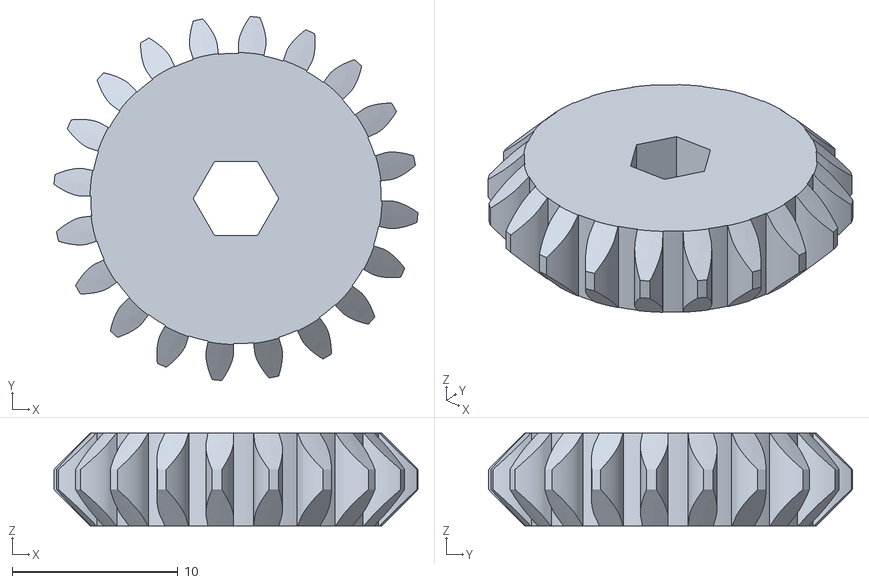
[picture p212: CAD file, 2026-10-25]
Head/Rev5/stl/HueyHeadR5-Pinion.stl
21.9 x 21.9 x 5.60
