genbean/UH1-Collective/Base/Rev4/stl/ref/bearing_outer.stl

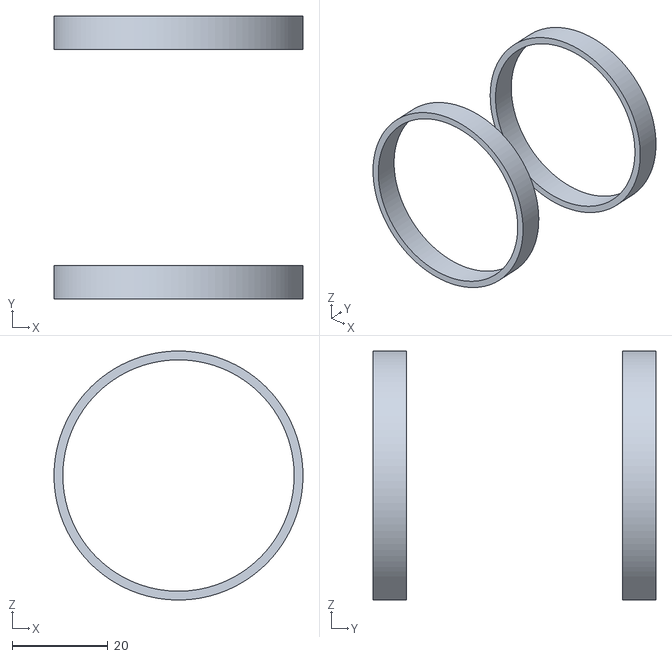
[picture p213: CAD file, 2026-11-08]
Base/Rev4/stl/ref/bearing_outer.stl
52.0 x 59.0 x 52.0
