genbean/UH1-Collective/Base/Rev4/stl/shoe.stl

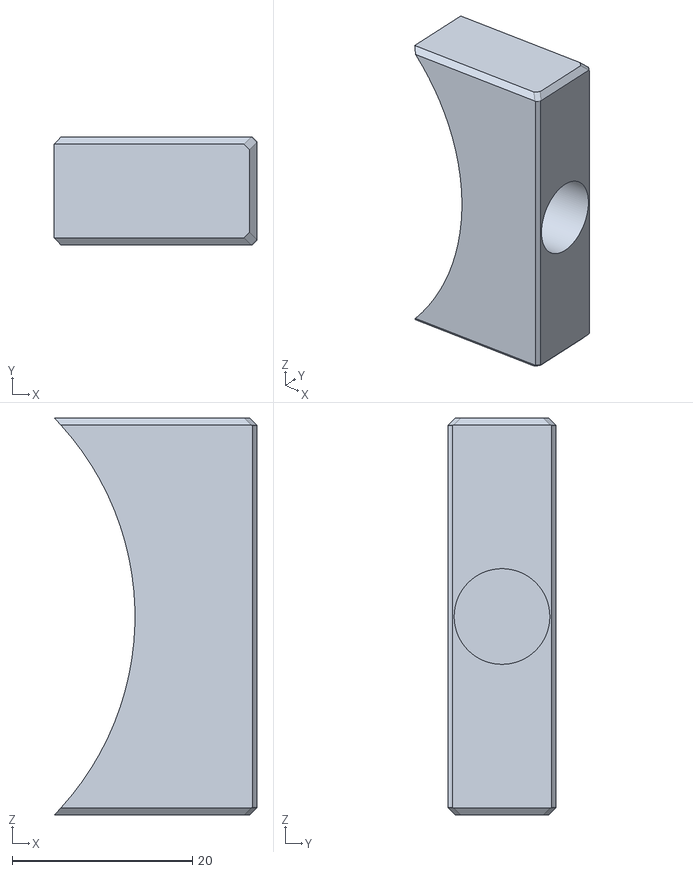
[picture p214: CAD file, 2026-11-09]
Base/Rev4/stl/shoe.stl
22.5 x 12.0 x 44.0
