genbean/UH1-Collective/Base/stl/sensor_carrier.stl

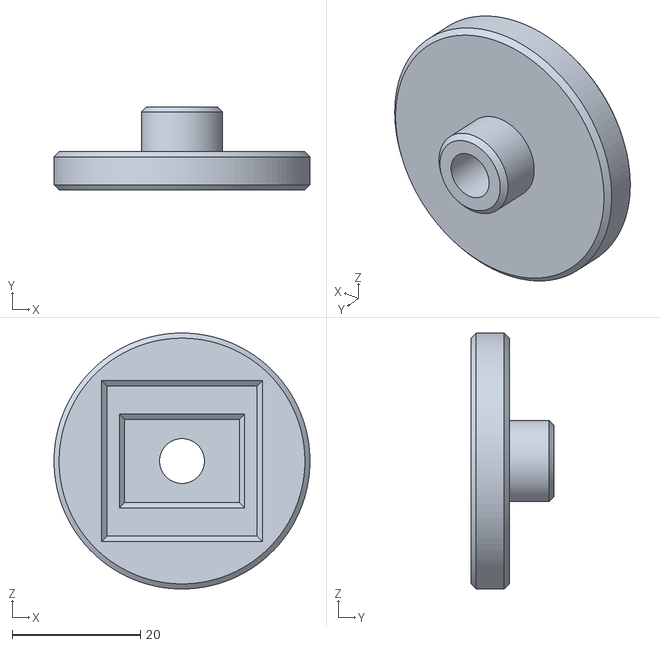
[picture p215: CAD file, 2026-10-28]
Base/stl/sensor_carrier.stl
40.0 x 13.0 x 40.0
