genbean/UH1-Collective/Head/Rev5/stl/HueyHeadR5-UpperPanel-WhiteText.stl

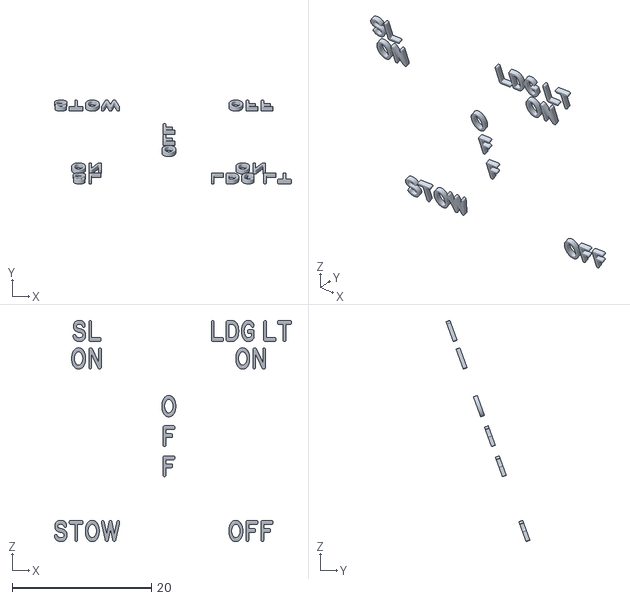
[picture p216: CAD file, 2026-10-25]
Head/Rev5/stl/HueyHeadR5-UpperPanel-WhiteText.stl
34.1 x 12.1 x 31.8
