genbean/UH1-Collective/Base/Rev4/stl/ref/felt.stl

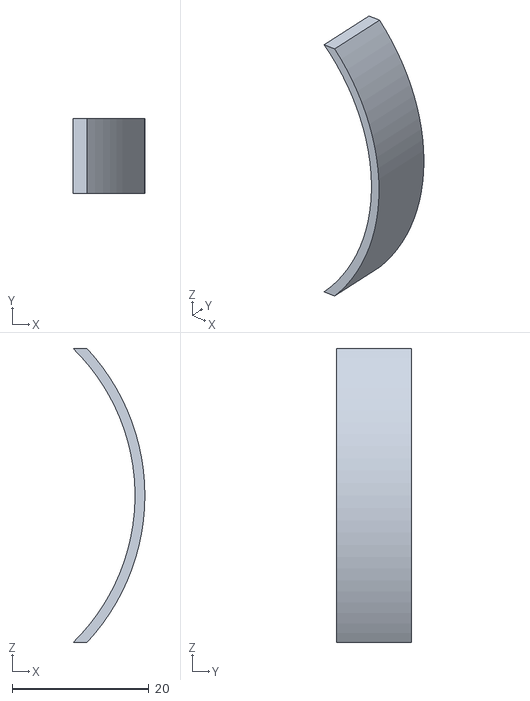
[picture p217: CAD file, 2026-11-08]
Base/Rev4/stl/ref/felt.stl
10.5 x 11.0 x 43.0
