genbean/UH1-Collective/Base/Rev4/stl/spring_cap.stl

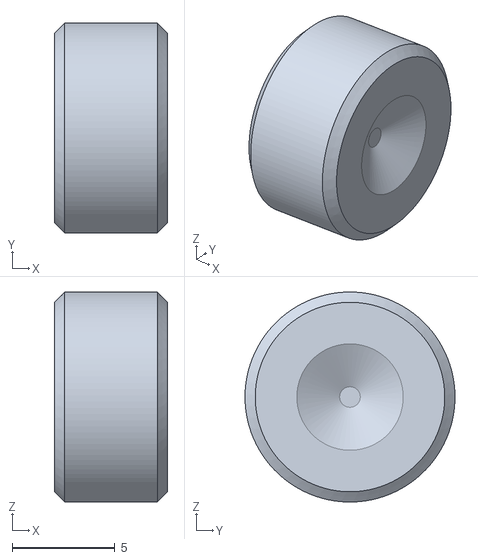
[picture p218: CAD file, 2026-11-08]
Base/Rev4/stl/spring_cap.stl
5.50 x 10.2 x 10.2
