genbean/UH1-Collective/Base/stl/cap_left.stl

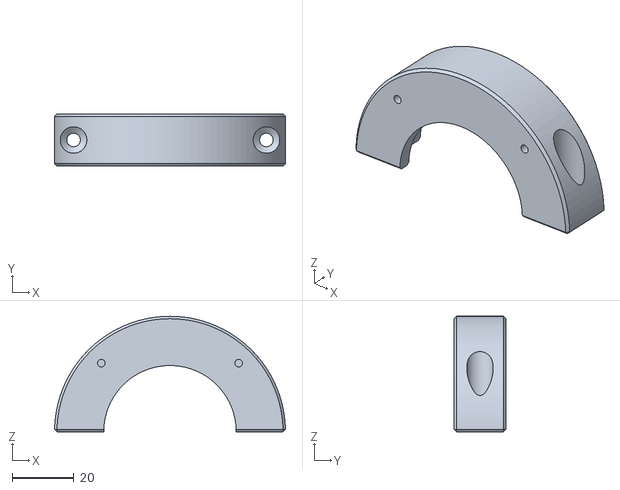
[picture p219: CAD file, 2026-10-25]
Base/stl/cap_left.stl
75.0 x 17.0 x 37.5
