genbean/UH1-Collective/Base/stl/ref/hardware.stl

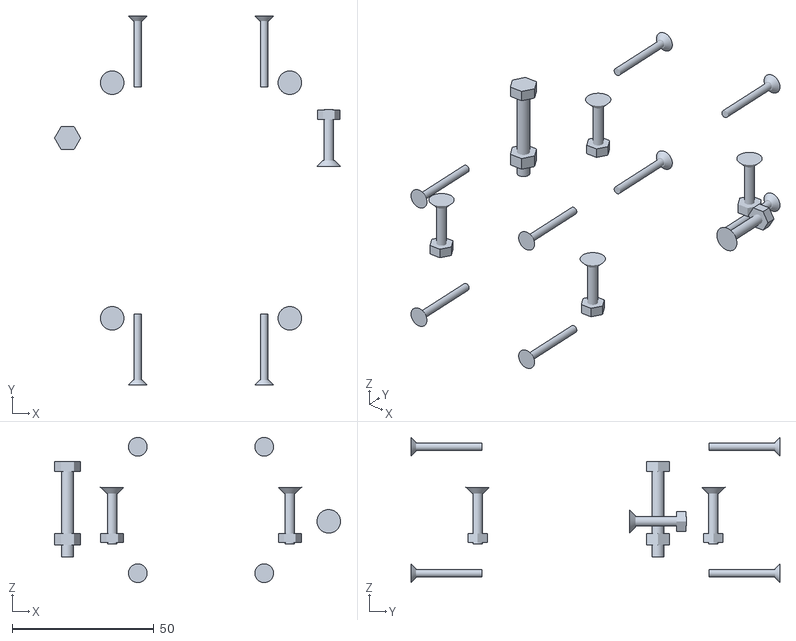
[picture p220: CAD file, 2026-11-08]
Base/stl/ref/hardware.stl
100.8 x 130.0 x 51.1
