genbean/UH1-Collective/Base/Rev4/stl/friction_knob.stl

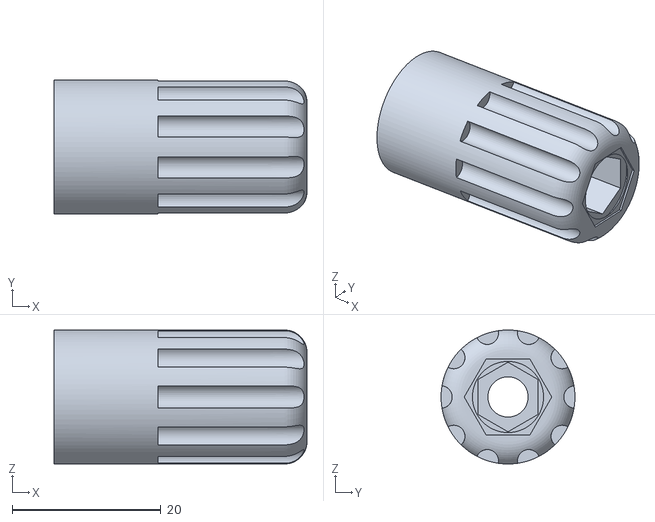
[picture p221: CAD file, 2026-11-08]
Base/Rev4/stl/friction_knob.stl
34.0 x 18.0 x 18.0
