genbean/UH1-Collective/Base/stl/lever_lower.stl

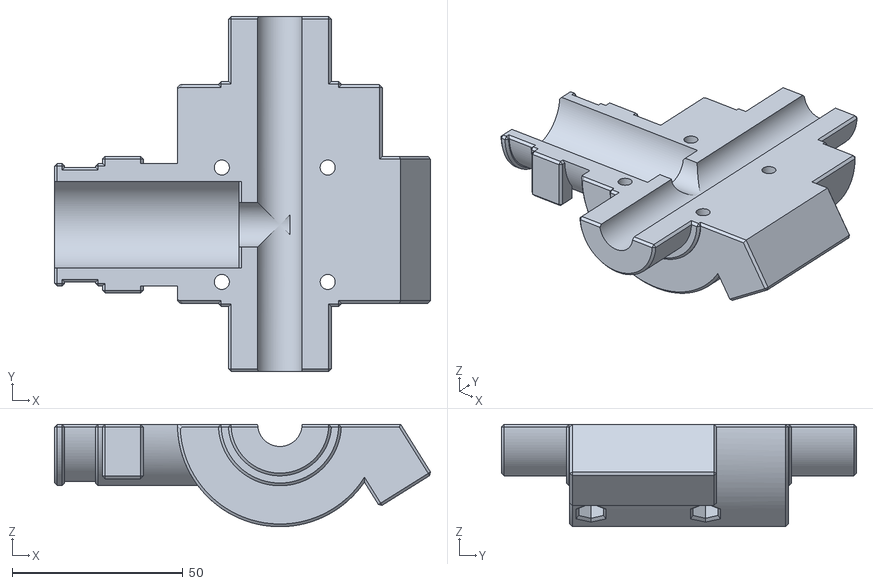
[picture p222: CAD file, 2026-10-25]
Base/stl/lever_lower.stl
110.1 x 104.0 x 30.0
