genbean/UH1-Collective/Base/Rev4/stl/strut_collar.stl

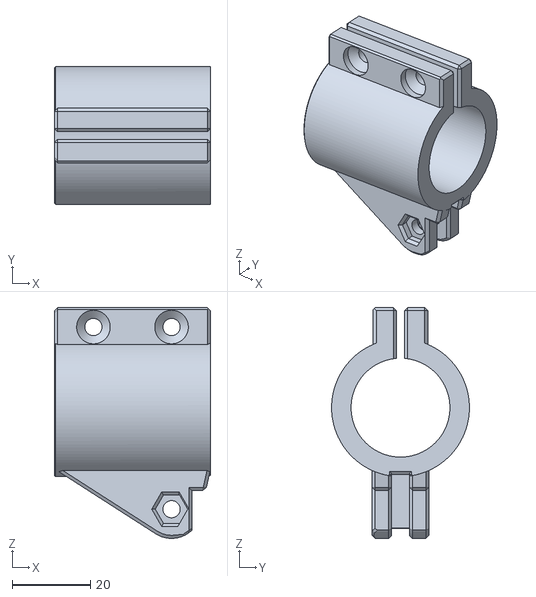
[picture p223: CAD file, 2026-11-08]
Base/Rev4/stl/strut_collar.stl
40.0 x 35.3 x 59.1
