genbean/UH1-Collective/Base/stl/ref/bearing_inner.stl

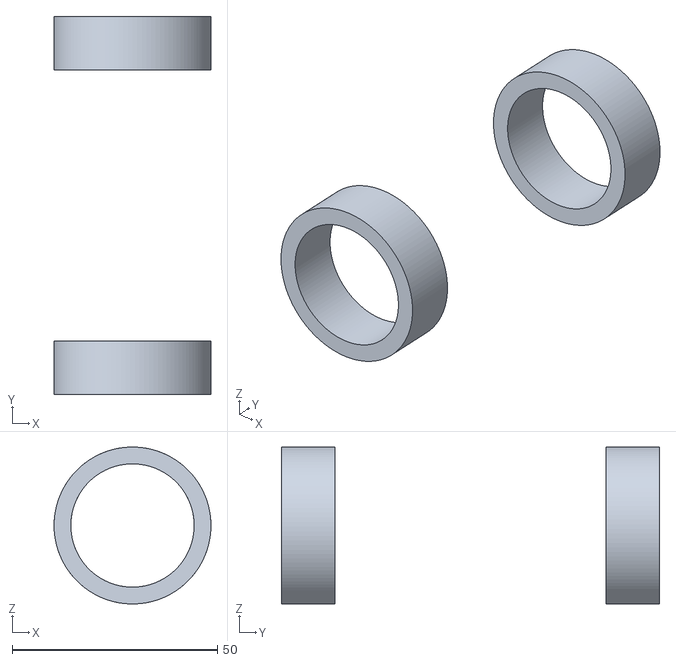
[picture p224: CAD file, 2026-10-24]
Base/stl/ref/bearing_inner.stl
38.2 x 92.0 x 38.2
