genbean/UH1-Collective/Base/Rev4/stl/cap_left.stl

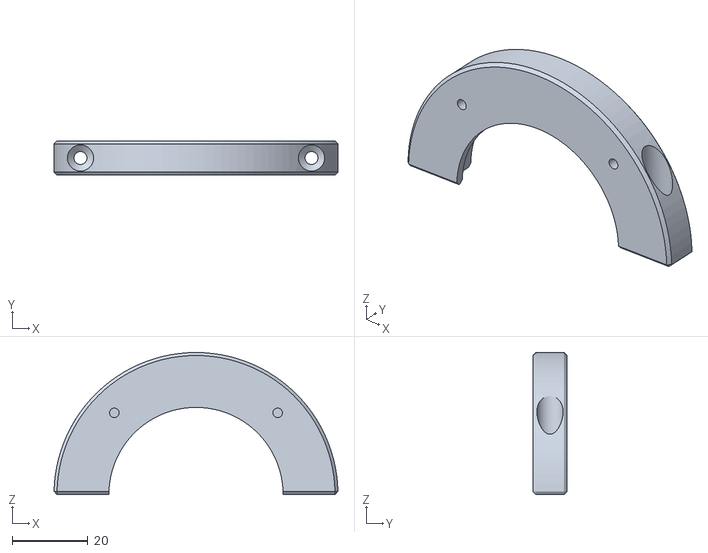
[picture p225: CAD file, 2026-11-08]
Base/Rev4/stl/cap_left.stl
75.0 x 9.00 x 37.5
