genbean/UH1-Collective/Base/stl/shoe.stl

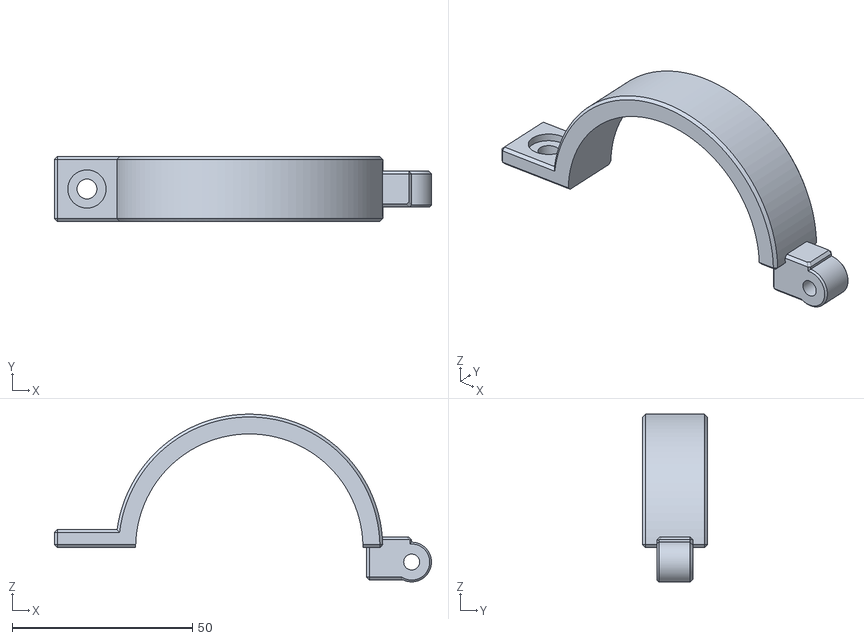
[picture p226: CAD file, 2026-10-24]
Base/stl/shoe.stl
104.5 x 18.0 x 46.5
