genbean/UH1-Collective/Base/stl/lever_upper.stl

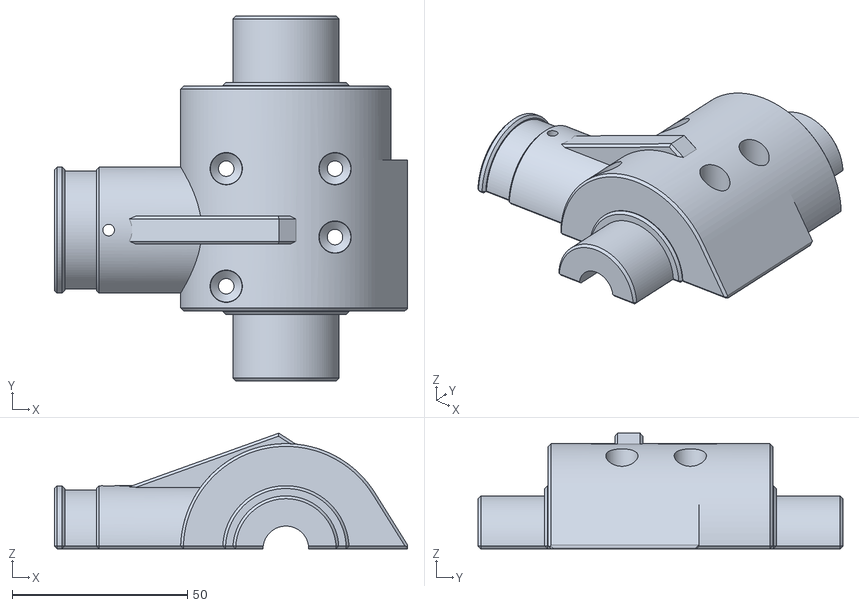
[picture p227: CAD file, 2026-10-24]
Base/stl/lever_upper.stl
100.7 x 104.0 x 33.0
