genbean/UH1-Collective/Base/stl/cable_plug.stl

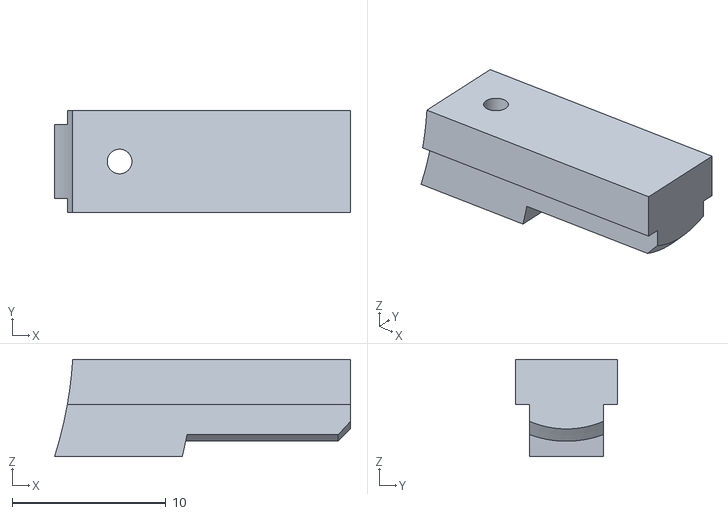
[picture p228: CAD file, 2026-10-24]
Base/stl/cable_plug.stl
19.2 x 6.60 x 6.32
