genbean/UH1-Collective/(list of files, cad)

Other CAD files:
Base/step/MkIII_Rev4_assembly.step
Head/stl/HueyHeadR5-Hat-Cap.stl
Head/stl/HueyHeadR5-LowerPanel-Black.stl
Base/Rev4/stl/coupons/coupon_bearing_seat_6808.stl
Base/Rev4/stl/lever_sensor.stl
Base/stl/shell.stl
Head/Rev5/stl/HueyHeadR5-LowerPanel3-Black.stl
Base/stl/ref/sensor_pcb.stl
Base/stl/lever_cable.stl
Base/Rev4/stl/cover_sensor.stl
Base/stl/cover_cable.stl
Base/stl/ref/gas_strut.stl
Base/Rev4/stl/ref/sensor_chip.stl
Base/stl/ref/carbon_tube.stl
Base/stl/cap_right.stl
Base/stl/ref/knob_spring.stl
Base/Rev4/stl/cap_right.stl
Base/Rev4/stl/ref/lever_screws.stl
Base/step/MkIII_Rev3_assembly.step
Base/stl/ref/lever_screws.stl
Base/stl/ref/sensor_screws.stl
Head/Rev3/stl/HueyHeadR3-FrictionCollar.stl
Head/Rev3/stl/HueyHeadR3-NeckBlock.stl
Head/Rev3/stl/HueyHeadR3-SensorSeatCoupon.stl
Head/Rev3/stl/ref/magnet.stl
Head/Rev3/stl/ref/tube.stl
Head/Rev4/stl/HueyHeadR4-Body.stl
Head/Rev4/stl/HueyHeadR4-Hat-Cap.stl
Head/Rev4/stl/HueyHeadR4-LowerPanel-Black.stl
Head/Rev4/stl/HueyHeadR4-Pinion.stl
Head/Rev4/stl/HueyHeadR4-UpperPanel-Black.stl
Head/Rev4/stl/HueyHeadR4-UpperPanel-WhiteText.stl
Head/stl/ref/m5_bolt.stl
