genbean/UH1-Collective/Head/reference/dcval/uh1-manual-page.png

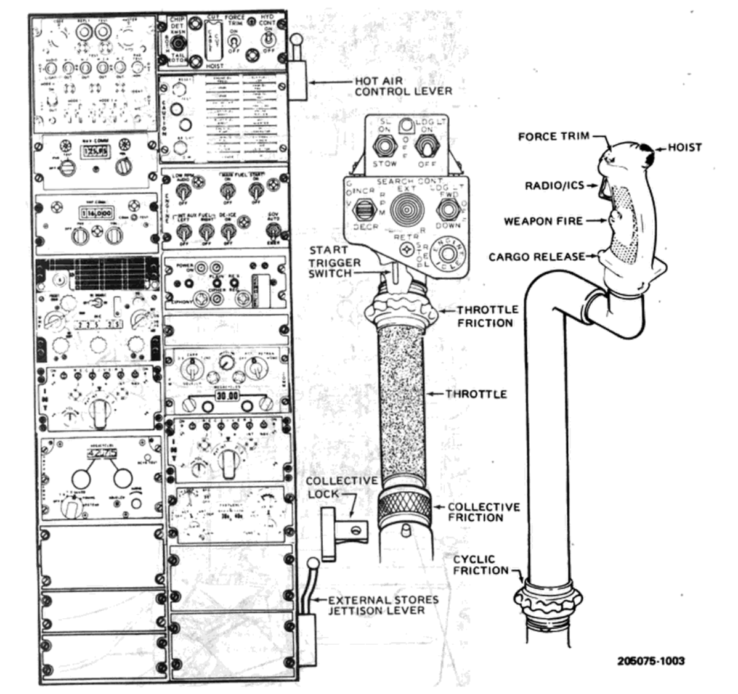
Head/reference/dcval/uh1-manual-page.png
