genbean/UH1-Collective/Head/renders/HueyHead_Rev2_Assembly.png

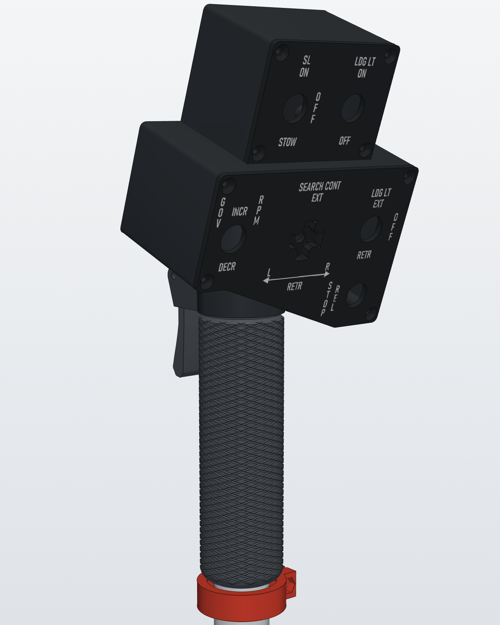
Head/renders/HueyHead_Rev2_Assembly.png
