genbean/UH1-Collective/PCB/HeliSR/tools/HeliSR_Rev3.0_reference.kicad_pcb

## KiCad design PCB/HeliSR/tools/HeliSR_Rev3.0_reference.kicad_pcb (2026-11-10)

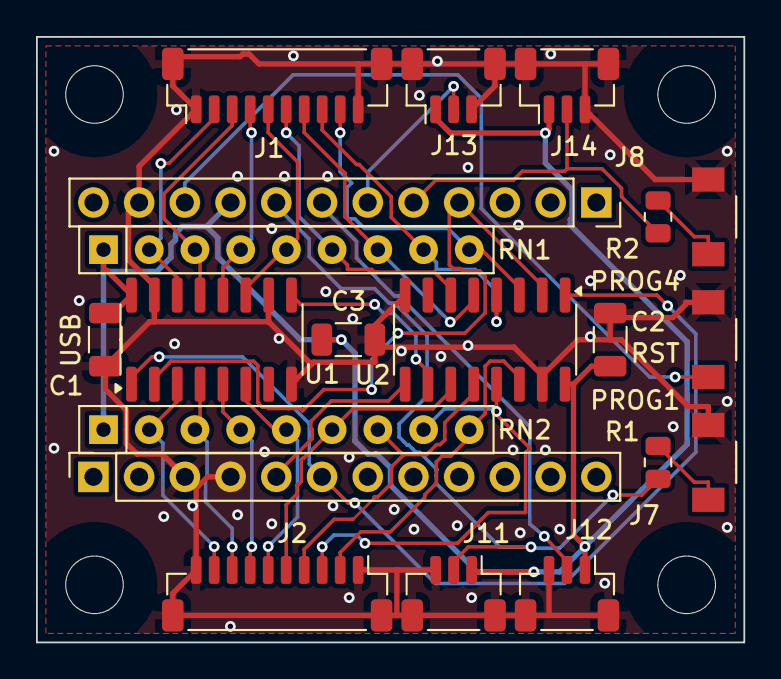
[picture p231: board HeliSR_Rev3.0_reference.kicad_pcb from above]

Board: 2 copper layers, 39.3 x 33.6 mm, 24 parts (0 on the bottom side), 29 nets.

Parts:
C1, C2: 100nF; C_1206_3216Metric
C3: 22uF; C_1206_3216Metric
H1, H2, H3, H4: M3; MountingHole_3.2mm_M3
J1: Inputs 1-8; JST_SH_BM10B-SRSS-TB_1x10-1MP_P1.00mm_Vertical
J2: Inputs 9-16; JST_SH_BM10B-SRSS-TB_1x10-1MP_P1.00mm_Vertical
J7: Pro Micro pins 1-12; PinSocket_1x12_P2.54mm_Vertical
J8: Pro Micro pins 13-24; PinSocket_1x12_P2.54mm_Vertical
J11: AX1; JST_SH_BM03B-SRSS-TB_1x03-1MP_P1.00mm_Vertical
J12: AX2; JST_SH_BM03B-SRSS-TB_1x03-1MP_P1.00mm_Vertical
J13: AX3; JST_SH_BM03B-SRSS-TB_1x03-1MP_P1.00mm_Vertical
J14: AX4; JST_SH_BM03B-SRSS-TB_1x03-1MP_P1.00mm_Vertical
R1, R2: 1k; R_0805_2012Metric
RN1, RN2: 10k x8 bussed; R_Array_SIP9
SW1, SW2, SW3: TL1015AF160QG; SW_TL1015AF160QG
U1, U2: 74HC165; SOIC-16_3.9x9.9mm_P1.27mm

Connections:
AX1: J8.20, J11.2, R1.1
AX2: J8.19, J12.2
AX3: J8.18, J13.2
AX4: J8.17, J14.2, R2.1
GND: C1.2, C2.2, C3.2, J1.1, J1.10, J1.MP, J2.1, J2.10, J2.MP, J7.3, J7.4, J8.23, J11.3, J11.MP, J12.3, J12.MP, J13.3, J13.MP, J14.3, J14.MP, SW1.2, SW2.2, SW3.2, U1.8, U1.10, U1.15, U2.8, U2.15
IN1: J1.2, RN1.2, U1.14
IN2: J1.3, RN1.3, U1.13
IN3: J1.4, RN1.4, U1.12
IN4: J1.5, RN1.5, U1.11
IN5: J1.6, RN1.6, U2.6
IN6: J1.7, RN1.7, U2.5
IN7: J1.8, RN1.8, U2.4
IN8: J1.9, RN1.9, U2.3
IN9: J2.2, RN2.9, U2.14
IN10: J2.3, RN2.8, U2.13
IN11: J2.4, RN2.7, U2.12
IN12: J2.5, RN2.6, U2.11
IN13: J2.6, RN2.5, U1.6
IN14: J2.7, RN2.4, U1.5
IN15: J2.8, RN2.3, U1.4
IN16: J2.9, RN2.2, U1.3
PROG1: R1.2, SW2.1
PROG4: R2.2, SW3.1
RST: J8.22, SW1.1
SR_CHAIN: U1.9, U2.10
SR_CLK: J8.16, U1.2, U2.2
SR_DATA: J7.5, U2.9
SR_LOAD: J7.6, U1.1, U2.1
VCC: C1.1, C2.1, C3.1, J8.21, J11.1, J12.1, J13.1, J14.1, RN1.1, RN2.1, U1.16, U2.16
