genbean/UH1-Collective/PCB/SearchHat/SearchHat_Rev1.0.kicad_pcb

## KiCad design PCB/SearchHat/SearchHat_Rev1.0.kicad_pcb (2026-11-10)

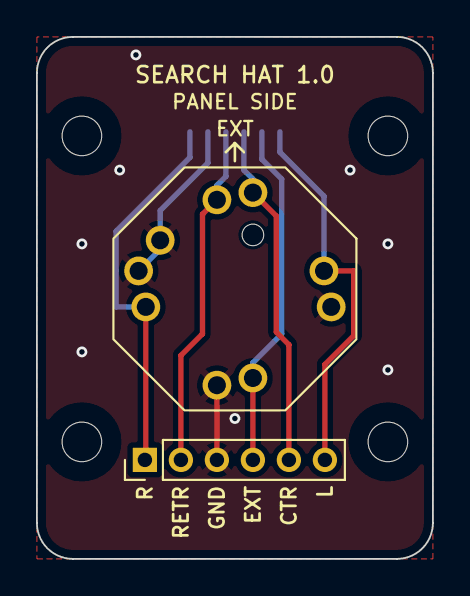
[picture p232: board SearchHat_Rev1.0.kicad_pcb from above]

Board: 2 copper layers, 22.0 x 29.0 mm, 7 parts (1 on the bottom side), 6 nets.

Parts:
H1, H2, H3, H4: M2; MountingHole_2.2mm_M2
J1: JST SM06B-SRSS-TB; JST_SH_SM06B-SRSS-TB_1x06-1MP_P1.00mm_Horizontal
J2: Wire pads, 2 mm; PinHeader_1x06_P2.00mm_Vertical
SW1: ALPS RKJXM1015004; SW_ALPS_RKJXM1015004

Connections:
CTR: J1.4, J2.5, SW1.1 (COM)
EXT: J1.5, J2.4, SW1.2 (A)
GND: J1.2, J1.MP, J2.3, SW1.6 (PUSH), SW1.7 (GND)
L: J1.6, J2.6, SW1.3 (B)
R: J1.1, J2.1, SW1.5 (D)
RETR: J1.3, J2.2, SW1.4 (C)
