genbean/UH1-Collective/Software/profiles/Default (16 buttons, 4 axes).cfg

[DeviceUsbConfig]
ConfigVersion=2
DeviceName=HeliSR
Vid=1b4f
Pid=9206
USBExchange=5

[PinsConfig]
TX=0
RX=0
4=0
5=0
6=0
7=0
8=0
9=0
10=0
14=0
16=0

[ShiftConfig]
Shift0=-1
Shift1=-1
Shift2=-1
Shift3=-1
Shift4=-1

[TimersConfig]
Timer1=50
Timer2=200
Timer3=300
Debounce=20
A2bDebounce=50
EncoderPress=20
ButtonsPolling=1
EncodersPolling=1

[ButtonsConfig_0]
ButtonPhysicNumber=0
ButtonType=0
ShiftMod=0
Inverted=0
Disabled=0
DelayTimer=0
PressTimer=0

[ButtonsConfig_1]
ButtonPhysicNumber=1
ButtonType=0
ShiftMod=0
Inverted=0
Disabled=0
DelayTimer=0
PressTimer=0

[ButtonsConfig_2]
ButtonPhysicNumber=2
ButtonType=0
ShiftMod=0
Inverted=0
Disabled=0
DelayTimer=0
PressTimer=0

[ButtonsConfig_3]
ButtonPhysicNumber=3
ButtonType=0
ShiftMod=0
Inverted=0
Disabled=0
DelayTimer=0
PressTimer=0

[ButtonsConfig_4]
ButtonPhysicNumber=4
ButtonType=0
ShiftMod=0
Inverted=0
Disabled=0
DelayTimer=0
PressTimer=0

[ButtonsConfig_5]
ButtonPhysicNumber=5
ButtonType=0
ShiftMod=0
Inverted=0
Disabled=0
DelayTimer=0
PressTimer=0

[ButtonsConfig_6]
ButtonPhysicNumber=6
ButtonType=0
ShiftMod=0
Inverted=0
Disabled=0
DelayTimer=0
PressTimer=0

[ButtonsConfig_7]
ButtonPhysicNumber=7
ButtonType=0
ShiftMod=0
Inverted=0
Disabled=0
DelayTimer=0
PressTimer=0

[ButtonsConfig_8]
ButtonPhysicNumber=8
ButtonType=0
ShiftMod=0
Inverted=0
Disabled=0
DelayTimer=0
PressTimer=0

[ButtonsConfig_9]
ButtonPhysicNumber=9
ButtonType=0
ShiftMod=0
Inverted=0
Disabled=0
DelayTimer=0
PressTimer=0

[ButtonsConfig_10]
ButtonPhysicNumber=10
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
InputNum=-1
LedType=0
Timer=15

[LedsConfig_Pin8]
InputNum=-1
LedType=0
Timer=15

[LedsConfig_Pin9]
InputNum=-1
LedType=0
Timer=15

[LedsConfig_Pin10]
InputNum=-1
LedType=0
Timer=15

[LedsConfig_Pin14]
InputNum=-1
LedType=0
Timer=15

[LedsConfig_Pin16]
InputNum=-1
LedType=0
Timer=15
