genbean/UH1-Collective/Software/configurator/src/widgets/led/ledconfig.h

#ifndef LEDCONFIG_H
#define LEDCONFIG_H

#include <QWidget>
#include "global.h"

class LED;
class LedRGBConfig;

namespace Ui {
class LedConfig;
}

class LedConfig : public QWidget
{
    Q_OBJECT

public:
    explicit LedConfig(QWidget *parent = nullptr);
    ~LedConfig();

    void setLedsState();

    void readFromConfig();
    void writeToConfig();

    void retranslateUi();

    //void ButtonLEDStateChanged();     // future

signals:
    void hostLedMaskChanged(uint32_t bitmask);

public slots:
    void spawnLeds(int ledCount);
    void ledPwmSelected(Pin pin, bool selected);
    void ledRgbSelected(Pin pin, bool selected);
    void onLedToggled(int ledNumber, bool state);

private:
    Ui::LedConfig *ui;

    LedRGBConfig *m_ledsRgb;

    QList<LED *> m_ledPtrList;
    int m_currentLedCount;
    uint32_t m_hostLedMask = 0;

    void setEnabledTimers(bool enabled);
};

#endif // LEDCONFIG_H
