genbean/UH1-Collective/(commit log)

2026-10-25 HeliSR firmware: FreeJoy port for the Pro Micro on HeliSR Rev 3.0 (phases 0-3)
    Firmware (Software/firmware/HeliSR), an Arduino sketch for the ATmega32U4:
    - USB: joystick plus a settings channel; layout, name, IDs and serial from
    EEPROM. Works around an Arduino core bug (USB_Flush(CDC_TX) with CDC off).
    - FreeJoy's button, axis, axis-to-button, encoder and LED logic, ported and
    matched to FreeJoy's behaviour; three FreeJoy bugs fixed.
    - Settings in EEPROM with a CRC; bootloader entry for flashing from the app.
    Tests (Software/firmware/test):
    - PC scenario tests of the firmware's own logic (192 checks).
    - Comparison with FreeJoy's original code: 2,000/2,000 random setups identical.
    - Lock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
2026-10-25 HeliSR Configurator: FreeJoyConfiguratorQt adapted to HeliSR (phase 4)
    - Rebranded (HeliSRConfigurator.exe, Documents\HeliSR, new icon); FreeJoy
    logos and wiki links removed, About credits FreeJoyConfiguratorQt.
    - Uses the firmware's shared settings and protocol headers; factory
    settings moved to shared/helisr_defaults.h (firmware size unchanged).
    - USB rewritten for HeliSR's command/reply protocol: INFO check, live
    data, READ, WRITE + COMMIT, reconnect after the board restarts.
    - Board page replaces the Blue Pill pin page: IN1-IN16, AX1-AX4 with live
    readings, spare Pro Micro pins, summary, AS5600 programming helper.
    - Buttons pick inputs by name, Switch center type; encoders, LEDs/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
2026-10-25 HeliSR release packaging: installer and portable zip (phase 5)
    - packaging/build-release.ps1 builds both firmware variants and the
    configurator, deploys Qt with windeployqt, bundles avrdude 8.0
    (Arduino build), the firmware as firmware/HeliSR_16MHz.hex and
    HeliSR_8MHz.hex, and the licences; then an Inno Setup installer,
    a portable zip and SHA256SUMS.
    - packaging/HeliSRConfigurator.iss: FreeJoy's script rewritten for
    HeliSR (own AppId, per-user install, Windows 10+ x64).
    - THIRD-PARTY-NOTICES.txt, the LGPL-3 text for Qt, a quick-start
    README.txt, and a release checklist (attach avrdude's source).
    - CLI: progress prints each step once.
    Tested: silent install, the installed app wit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
2026-10-25 HeliSR docs and example profiles (phase 7); 16 MHz Pro Micro only
    - Only the 5 V / 16 MHz Pro Micro is supported: the 8 MHz firmware build
    and the flasher's build choice are removed; releases ship one .hex.
    - docs/: quick start, user guide (every page, button type and axis
    setting, as the firmware behaves), flashing and recovery, AS5600
    guide, profiles, development notes. README.md rewritten for builders.
    - profiles/: Default, UH-1 collective (the Huey head's controls, middle
    switch positions, collective on Z, throttle on Rz with a cutoff
    button) and a button-box example, made by make_profiles.py.
    - The app copies the bundled examples to Documents\HeliSR\configs\examples;
    --save-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
2026-10-25 UH-1 profile: no throttle cutoff (the Rev 4 throttle has none)
    The Rev 4 head's throttle runs from an idle stop to full open, with no
    cutoff range or idle gate; the first profile took a cutoff from the
    Rev 2 head README. The profile's cutoff button and Rz axis range are
    gone (16 buttons now), and the AS5600 guide programs the throttle from
    the idle stop to full open. Generic docs no longer cite a cutoff.
    Checked: the profiles through every page, and on the Pro Micro written,
    read back identical; Windows sees the UH-1 profile as 16 buttons, 2 axes.
2026-10-25 Top-level README: the project's landing page
    What the collective is, a render, every folder with its README, the
    parts in outline from the BOM, the build order, status, and credits
    and licences (GPL-3; Software/ GPL-3-or-later as a FreeJoy fork; the
    original MkII collective under CC BY 4.0). Written in its own session
    from the current Base, Head Rev 4, PCB, BOM and Software READMEs.
2026-10-25 Remove obsolete files: MMJoy2, FreeJoy source, old Arduino sketch, head Rev 2
    Drop the third-party reference copies, the superseded Firmware/ sketch,
    head Rev 2 (kept Head/source for Rev 4's grip) and a duplicate PCB zip.
    Update READMEs that referred to them.
2026-10-25 Head Rev 5 at the real panel dimensions; Rev 4 straight lead hole, hat plate fix
    - Head/Rev5: Rev 4 with the box and panels cut to the measured UH-1 panels
    (lower 85 x 69.01/47.03 mm, upper 55 x 41 mm), switches placed after the
    user's drawing, labels redone, 22 mm hat cap, and check_r5.py, a
    collision check over every part, switch and the HeliSR board.
    - Rev 4: the starter leads' bent duct is now one straight round 4 mm hole
    (LEAD_HOLE); neck_solid is cut to the box 0.02 mm into the walls, so no
    hidden seams. Body and sensor-seat coupon rebuilt from this code only.
    - Rev 4 hat: the rocker plate's leg fillets no longer overhang the arms.
    - Top README: Rev 5 row.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
2026-10-25 Base Rev 3: chamfer only the lever's outside edges, whole 500 mm tube in a deeper socket, no tube lock screw
    The lever is chamfered before it is split, so the halves' mating faces stay sharp.
    The socket now ends 2.7 mm from the pivot axis, opening into the axial cable bore;
    the tube is used uncut and notched by hand. The M4 tube-lock hole and set screw are gone.
    Also carries the friction knob's hex-bolt pocket already in the working tree.
2026-10-25 BOM and Head READMEs: whole 500 mm tube, no tube lock screw
    The tube is used uncut and notched at its bottom end for the cables; the M4 x 6 tube-lock
    set screw line is gone. The BOM and the Rev 4 and Rev 5 READMEs also carry the other
    edits already in them.
2026-10-25 Head Rev 5 finished; Routed Gothic labels, base knob hex, cleanup, credits
    - Head/Rev5: symmetric toggles, hat centred at their height, labels locked
    per switch after the real panel (photo), STOP REL ring clear of the PB4
    bezel, Rev 4's 28 mm hat cap (looser, shallower leg sockets), neck cut
    back behind every switch (wire room), toggle cuts run to the rear wall,
    window from the STOP REL recess into the pinion pocket, no air behind
    the neck (fill capped square to the tube), 20 mm round cable opening,
    M3 x 16 panel screws in printed M3 threads 20 mm deep, printed threads
    in every M3+ hole, larger slot between the boxes. check_r5.py checks
    collisions, label clearances and the le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
2026-10-25 Remove the base 3MF; regenerate renders and GLBs (complete collective now with head Rev 5)
    Base screw maps show the knob's hex bolt, no tube lock; Rev 4, its hat and
    Rev 5 images re-made from the current STLs; three obsolete Rev 4 renders
    removed.
2026-10-25 Head Rev 5: 0.5 mm chamfer round the panels' front faces
    The upper panel's bottom edge, on the lower box, stays square. outline_chamfers()
    is shared with the rear wall's chamfer.
2026-10-25 Base Rev 3: M4 x 40 socket head cap lever screws, deeper friction nut
    The lever halves take four M4 x 40 socket head cap screws (HELIFOUNER M4 x 30-50 kit) at x = +-17,
    heads flush in counterbores at the top, nuts in hex pockets (corners along y) open to the
    underside, so the seats are about 40 mm apart. Halves are chamfered after the split, skipping
    the joint plane. The friction knob's M5 nut moves to the cap nuts' depth (z = -8.3) with an
    M5 x 25 hex bolt. Renders, GLBs, README and BOM rebuilt.
2026-10-26 Base Rev 3: strut collar rebuilt for the 40 N strut's measured rod end
    The strut's rod end has a 3.94 x 8 mm steel tab and a 8 mm boss 5.72 mm from the
    eye, which cannot enter the old slot. The collar now has a notch for the boss,
    is 40 mm long with a tapered web to an eye 6 mm closer to the tube (E 26, D 128),
    and a centred clamp screw. Balance within -4..+5 g at 40 N. Regenerated STL, STEP,
    GLB, balance plot, renders and README.
2026-10-26 Base Rev 3: two clamp screws on the strut collar
    Two M4 x 12 + nuts, 20 mm apart, in place of one mid-ring. BOM, README and
    renders updated (kit M4 x 12 2 -> 3, M4 nuts 13 -> 14).
2026-10-27 HeliSR Rev 4.0 PCB: AS5600 sensors over I2C through a PCA9546A
    Same outline, holes and Pro Micro position as Rev 3.0. The four analog AX
    inputs become 4-pin JST SH I2C ports (SDA, GND, VCC, SCL), each on its own
    PCA9546A channel. The mux, its cap and all the resistors are on the back:
    identical 2.2k pull-ups under each port, 10k on SDA/SCL and /RESET. The
    shift registers move to pins 14/15/A0, freeing pins 2/3 for TWI; A1
    resets the mux. The PROG buttons are gone. The input circuit is
    unchanged from Rev 3.0.
    DRC clean at every severity; the netlist is checked against Rev 3.0's
    board and the PCA9546A datasheet. Not ordered; the firmware needs a Rev 4
    build.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
2026-10-27 HeliSR Rev 4.0: 1206 resistors and caps on the back
    C4 and R1-R11 go from 0805 to 1206, so every resistor and capacitor on
    the board is 1206 (C4 is now the same part as C1/C2). The back parts are
    re-placed for the larger size and the board is re-routed (best of 45
    variants: complete, 44 router vias, no neck-downs). DRC clean at every
    severity with a new rule for RST's courtyard between the far-end ports;
    netlist check passes. The stitching search keeps a 0.05 mm margin over
    the hole-to-hole rule.
2026-10-28 Base: sensor carrier channel spans both AS5600 pad columns for I2C
    The module's pads are in two columns: VCC/OUT/GND along one edge and
    DIR/SCL/SDA/GPO along the other (measured off the listing's drawing).
    The wire channel under the board now spans both columns and the centre
    hole (18 x 13 mm, symmetric, so the module fits either way up and the
    DIR-to-VCC jumper lies in it), for HeliSR Rev 4.0's four I2C wires.
    Rebuilt with mk3_rev3.py: only sensor_carrier.stl, the reference
    sensor_pcb.stl and the STEP assembly change. README covers both the
    I2C (Rev 4.0) and analog (Rev 3.0) wiring.
2026-10-28 Head Rev 4/5: AS5600 wiring for HeliSR Rev 4.0's I2C ports
    The pod needs no change: it is open above the whole module between its
    side rails, so the SDA/SCL wires from the module's second pad column and
    the DIR jumper rise straight out like the others. The README's wiring
    and assembly steps now cover both I2C (Rev 4.0: VCC, GND, SDA, SCL,
    R4 removed) and analog (Rev 3.0: VCC, OUT, GND, PROG4). Rev 5 refers to
    Rev 4's README for these.
2026-10-28 HeliSR Rev 4.0 README: firmware JTAG and cross-flashing notes from the check
    A pin-by-pin check of the board against the 74HC165, PCA9546A, AS5600,
    Pro Micro and ATmega32U4 datasheets found no wiring errors. It adds to
    the Rev 4 firmware list: set JTD at start-up (A0/A1 are JTAG TDI/TDO),
    and keep Rev 3 and Rev 4 builds apart (a Rev 4 build on a Rev 3 board
    would drive pins against the board's outputs). Also a note on finding
    pin 1 when a JST jumper is cut in half for a lead.
2026-10-28 HeliSR Rev 4.0 support: firmware build and HeliSR Configurator
    Firmware (build.ps1 -Board 4.0; Rev 3.0 stays the default build):
    - 74HC165 chain on pin 14 (data), 15 (clock), A0 (load), same bit order
    - TWI on pins 2/3 at 100, 50, 25 or 10 kHz; PCA9546A at 0x70, channels
    2, 1, 3, 0 for AX1-AX4; /RESET on A1, only ever pulled low, to free a
    stuck bus (i2c.cpp)
    - AS5600 ANGLE read per port, one port per pass; ZPOS/MPOS written to the
    volatile registers at start-up from EEPROM settings, read back, never
    burnt (sensors.cpp); new SENSOR_STATUS and SENSOR_CONFIG commands
    - JTD set twice in MCUCR; A2/A3 as analog sources 9 and 10; no spare pin 14
    - every build carries a board tag in flash;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
2026-10-28 HeliSR Rev 4.0: test results from the bare Pro Micro, two fixes
    Ran the USB tests on the user's bare Pro Micro:
    - Rev 3.0 firmware (this branch): the board check refuses the Rev 4.0
    file; flash, INFO, hsr-usb-test, hsr-logic-test, lockstep 56/56,
    --roundtrip, --ui-device-test and --params pass
    - Rev 4.0 firmware: the same plus --sensors and --sensor-roundtrip (every
    port "no switch"; settings saved, kept through a restart, refused out of
    range); 150 B of stack never used under the app's polling
    Fixes: --params read past the 9-entry analog_inputs array and crashed;
    --sensor-roundtrip now also checks the settings survive a restart. The A2/A3
    scenario stays out of the lockstep trace (R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
2026-10-28 HeliSR Rev 4.0 README: AS5600 module prep checked against the datasheets
    Pull-up limit taken from TI's PCA9546A figures (6 mA at 0.6 V), so 4.7k or
    10k module pull-ups can stay; only under 2k need removing. Adds the 1 uF on
    VDD3V3 the AS5600 needs on 5 V, and says why R4 comes off (PGO low arms
    one-time OUT-pin programming).
2026-10-28 HeliSR Rev 4.0: write AS5600 CONF with each sensor's range
    The firmware relied on CONF's power-up value. A module with other
    settings burnt in (low-power mode, watchdog, filters) would have read
    differently. CONF is now written as 0, the chip's factory setting, 1 ms
    after MPOS, and checked on every read-back with ZPOS and MPOS. The
    read-back is 8 bytes instead of 4, so a pass grows from about 130 to
    about 170 I2C clocks.
    PC tests: the model has CONF and burnt-in settings; a new scenario
    covers burnt CONF, a brown-out bringing it back, and the unused top
    bits. 357 checks pass. Rev 4.0 builds: +58 B flash, RAM unchanged.
    Docs: module prep follows the datasheet check on main (pull-ups under
    2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
2026-10-28 Head Rev 5: grow the panel labels' strokes so they print
2026-10-28 HeliSR Rev 4.0: KiCad local files, as tracked for Rev 3.0
2026-10-28 Docs: HeliSR Rev 4.0 is the board to build
    The top-level README still pointed at Rev 3.0 throughout. It now lists
    Rev 4.0 first (Rev 3.0 kept as the previous board), its Gerbers and
    board BOM, the 4-core base lead, Rev 4.0's AS5600 prep, and setting the
    ranges over I2C instead of PROG buttons. Status says plainly that the
    Rev 4.0 firmware isn't in the repository yet, and that the collective
    BOM and Digi-Key CSV still list Rev 3.0's board parts.
    Also: Head Rev 5's README said the BOM lists Rev 4 (it lists Rev 5);
    Head Rev 4's parts list named only the Rev 3.0 board; profiles.md
    linked to Head/README.md, which no longer exists.
2026-10-28 BOM: HeliSR Rev 4.0 board, Rev 3.0's Digi-Key order counted as bought
    The collective BOM read its board parts from Rev 3.0. It now reads them
    from Rev 4.0's board BOM script, checked against Rev 4.0's board file.
    The Digi-Key order placed for Rev 3.0 is listed part by part
    and counted as bought, so the parts the boards share aren't ordered
    again. The Digi-Key CSV now holds only what's still to order: C4, the
    PCA9546A, 8 x 2.2k and 3 x 10k 1206, four BM04B headers, two 4-pin JST
    SR jumpers (455-3633-ND) and 1 m of 4-core shielded lead (Tensility
    30-00099; the black 30-00088 is out of stock until January).
    Rev 3.0's PCBs, 1k resistors, 3-pin headers and jumpers, two spare
    buttons and the 3-c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
2026-10-28 Packaging README: avrdude-packing's release is tagged 8.0-arduino.1
    The release checklist named it 8.0.0-arduino1, the IDE's name for the
    build; the repository's tag (and its source archive) is 8.0-arduino.1.
2026-10-28 Exploded views, screw maps and screw-size charts for base Rev 3 and head Rev 5
    renders/make_diagrams.py draws them from HeliCollective_Assembly.glb:
    splits every screw group into its screws and pulls each out along its
    axis. Head Rev 5 gets front and rear exploded views, four screw maps and
    a Screws section (it pointed at Rev 4's, whose panel screws differ). Both
    get a to-scale chart of every screw and nut. Base README: knob bolt is
    M5 x 25 in the assembly steps, and the collective GLB has head Rev 5.
2026-10-29 HeliSR Rev 4.0: AS5600 diagnostics (SENSOR_DEBUG) in firmware and helper
    A third sensor command reads one port's AS5600 in full when asked: the
    PCA9546A control register read back, ZMCO/ZPOS/MPOS/MANG/CONF, STATUS,
    RAW ANGLE, ANGLE, AGC and MAGNITUDE as the chip sent them, plus per-port
    counters the passes keep (range writes, range lost without a failed
    transfer, magnet faults, last failure, AGC min/max). Read only, never in
    the passes; the reply is built in the packet.
    The I2C helper gets a Diagnostics box (off by default, polled 4 times a
    second only while shown) with the registers decoded, the saved range
    compared, hints on the magnet and the cable, Clear counters and Copy.
    --sensor-debu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
2026-10-30 PLAN: AS5600 diagnostics tested on the bare Pro Micro, stack measured
    --sensor-debug, --sensor-roundtrip, --roundtrip and --params pass on the
    new Rev 4.0 build. The counters cost 24 B of stack margin (64 B vs 88 B
    for the previous build under two polling sessions); the command none.
2026-11-02 Head Rev 5 pinion: full-width teeth over a bottom shoulder
    The 45 degree chamfers at both faces left 3.2 mm of face at the pitch
    circle and 1.2 at the tips. Only the bottom face has to clear the grip's
    neck (0.2 mm at worst), so the bottom 0.6 mm is now a plain band at the
    root circle and the teeth run square to the top: 5.0 mm at every radius.
    The STL is turned over to print shoulder up; fit it shoulder down.
2026-11-02 Head Rev 5: pinion orientation in the README, renders redrawn
    The assembly GLB gets the new shouldered pinion (throttle_r5.pinion(), in
    use). make_diagrams.py re-draws the exploded views and screw maps from it,
    labels the pinion as going in shoulder down, and adds HueyHeadR5_Pinion.png:
    shoulder down in the head, shoulder up on the bed. The README says which
    way it prints and which way it fits.
2026-11-02 Head Rev 5 panels: 10 mm boxes round the toggles, no STOP REL recess
    Each toggle's recess on the panel's back is now a box 10 mm tall, so a
    toggle dropped down its bushing can't turn as its nuts are tightened. The
    walls are as thick as the head leaves room for (up to 2 mm, 0.25 mm clear;
    0.1 mm clear at the upper toggles' outer and top walls, which are only
    0.35 and 0.45 mm thick). STOP REL's 20 mm recess is gone: its nut sits on
    the plug, with 1.5 mm behind it. check_r5 passes. Panel STLs, the assembly
    GLB and the head renders regenerated; new panel-back renders.
2026-11-02 Head Rev 5 panels: 2 mm toggle boxes all round, upper toggles centred
    The boxes round the toggles were cut down to whatever a test slab found
    room for, and that slab ran past the boxes' corners into the screw
    columns, so the outer and top walls came out 0.35-0.55 mm. They're now
    2 mm all round, kept inside the plug's outline and cut back only at the
    corner columns' 7.2 mm reliefs. The upper toggles (and their labels) move
    down 1.4 mm to the panel's centre, which gives their top walls the full
    2 mm. check_r5 passes; panel STLs, the assembly GLB (upper toggles and
    nuts moved with them) and the head renders regenerated.
2026-11-02 Head Rev 5: redraw Front, Inside, Body and PocketWindow from the repo
    make_diagrams.py gains head_scenes(), which draws the four assembled
    views on navy from the assembly GLB, in the old renders' framing. They
    now show the centred upper toggles, the shouldered pinion and the panels
    as they are. Every image in Head/Rev5/renders now comes from the script;
    the README says so and how to put a changed part into the GLB.
2026-11-03 Head Rev 5: SEARCH CONT hat Rev 2, one switch at a time
    Rev 1 rocks on its set screw's tip, so a straight push clicks all four
    switches and a push between two directions clicks both. Rev 2's plate
    stands on eight feet on the switches' covers, held down by a pen spring
    on an M3 x 12 anchored in the carrier's key hole. A straight push moves
    nothing; a push toward a switch tips over its two feet; a push toward a
    diagonal tips over a line through the neighbouring buttons' centres,
    which domed pushers touch, so neither goes in (0.02 mm at most).
    New bezel (a ring), rocker plate, spring cup and cap; the panel, its
    carrier and the switches are unchanged. hat2_r5.py --check tips the
    plate every way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
2026-11-04 Base Rev 3: fixed 0 deg down-stop blocks instead of adjustable posts
    The two down-stop posts with head-up M4 x 16 screws, nuts and lock nuts
    are gone. In their place, two solid blocks are printed into the frame,
    topped at the pads' 0 deg height (z = -16). One runs into the friction-knob
    tower, the other into the sensor-side pillow block. Checked against the
    lever STLs: nothing overlaps from 0 to 32 deg, and at 0 deg both pads rest
    on their blocks (about 52 mm2 each).
    Frame STL, hardware ref and STEP regenerated; README, BOM script and xlsx
    updated (2 x M4 x 16 + 4 M4 nuts moved to Dropped); new render
    rev3_downstop.png.
2026-11-04 Base Rev 3: pad-sized down-stop pillars blended into the towers, corner gussets
    Each down-stop is now a pillar with exactly its pad's footprint
    (12 x 6.5 mm). The knob-side pillar runs straight on into the
    friction-knob tower. The sensor-side pillar tapers back in plan into
    the pillow block's front face, as wide as the pad where it meets it.
    Two triangular gussets added in the inside corners between the
    knob-side pillow block and the hinge-lug web / friction-knob tower,
    cut 3 mm clear of the hub and drum and kept under the shoe.
    Checked against the STLs: lever and frame clear from 0 to 32 deg; at
    0 deg both pads rest on their pillars (about 52 mm2 each); the shoe,
    felt, caps, covers and bo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
2026-11-04 Base Rev 3: 45 deg down-stop blend and mirrored corner gussets
    The sensor-side down-stop pillar is now its pad's footprint swept back at
    45 deg into the pillow block, so both sloping faces are parallel. The two
    knob-side inside-corner gussets are now mirror-image 45 deg triangles
    with 16 mm legs, matching the frame's other gussets.
    Checked against the STLs: lever and frame clear from 0 to 32 deg, pads
    rest on both pillars at 0 deg, and the shoe, felt, caps, covers and bolts
    clear the frame.
2026-11-04 Base Rev 3: wider shoe hinge lugs, centred on the hinge screw
    The hinge lugs and their web go from x 40..51 to 38..52, 14 mm wide and
    centred on the M4 hinge screw. That gives 2.7 mm of wall each side of the
    countersink (was 0.7 mm on the inner side) and 4.8 mm each side of the
    clearance hole, so no extra wall loops are needed. The back corner
    gusset follows the lug web's new inner face.
    Checked against the STLs: lever, shoe, felt, caps, covers and bolts
    still clear the frame; pads still rest on the down-stop pillars at 0 deg.
2026-11-04 Base Rev 3: full collision check, smaller friction knob, all renders redrawn
    Collision check of every pair of parts at 0, 8, 16, 24, 31.5 and 32 deg
    (lever group turned, collar/strut/pins rebuilt at each angle). The frame
    changes added none, but it found two that were already there: the 28 mm
    friction knob was hit by the knob-side down-stop pad and the socket boss
    from about 8 deg up, and its rim overlapped the shoe's arc. The knob is
    now 20 mm across and 2 mm further forward (x = -47): 1 mm clear of the
    pad and of the shoe. Shoe, frame, spring and bolt follow it. What's left
    are intended contacts (press fits, tapped threads, spring seats, clamp,
    felt, the cable under its plug).
    New Base/ma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
2026-11-04 Base Rev 3: the MkII friction knob, with an M5 pocket
    The friction knob is the MkII knob again (source/MkII-AdjustKnob.stl,
    restored from history), its outside unchanged: 18 mm across, 34 mm tall,
    fluted. mk3_rev3.py reads it and changes only its inside for the M5
    bolt: the M6 hex pocket is filled and an 8.1 mm M5 one cut in its place,
    and the floor's 6.5 mm hole becomes 5.4 mm M5 clearance. The bolt's head
    sits on the knob's 4 mm floor, so it is now an M5 x 30 (tip 4.2 mm past
    the nut). The knob stays at x = -47, 2 mm clear of the down-stop pad and
    outside the shoe's arc.
    Collision check unchanged apart from the spring's top coil seating on
    the knob's underside. STLs, STEP, both GLBs, all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
2026-11-04 Head Rev 5: SEARCH CONT hat Rev 3, a glued-on pod; lower panel with a plain hole and pins
2026-11-04 Head Rev 5: SEARCH CONT hat Rev 3, anvil version (alternative to 13a799a)
    A different take on the same Rev 3 brief: the lower panel keeps only a
    23 mm hole and three pins, and the hat is a pod glued on behind.
    - The rocker's square boss sits on a fixed octagonal anvil (2.6 mm out)
    in a square bore: a straight push goes into the anvil, sides click one
    switch, diagonals click both neighbours. The square boss stops it
    sliding or turning.
    - Switches 8.5 mm out (was 7), so a diagonal clicks by 10.2 deg even with
    the stiffest switch, against a 12.9 deg backstop (cap rim on panel).
    - M3 x 20 from behind through cup and pen spring into a nut in the stem.
    - Pod prints back down, rocker stem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
2026-11-05 Hat Rev 3 renders: show the spring cup and spring
    The cup was hidden behind the pod in the exploded view and the same blue as the
    pod in the section, and the spring wasn't drawn at all. Now the cup is green,
    the back stack is spread clear of the pod, the spring is a wire coil, and a new
    render shows the hat from behind with the cup in place. In the pushed section
    the cup slides with the screw, as it does in use.
    The check now also slides the loose cup to follow the tipped screw (up to
    1.3 mm) and confirms it hits nothing. The README says where the cup goes and
    not to glue it.
2026-11-05 Hat Rev 3 rocker: bigger square boss, so it can't twist
    The printed rocker turned in the pod's 6.6 mm bore far enough that its pushers
    nearly missed the buttons. The boss was a straight 6.0 mm square, 0.3 mm
    clear all round, which allowed 6 degrees of twist (0.9 mm at the pushers) in
    CAD and more in print.
    The boss is now 6.4 mm where it sits on the anvil (0.1 mm clear: 1.8 degrees,
    0.27 mm at the pushers) and tapers to 6.0 mm at the bore's mouth, so its
    sides still clear the bore at full tilt (0.05 mm at the least). The pod's
    bore is unchanged; only the rocker needs reprinting. The tilt check is
    unchanged: every mode still stops on the cap rim, and no third button moves.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
2026-11-05 Hat Rev 4: ALPS RKJXM1015004 on a breakout board, mounted on the lower panel
    The SEARCH CONT hat's next revision buys its 8-way action: an ALPS
    RKJXM1015004 8-direction stick switch with a centre push and its own stops
    (10 deg to a side, 12 to a diagonal).
    - PCB/SearchHat_Rev1.0: a 22 x 29 mm, 2-layer breakout for it. The switch is
    on the front, facing the panel; a 6-pin JST SH side-entry socket (J1) is on
    the back, and six 2 mm wire pads (J2) along the bottom. Four M2 holes.
    Generated by tools/gen_searchhat.py with hand-placed, crossing-free tracks
    and ground pours. kicad-cli DRC: no violations, nothing unconnected. Gerbers
    and pictures exported. Its outline and holes go to a JSO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
2026-11-05 check_r5: the USB-C cable and the sensor lead into the carbon tube
    The check modelled only the USB-C plug's overmold. It now also models:
    - the 25 x 23 mm carbon tube;
    - the plug's cable (4.5 mm, assumed) bending 20 degrees into the tube's axis;
    - the base sensor's 3.61 mm lead through the lip's 20 mm opening, 7.5 mm in
    front of the plug.
    All clear. The plug's end sits 5.4 mm inside the tube's top end. The plug and
    cable keep 1 mm from the body, the tube and the HeliSR. It also reports how
    long an overmold still fits: 12 x 7 up to 38 mm, 14 x 8 up to 35 mm.
    The head README's check section and the BOM's USB note now say so; the note
    said the clearances had only been checked with a micro-U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
2026-11-08 Cable cover retrofit: notch from the block face, slot filled
    For a base already assembled with the USB cable through the lever: a
    4.8 mm notch runs from the bore to the block-side face along the spout,
    so the cover goes on over the cable. No cable plug or M2 screw.
2026-11-08 Notched cable cover: square full-depth boss, prints without supports
2026-11-08 Notched cable cover: round boss, full cover depth across
2026-11-08 Base Rev 3: the notched cable cover is the only one; drop the cable plug
    The cable cover's notch runs from the bore to the block-side face, so it
    goes on over the USB cable after the lever is assembled. The slot under
    the spout, the cable plug and its M2 x 12 screw are gone. The spout is
    round, 15 mm across, flush with both faces.
    Rebuilt the STLs, STEP, GLBs, renders, exploded view and BOM. The render
    script now drops GLB parts that no longer have an STL.
2026-11-08 Narrow base concept: 82 mm wide, symmetrical lever, rear brake
    Concept only; Rev 3 is unchanged. 6808-2RS thin bearings, the AS5600
    inside the sensor trunnion, 10.5 mm covers, the USB cable out through
    the cable cover's rim, and a felt shoe on the back of the hub pushed by
    a rear knob. Script and renders in Base/concept_narrow.
2026-11-08 Base Rev 4: 82 mm wide, symmetrical lever, narrow brake between split up-stop lugs
    The base cut from 130 mm to 82 mm (3.25 in) along the pivot axis, the
    lever centred on the tube. 6808-2RS thin bearings, 9 mm pillow blocks
    with M3 caps, the AS5600 in a pocket in the sensor trunnion, 9.5 mm
    covers, and the USB cable out through the cable cover's rim.
    Brake: a 12 x 44 mm felt shoe on the back of the hub, pushed through a
    spring by Rev 3's knob and M5 x 30 bolt from a tower on the frame. The
    up-stop boss is slotted into two lugs that pass either side of it. The
    pocket lets the shoe stand back 10.5 mm while the lever is lowered in.
    Checks: every pair of parts clear from 0 to 32 deg, both stops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
2026-11-08 Base Rev 4: up-stop pad moved back, lugs reworked, corner gussets, fits
    - Up-stop: the pad moves behind the axis (x 14-29.5, full width, its
    back middle notched clear of the shoe, top at z -28.5). The lever's
    lugs land on it at x 15-24.4; at 0 deg they come 1.2 mm off the webs
    behind the pillow blocks, which is what limits how far back they go.
    The anchor clevis's back wall now runs level into the pad.
    - Eight 45 deg corner gussets, at both ends of both pillow blocks,
    inside and out; the two behind and inside are cut clear of the lugs'
    swing.
    - Fits from Rev 3 as built: the trunnion drops to bore + 0.1 (+0.2 was a
    hair tight); the seat stays at OD + 0.1. Coupon re-centred.
    - Se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
2026-11-08 Base Rev 4: enclosing shell, split no-slop brake pocket, narrow plate
    - One shell over the lever replaces the two bearing caps: its 9 mm side
    walls are the caps, joined by 3 mm front, back and top walls. The
    front and top are slotted from the lever's actual sweep (boss, tube,
    top gusset, down-stop pads) with 1 mm all round.
    - The brake shoe's pocket is split at the axis like a bearing seat:
    lower half in the frame, upper half in the shell, both 0.8 mm off the
    hub from x 24 back, 0.1 mm round the shoe. A back plate across both
    halves carries the M5 nut. The shoe goes in before the shell, so no
    stand-back space: the frame is 127 mm long (was 136).
    - Knob reprinted with its floor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
2026-11-08 Base Rev 4: shell's rear corners filled to match the frame; top view
    Behind the shell's back wall, either side of the brake housing, the
    shell now has the frame's outline up to its top: the webs out to the
    housing's back face and the 45 deg corner gussets. Adds a straight-down
    render of the whole base.
2026-11-08 Base Rev 4: one back chamfer through frame, shell and back plate; plate screws
    - The frame's and shell's fill behind each pillow block is one prism
    out to a single 45 deg chamfer plane (|y| + x = 69) from the blocks'
    outer back corners; the 2 mm step where the gusset met the web is gone.
    - The back plate is a trapezoid on that plane: the whole back face
    (43 mm) tapering to 26 mm, from just over the base plate to the
    shell's top.
    - No chamfers on the edges where frame, shell and plate meet, so no
    groove at the seams or along the inside of the shoe's pocket.
    - Six M3 x 16 at y = +-7: a pair each side of the bolt just clear of the
    pocket (z +-26, shell and frame), and a pair near th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
2026-11-08 Base Rev 4: back plate screws in three evenly spaced pairs, the middle pair at its centre
    The middle pair moves up to the plate's centre height (z -5.9), with the
    others 32.9 mm above and below (z +27 into the shell, -38.8 into the
    frame). The columns move out to y +-8.8: the shoe's pocket runs out
    through the back face 6.1 either side, so at +-7 the middle pair's pilots
    would break into it; at 8.8 there's 1.45 mm of wall, and the heads stay
    inside the plate's 13 mm back face. Adds a square-on view of the plate.
2026-11-08 Base Rev 4: strut anchor moved to balance the 45 N strut as bought
    Rev 3's anchor (x -12, z -40.5) balances a 40 N strut, the bottom of
    the 45 N strut's range, and the 45 N strut as bought lifts the lever
    (+50..+70 g at the grip). At x -9.5, z -36.5 the strut's line passes
    closer to the pivot: 45 N balances to within 3 g over the travel, the
    strut 119..140 mm in its 102..152 stroke. Clevis cheeks 6.5 mm round
    the eye (Rev 3: 8), 1.5 mm under the hub; its back wall runs 2 mm under
    the hub to the pad.
    Adds a Rev 4 balance report and plot (python mk3_rev4.py --balance).
    The strut touches the frame nowhere through the travel; the
    interference and assembly checks are clean.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
2026-11-08 Base Rev 3: strut anchor moved to balance the 45 N strut; clevis back walls solid (Rev 3 and 4)
    Rev 3's anchor (x -12, z -40.5) was sized for a 40 N strut, and the
    45 N strut as bought lifted the lever (+53..+72 g at the grip). It moves
    to Rev 4's x -9.5, z -36.5: the 45 N strut balances to -2..+2 g, the
    strut 119..140 mm in its stroke. Cheeks 6.5 mm round the eye (8 before),
    1.5 mm under the hub. Only the frame changes: reprint it.
    In both revisions the gap between the clevis's back walls is filled from
    1 mm behind the strut tab's round end to the pedestal/pad, so the walls
    print as one solid block with proper infill.
    Checked on Rev 3 (the lever unchamfered, since OCC's booleans fail
    sile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
2026-11-08 Current design is head Rev 5, base Rev 4, HeliSR Rev 4.0; every Rev 4 screw labelled
    - READMEs: base Rev 4 is the current base; Rev 3 is the first one built, with what the build taught.
    - BOM: base Rev 4's bought parts, kit counts and printed parts.
    - Collective model and pictures now show head Rev 5 on base Rev 4 (from make_renders_r4.py);
    make_renders_r3.py rebuilds only Rev 3's base model, and make_diagrams reads it for Rev 3's diagrams.
    - Base Rev 4: exploded view, screw-size chart, and screw maps that between them label every screw
    and nut: shell from above, lever, lever nuts, front, back, brake section, both sides, strut anchor.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
2026-11-09 Base Rev 4: trunnions to 40.0 with a seam relief; split trunnion coupon
    +0.1 on the 6808's bore was still too tight. The lever halves print on their joint
    faces, so elephant foot makes the trunnion widest right at the seam. The trunnions
    are now the bore's own 40.0 mm with a 0.5 mm x 45 deg chamfer along both seam edges
    in both halves (39.0 across the joint face). The trunnion coupon now prints split,
    on its joint faces like the lever, at 39.8 / 40.0 / 40.2.
2026-11-09 Base Rev 4: trunnions drawn out of round so they print round
    The first Rev 4 lever (drawn 40.1) measured 1.575 in across the joint and square
    to it, on the bearing's bore, but 1.585 in across the 45 deg diagonals: the
    half-trunnions print as arches on their joint faces and come out square-ish.
    So the seam relief (a wrong guess) is gone, and the trunnion's profile is 40.1
    across the axes and 0.25 less across the diagonals (TRUN_DIAG, r = R - 0.125
    sin^2 2th). The split trunnion coupon uses the same profile.
2026-11-09 Base Rev 4: drawing of the trunnion's profile (--trunnion)
    The first print as measured, the profile drawn now, and what it should print,
    as an exaggerated section and as diameter against angle.
2026-11-09 Base Rev 4: trunnion prints to the measured bore, 1.578 in
    The profile aimed at 1.575 in, the datasheet's 40.000 bore, which would have been
    0.003 in loose on the bearing as measured (1.578 in). It's now worked out from the
    readings in the script (TRUN_PRINTED, BORE_MEASURED, TRUN_FIT = 0): 40.18 mm across
    the axes and 39.92 across the diagonals, to print 1.578 in every way.
2026-11-09 Base Rev 4: trunnions back to round 40.1, as printed
    Reverts the trunnion compensation (seam relief, out-of-round profile, its drawing)
    and the split coupon: the lever and the trunnion coupon are as they were when the
    first Rev 4 lever was printed.
    This reverts d9fab20, e6fa273, e89e1be and b3c228d.
2026-11-09 Base Rev 4: fairing, knurled joint, M4 x 50 shell screws, strut flipped, clean openings
    - Lever: the back screws are back at Rev 3's x = +-17, all four M4 x 40. A 21 mm fairing
    runs top and bottom, from the clamp groove to tangent with the hub (in place of the 8 mm gusset).
    - Shell to frame: four M4 x 50 SHCS centred on the joint, nuts slid into the blocks' outer
    faces, flats-in. Bearing seats 52.0. A diamond knurl covers the whole joint, mirrored.
    - Front: the frame gets a front wall; one clean U opening through both walls, and a tapered
    top slot, both checked to contain the lever's sweep. A smooth slot for the strut cylinder.
    - Strut modelled as fitted: cylinder (12.07 mm) at the bas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
2026-11-09 Base Rev 4: square 5 mm side covers, AS5600 inset, USB tunnel
    The side covers are now square plates 5 mm thick (were round, 9.5 mm deep),
    65.5 mm tall about the axis, over the bearings and the shell screws' nut
    slots, their ends bevelled 45 deg on the planes of the back chamfer and the
    pillow blocks' front corner chamfer. Overall width 82 -> 73 mm.
    To get there the trunnions end flush with the bearings (29.5, was 32), the
    AS5600 board sits 2.5 mm deeper with it, the magnet moves into a pocket in
    the sensor cover's inside face (1 mm off the chip, as before), and the USB
    cable turns out of the axis inside the lip and runs back in a round tunnel,
    half in the +y pillow block's face and half in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
2026-11-09 Base Rev 4: relieve the hub for the strut's cylinder; checker cross-checks with a mesh
    Since the strut was flipped cylinder-down, its 12.07 mm cylinder starts 12 mm
    from the anchor pin and comes in under the front of the hub from 28 deg up,
    0.94 mm into it at the 32 deg stop. --check missed it: OCC's boolean returned
    0 for the chamfered lower lever half. The lower half now has a smooth relief
    for it (the cylinder, 1.5 mm bigger, swung about the collar's pin as the lever
    sees it): 2.65 mm deep at most, 11.6 mm wide. Clearance is now 1.64 mm or more
    from 0 to 32 deg.
    overlap() now runs a mesh boolean (manifold, 0.02 mm) beside OCC's and takes
    the larger. Parts that share a curved face (races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
2026-11-09 Base Rev 4 docs: 73 mm width, square 5 mm covers, inset sensor, USB tunnel, strut relief, coupon results
2026-11-09 Base Rev 4: USB cable bends 18 mm toward the front, in a pie relief in the trunnion's end
    The cable now turns toward the front on an 18 mm radius (was 4 mm, toward the
    back), starting inside the axial bore. Where the bend would rub the turning
    trunnion, a pie-shaped relief flares the bore's mouth: the bend, 0.5 mm
    bigger, revolved through the cable's way out as the lever sees it (0-32 deg,
    1 deg past each end), round-sided. 4.8 mm deep at the bore, out to 14 mm from
    the axis. The cable clears the trunnion by 0.5 mm at every angle and runs
    forward in the tunnel (block groove + cover channel), out through the cover's
    front bevel.
    Renders: rev4_usb_bend.png (cover off, 0 and 32 deg); width lab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
2026-11-09 Base Rev 4: lever split on the tube's plane, M4 x 35 joint behind the bearings, printed dowels
    Each half (lever_sensor, lever_cable) prints on its joint face, trunnion up, so each trunnion
    is one round piece. Four M4 x 35 socket heads run along the pivot axis on a 24.7 mm circle at
    +-50 deg, two heads and two nuts per half, diagonally; hollow printed dowels (lever_dowel, x4,
    7.5 x 4.5 x 8 in 7.6 holes 4.2 deep with 0.4 lead-ins) locate the halves. The cable half is
    chamfered and the sensor half is its mirror, so their outsides match; 0.3 mm chamfer on the
    joint face's outer edge only. The down-stop pads are filled in to the lower fairing. The old
    z-split M4 x 40s are gone. Dowel-hole coupon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
2026-11-09 Base Rev 4: lever openings follow the sweep 2 mm clear
    The frame's and shell's front walls and the shell's top wall now follow the
    lever's sweep from 0 to 32 deg, 2.05 mm off the socket boss, fairings, pads and
    hose clamp, in lines, arcs and ellipse arcs. check_openings() (--openings, and in
    --check) measures the true 3D distance every 0.25 deg, refined to 0.02 deg.
2026-11-09 Base Rev 4: hinged brake strap in place of the sliding shoe
    A felt-lined strap, 18 x 8 mm, wraps the back of the hub between the
    up-stop lugs, hinged on an M4 x 50 pin through the up-stop pad. Gussets
    run from the band into the head and down to the knuckle. The knob sits
    in a seat sunk into the shell's top; its M5 x 35 bolt leans 30 deg
    forward (41 mm of leverage about the hinge, against 12 for a vertical
    bolt) into a nut in the strap's head. The knob has a pocket for an
    optional spring. The shell is solid behind the hub; a ramp in its bay
    swings the leaning strap onto the hub as the shell goes on.
    The shoe, its tunnel and housing, the spring cap, the back plate and
    its screws, and the shoe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
2026-11-09 Base Rev 4: longer brake felt, 52 deg below the axis to 40 above
    The strap's band now runs from 54 deg below the axis to 42 above (the
    felt from 52 to 40, 16 x 51 mm): down into the up-stop pad's slot and
    into the knuckle, and up under the head, its top end cut off level with
    the head's face. The head's gusset takes the band from 12 deg up.
    To let the hub drop past the felt's top end, the strap now leans back
    8 deg onto the frame bay's back wall (was 4), and the frame's and
    shell's back face moves from x 52.5 to 56.5 so the shell's ramp can
    still catch the leaning head. Drag 9.3 / 11.1 N.mm per N up / down;
    band 17 MPa at 400 N. --check is clean. Adds a render of the lever
    going in past the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
2026-11-09 Base Rev 4: regenerate STLs, STEP, coupons, renders and BOM; drop the old brake's and lever's outputs
    Every printed part rebuilt valid: frame, shell, lever_sensor, lever_cable,
    lever_dowel (print 4), strap, covers, collar, knob. Coupons: trunnion, seat,
    dowel hole. Balance unchanged (45 N: -3..+1 g at the grip). All renders,
    screw maps, the exploded view and the screw chart redrawn; new views of the
    split lever, the strut relief, the USB bend and the strap.
    Removed what nothing makes any more: lever_upper/lower, shoe, spring_cap,
    back_plate, knob_spring, the shoe-pocket coupon, the old lever-screw and
    back-plate renders, and the first strap concept's renders. README: the
    opening note now sa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
2026-11-10 Base Rev 4: brake strap hinged forward, on the strut clevis's rib
    The user's idea: the strap's hinge moves from behind the hub (24, -38)
    to under it at x 5, z -40, just behind the strut clevis's cheeks. The
    strap's swing now presses the felt evenly (its bottom end gets half the
    middle's pressure, against a tenth), and the knob's bolt passes 58.6 mm
    from the hinge (41 before).
    The strap's arm runs forward under the hub through the up-stop pad's
    slot and forks into two 4.5 mm cheeks either side of the clevis's back
    block, cut down to a 6 mm rib there, so everything stays inside the
    slot, clear of the up-stop lugs. The M4 x 50 pin goes through the
    pillow blocks, a web inside each and the rib,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
2026-11-10 Base Rev 4: side covers bevelled 45 deg top and bottom; outputs for the forward hinge
    The side covers are now bevelled 45 deg all round: the top on the plane of
    the shell's 0.8 mm top-edge chamfer, so it runs straight into the shell's top
    corner, and the bottom its mirror image (inside face 74.4 mm tall, outside
    64.4). The USB side's cover now hides the strut anchor's hex-key hole, as the
    user chose: the assembly order fits the strut's anchor end before the covers.
    Regenerated every STL, the STEP, the renders and the BOM for the forward
    hinge (30711c4) and the covers. --check clean: interference at 0-32 deg,
    brake clearances, strap-first assembly, openings 2.05 mm.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
2026-11-10 Remove HeliSR Rev 3.0; flatten PCB/HeliSR and PCB/SearchHat
    The BOM's Rev 3.0 order data moves to BOM/helisr_rev30_order.py (the Digi-Key
    order still counts as bought); Rev 3.0's input map moves beside the Rev 4.0
    netlist checker that reads it. Other path references are fixed in later commits.
2026-11-10 Head: keep only Rev 5 with the SearchHat, flattened into Head/
    - Delete head Rev 4 and search hats 1-3 (scripts, renders, STLs, README
    sections). Hat 4 (ALPS RKJXM1015004 on the SearchHat board) is the hat:
    its panel is now HueyHeadR5-LowerPanel-Black/-WhiteText and its cap
    HueyHeadR5-Hat-Cap; huey_head_r5.py writes them with the rest.
    - Move Head/Rev5/* up into Head/; fix the font, PCB/SearchHat mech json and
    Hat paths. Fold the knob and render helpers hat 4 used from hats 1 and 2
    into hat4_r5.py and render_hat4.py; drop the dead MkII panel and hat code.
    - README stands alone: one piece, friction knob (hotpretzel, CC BY-NC),
    starter trigger and stop, controls, throttle, wiring,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
2026-11-10 Software: HeliSR Rev 4.0 only; drop Rev 3.0 support
    Firmware: one build (build.ps1 loses -Board); the Rev 3.0 pin map, analog
    AX path and HSR_BOARD_REV selection are gone. The settings layout, live
    data, protocol and the 0x40 build tag are unchanged.
    Configurator: no board choice, no PROG1/PROG4 helper (as5600helper.*
    deleted); a device or .hex tagged for another board is refused; --board
    takes only 4.0; one bundled HeliSR_Rev4.0_16MHz.hex.
    Packaging, docs, README, PLAN and NOTICE updated to match; board links
    point at PCB/HeliSR.
2026-11-10 PCB: keep Rev 3.0's board file for the Rev 4.0 netlist check; fix SearchHat links to the flattened head
    verify_netlist_v4.py compares the parts carried over from Rev 3.0 against that board, so its .kicad_pcb stays in
    PCB/HeliSR/tools as a reference (netlist OK, re-run). SearchHat README points at Head/Hat and Head/check_r5.py.
2026-11-10 Base: keep only Rev 4, flattened from Base/Rev4 into Base
    Rev 3's outputs and README are gone (stl/, step/MkIII_Rev3_assembly.step,
    renders/, README.md). mk3_pivot.py, mk3_rev3.py and make_renders_r3.py stay
    as the shared library Rev 4 builds on, without their build entry points.
    Rev 4's README, scripts, STLs, STEP and renders move up into Base/; its README
    takes in Rev 3's sensor wiring, coupon instructions, strut and tube notes and
    the assembly steps it pointed to. Colours come from a table instead of Rev 3's
    GLB; the Rev 3 comparison render is dropped. The tube socket coupon is written
    by mk3_rev4.py --coupons. The collective's head is built from Head/stl and the
    hat script (hat 4), its b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
2026-11-10 BOM, root README and renders for the current revisions only
    BOM: paths for the flattened Base/, Head/, PCB/HeliSR and PCB/SearchHat; the
    head's panel and cap are hat 4's (LowerPanel-*, Hat-Cap); the tube socket
    coupon is a current coupon; design rows drop Head Rev 4, Base Rev 3 and the
    Rev 3.0 board folder (its order data stays, in BOM/helisr_rev30_order.py).
    Every repo path the BOM names exists; every printed STL is on the print sheet.
    Root README: one row per current design, steps point at the flattened READMEs,
    the hat is the ALPS stick, the software is Rev 4.0 only.
    Renders: the collective (head built from Head/stl, with hat 4) and the head's
    diagrams regenerated. Every Markdown link a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
2026-11-12 One BOM: fold the board BOM, Rev 3.0 order data and Digi-Key CSV into Heli_Collective_Final_BOM.xlsx
    make_final_bom.py now holds the board's part list (still checked against the board file) and the Rev 3.0 cart
    itself, and no longer writes a CSV: the workbook's Digi-Key order sheet uploads to Digi-Key's BOM Manager.
2026-11-12 BOM: drop the Digi-Key order sheet, which repeated the Final BOM's Digi-Key lines
2026-11-12 Move the BOM script to tools/: the BOM folder holds only the BOM
2026-11-12 BOM: count the Mouser orders of 2026-11-01 and 11-05 as bought; drop the Dropped sheet
    U3, R1-R11, the extra 100 nF caps, J11-J14, the AX1/AX4 jumpers, the hat's ALPS stick, the SearchHat
    header and its jumper are now marked ordered with the parts and prices from the invoices. The BOM lists
    only parts this build uses.
2026-11-12 BOM: the AX1 sensor lead is the 4-way 24 AWG ribbon cable bought from Mouser
2026-11-12 BOM: a Done tick box on every line that strikes the line through
    Excel's cell checkbox (Microsoft 365), added after openpyxl saves; a conditional format greys and strikes the
    row when it's ticked. On the Final BOM and Printed parts sheets.
2026-11-12 BOM: classic form checkboxes for the Done column, so they work in OpenOffice
    Excel 365's cell checkbox showed as ### in OpenOffice. These are VML form checkboxes linked to a hidden column;
    checked in OpenOffice 4.1: every box loads linked to its own row, and ticking one strikes the line through.
2026-11-12 Public BOM: one simple parts list, every electronic part in stock at Mouser
    Heli_Collective_BOM.xlsx replaces the old BOM: where each part goes, part numbers, supplier and link, how many to
    buy (the cheapest quantity at the price breaks), unit price, Mouser's tariff estimate and the total. Digi-Key parts
    are replaced with in-stock Mouser parts (onsemi MC74HC165ADR2G, Harwin M20-7821246 sockets, APEM 637NH/2, a 12 in
    10-pin jumper, BM04B-SRSS-G-TB). Order records and purchase tracking are gone; the supplies the old list left out
    (hose clamp, felt, spring, desk screws, glues, taps, drill) are in. READMEs and comments follow.
2026-11-12 Base Rev 4: tube lock, AS5600 screw posts, strut collar clamped from below
    - Tube lock: an M4 x 35 socket head straight across the lever through the
    carbon tube's centre line, in bosses built up over the down-stop pads.
    Head recessed in the left (-y) boss, nut in the right (+y). The front
    opening's reliefs run up to 33.8 mm to clear the bosses (2.05 mm).
    - AS5600: four M2 x 8 countersunk screws through the module's corner holes
    (16.26 x 16.0 mm, measured) into 1.6 mm pilots in posts in the sensor
    pocket. Replaces the hot glue.
    - Strut collar: split along the bottom, no ears or screws on top. The strut's
    eye screw and a second M4 x 16 in front of it close the cheeks; heads on
    th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
2026-11-13 Base Rev 4: tube drill guide for the tube lock's hole
    A one-piece block over the tube's lever end, the tube's end against its
    closed end, guiding a 4.5 mm bit 43.3 mm from the tube's end. Its drilling
    faces are 42.5 mm from the tube's axis, the same as the head's side walls,
    so head and guide lie flat on one table and the hole comes out square to
    the head. 30 mm of guide each side before the tube; drill one wall, turn
    the tube over, drill the other. Windows mark the cable notches in line with
    the hole; an M4 x 12 in a tapped hole clamps it. README, BOM and render.
2026-11-13 Drill guide: 1/2 in walls, 50.8 mm square, solid but for the bore and the two drill holes
2026-11-13 BOM: every screw and nut from MonsterBolts in packs of 10
    Black-oxide 12.9 hex socket screws, 14.9 set screws, plain DIN 934 nuts, a stainless M5 x 35 hex bolt (not sold
    in black) and M2 x 8 Phillips flat heads (no small pack of M2 countersunk with a hex or star drive): $22.79 for
    the lot, against about $47 for the four Amazon kits it replaces. READMEs, comments and render labels follow.
2026-11-13 Renders: screw charts, maps and the lever's exploded page name MonsterBolts
2026-11-13 BOM: low-profile pin headers for J7/J8 and the Pro Micro
    Standard headers stood too tall for the USB cable in the head. The DIYhz 1x40 set (platinum-plated male pins, tin
    female sockets) replaces the Harwin sockets and the Pro Micro's own pins.
2026-11-13 BOM: the low-profile header set's Amazon listing (B07BS126FK)
2026-11-13 BOM: GOV RPM toggle back to the APEM 637H/2 the head is built with
    The black sealed 637NH/2 was only a stand-in while Mouser is out of the 637H/2; the line notes the back-order and
    Digi-Key's stock.
2026-11-13 BOM: no desk screws; hose clamp, brake spring and felt sourced locally
2026-11-13 Base renders without the desk screws; BOM script prices the 6808-2RS bearings (HARFINGTON pair, B0CGM4BY2K)
2026-11-13 BOM: rebuilt with the bearings priced
2026-11-13 BOM script: drop the tap set and the drill bit
2026-11-13 BOM script: greases, glues and threadlocker sourced locally
2026-11-13 BOM script: solder paste in the HeliSR board section
2026-11-13 BOM: rebuilt (no taps or drill, local supplies, solder paste with the board)
